theOfficial-IrvinGiL/Thesis-1-and-2-Documentations-and-Papers/notes/Question and answer on Thesis By Groupmates.txt

1. In few sentences, can you tell us what your study is all about?
2. What is your motivation for this study?
3. What is the significance of the study?
4. Did you bridge any gap from your study?
5. What limitations did you encounter?
7. What Methods or Sampling Technique did you employ?
8. Why choose this method(#7)?
10.  What are your research questions?
11. What are your research variables?
12. What theories or theoretical framework is your study based on?
13. What is the scope of the study?

How did you come up with your proposal?

Ang mga materials ba na atu gamiton available?

Unsay possible nga downside sa study?
