theOfficial-IrvinGiL/Thesis-1-and-2-Documentations-and-Papers/TASK_members/April 25 task.docx

Task: Documenting code in flowchart format

Description: Read and understand the code on the repositories and create a flowchart showing the methods and conditional statements that are written on the code. Use flow2code online application for easy flowchart documentation: https://code2flow.com/

Read the code on the zip file attached on the email.

Example:

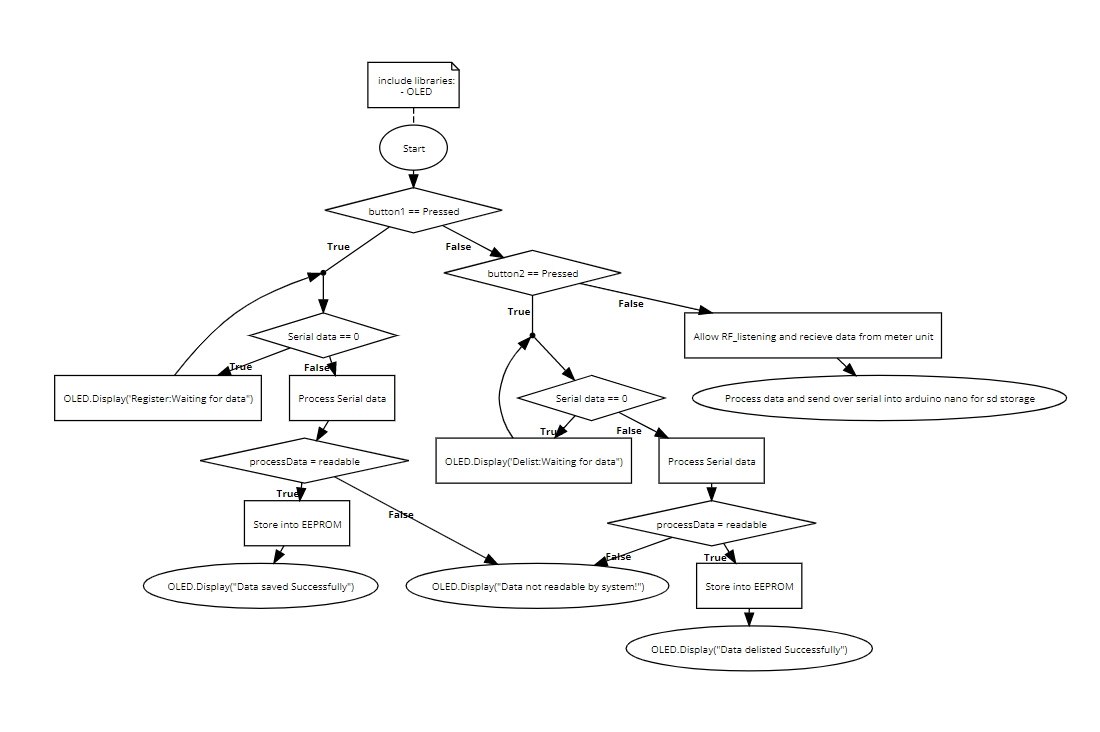
[picture p9: figure]

Assignees:

Main unit:

  - Mark Neil
  - Benjie
  - Michelle Ann

Meter Unit:

  - Lyndon
  - Renante
