theOfficial-IrvinGiL/Thesis-1-and-2-Documentations-and-Papers/TASK_members/Tasks compilation.docx

Task: March 28, 2022

Goal: Controlling Power on Arduino nano using MOSFET transistor

Direction:

1. Write code on the Arduino nano to write a few texts words on the sd card. (Just for sample). When turned on it continuously write words to the sd card with a 3 second delay. *mao ra na sija ang code nga anaa sa Arduino nano jud
2. Next, write a code on the Arduino nano to control the power on the Arduino nano by triggering a push button switch
  a. Push the switch and turn the Arduino nano on for it to write to the sd card
3. Inspect the sd card if It has written the correct data.

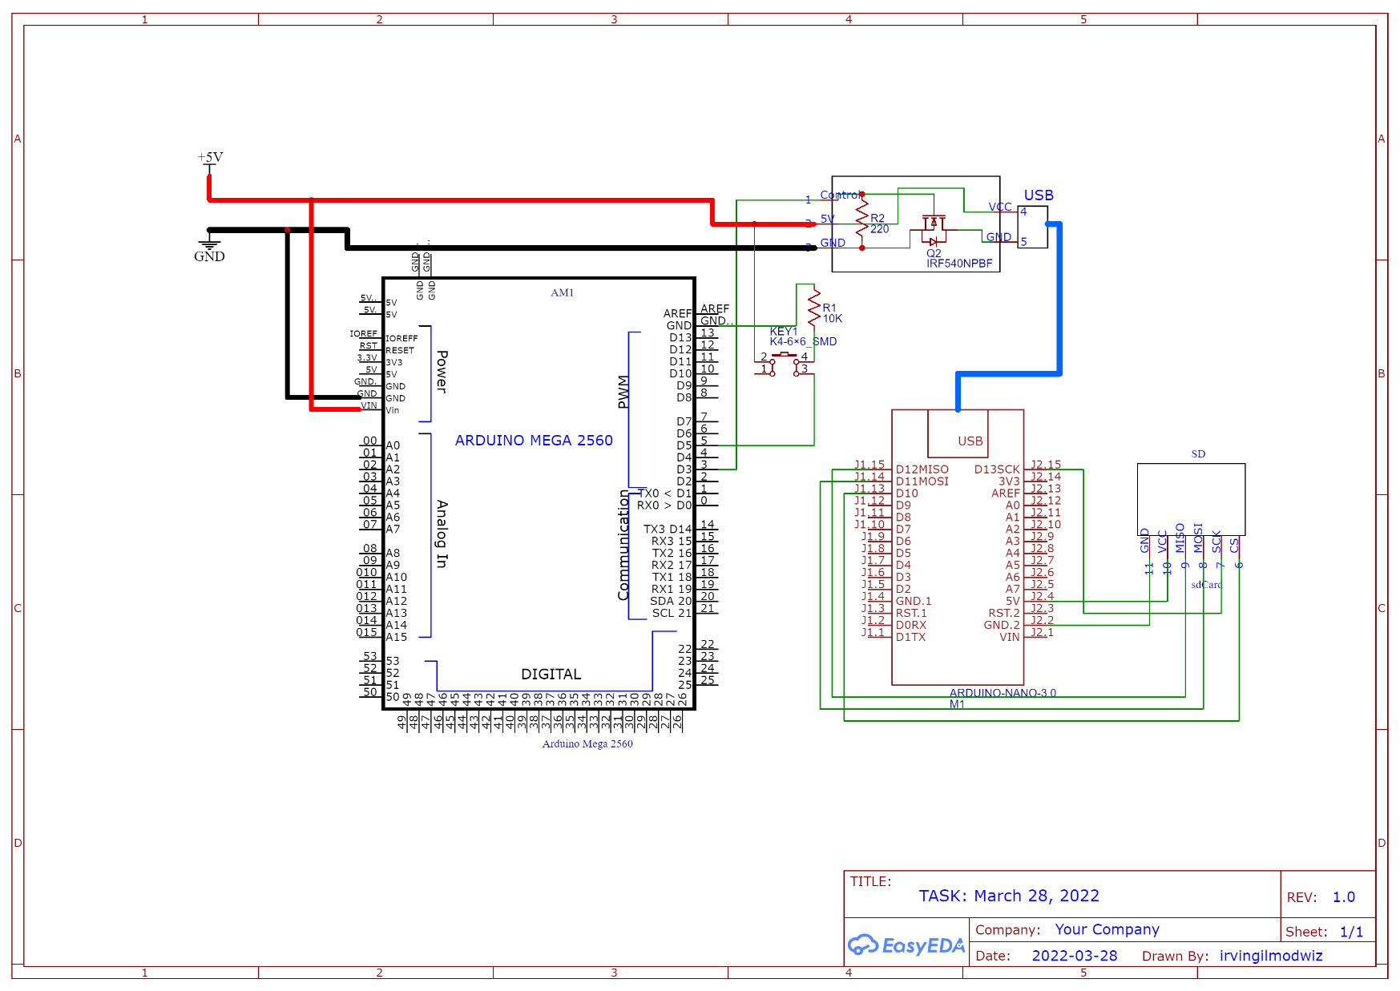
[picture p10: figure]
