theOfficial-IrvinGiL/Thesis-1-and-2-Documentations-and-Papers/notes/User interface and User Experience design for the software of the system..pdf

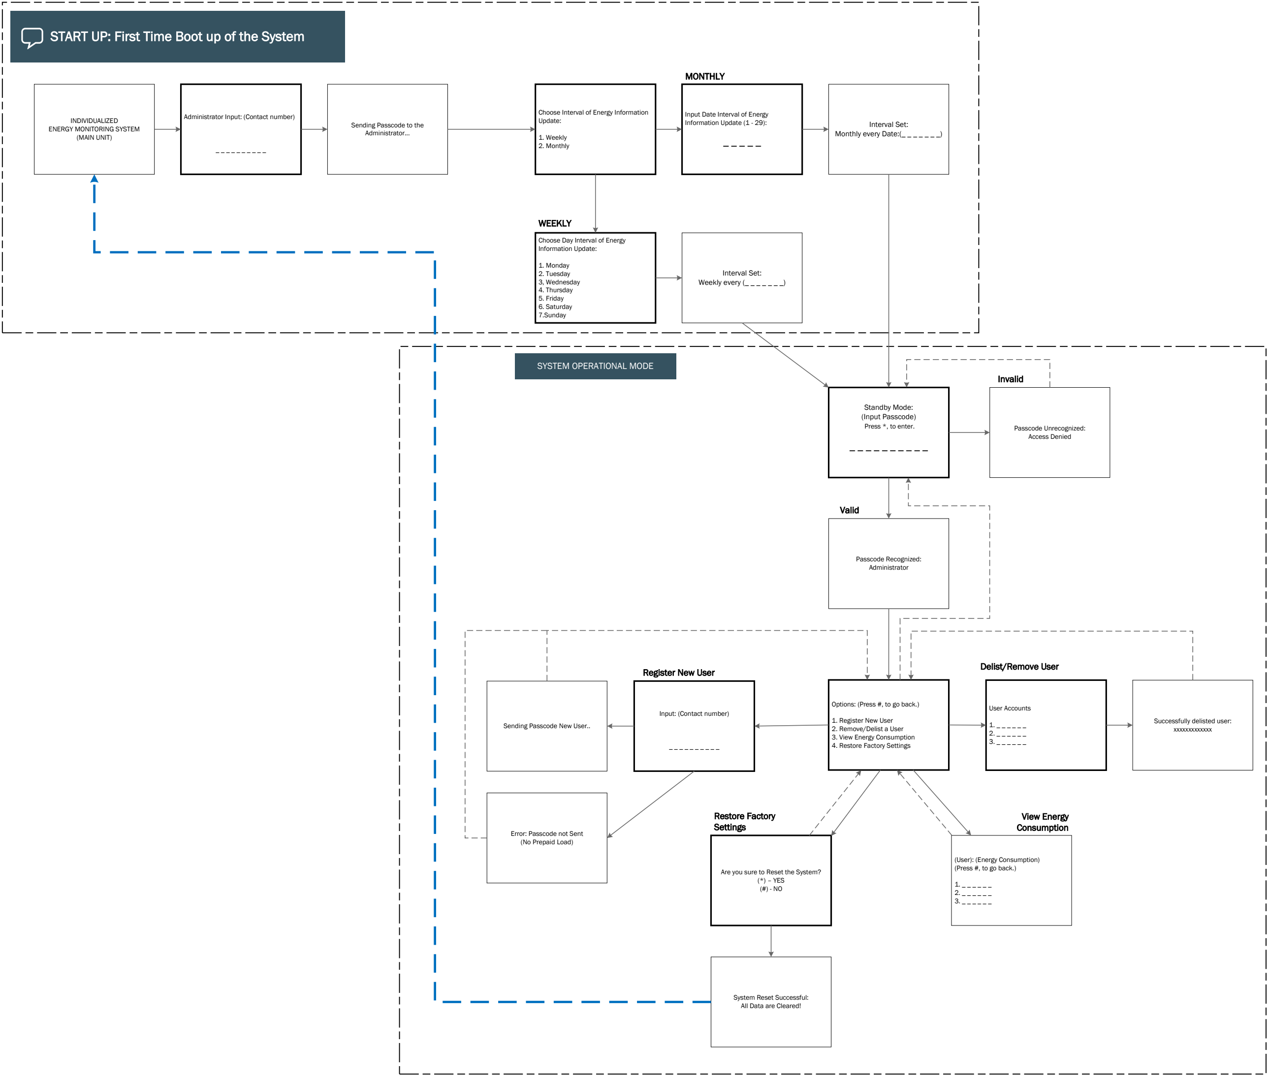
[picture p19: figure]
INDIVIDUALIZED ENERGY MONITORING SYSTEM (MAIN UNIT); Administrator Input: (Contact number); Sending Passcode to the Administrator...; Choose Interval of Energy Information Update:; 1. Weekly 2. Monthly; Choose Day Interval of Energy Information Update:; 1. Monday 2. Tuesday 3, Wednesday 4. Thursday 5. Friday 6. Saturday 7.Sunday; Input Date Interval of Energy Information Update (1 - 29):; MONTHLY; WEEKLY; Interval Set: Weekly every (_ _ _ _ _ _ _); Interval Set: Monthly every Date:(_ _ _ _ _ _ _); Standby Mode: (Input Passcode); Press *, to enter.; Options: (Press #, to go back.)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

# START UP: First Time Boot up of the System

# Main Unit_User Experience

## METER UNIT

# Main Unit_User Experience

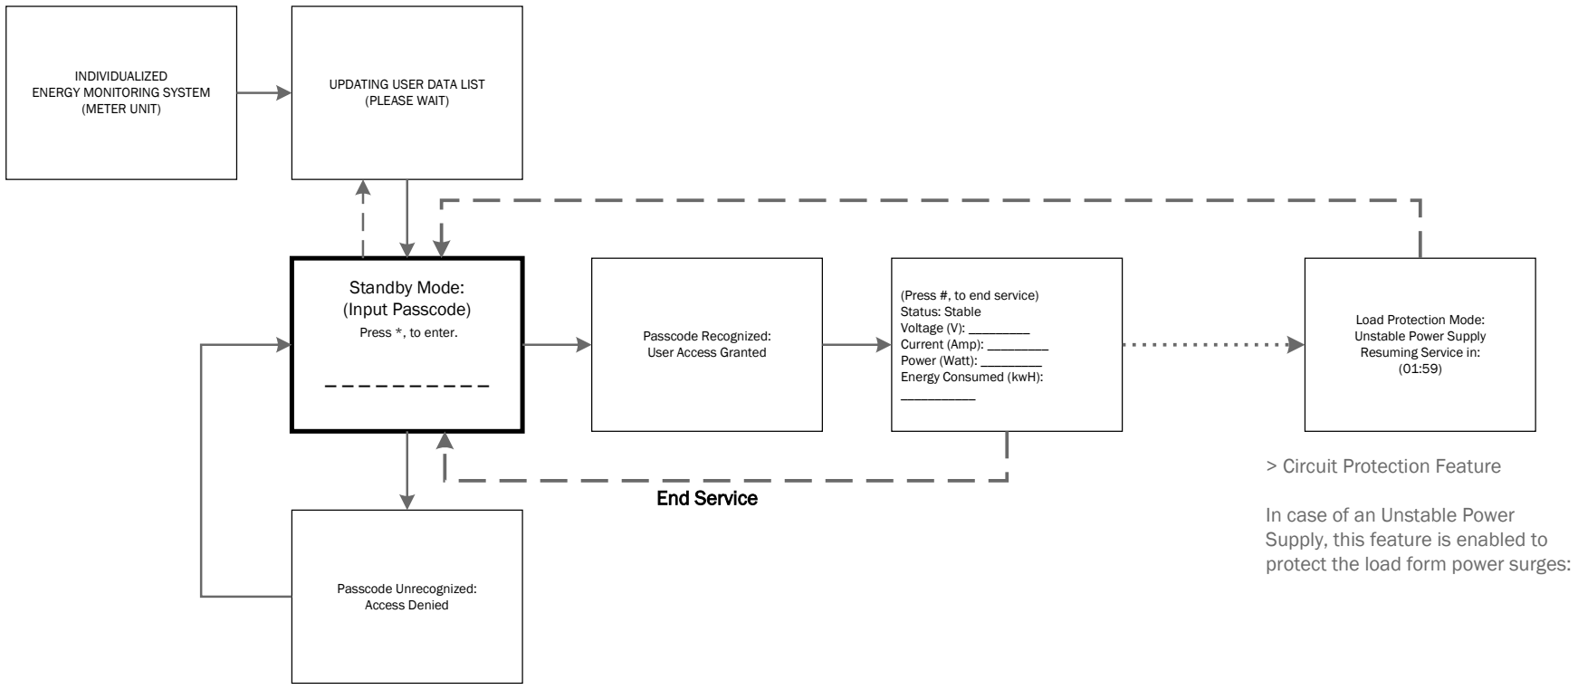
[picture p20: figure]
INDIVIDUALIZED ENERGY MONITORING SYSTEM (METER UNIT); Standby Mode: (Input Passcode); Press *, to enter.; UPDATING USER DATA LIST (PLEASE WAIT); Passcode Recognized: User Access Granted; Passcode Unrecognized: Access Denied; (Press #, to end service) Status: Stable Voltage (V): _________ Current (Amp): _________ Power (Watt): _________ Energy Consumed (kwH): ___________; End Service; Load Protection Mode: Unstable Power Supply Resuming Service in: (01:59); > Circuit Protection Feature; In case of an Unstable Power Supply, this feature is enabled to protect the load form power surges:
