theOfficial-IrvinGiL/Thesis-1-and-2-Documentations-and-Papers/CAD and System Schematics/Diagrams/for methods.pdf

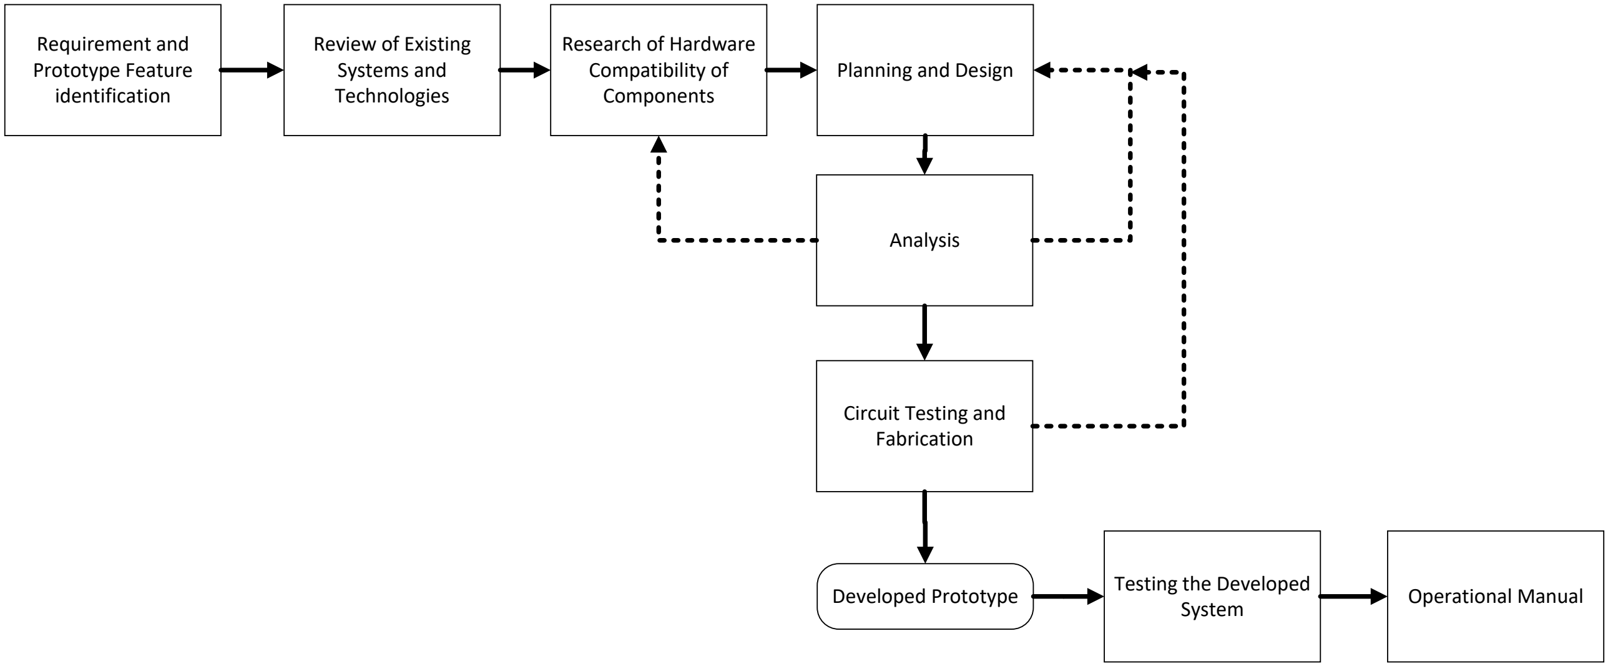
[picture p21: figure]
Requirement and Prototype Feature identification; Review of Existing Systems and Technologies; Research of Hardware Compatibility of Components; Analysis; Planning and Design; Circuit Testing and Fabrication; Developed Prototype; Testing the Developed System; Operational Manual

AC Power | Meter Unit
Smart Meter Main Unit | SMS Notification | Registered User

Electrical Load/
Gadgets and
Appliances

User Data Input
