theOfficial-IrvinGiL/Thesis-1-and-2-Documentations-and-Papers/CAD and System Schematics/new diagrams_REvised/Meter Unit.pdf

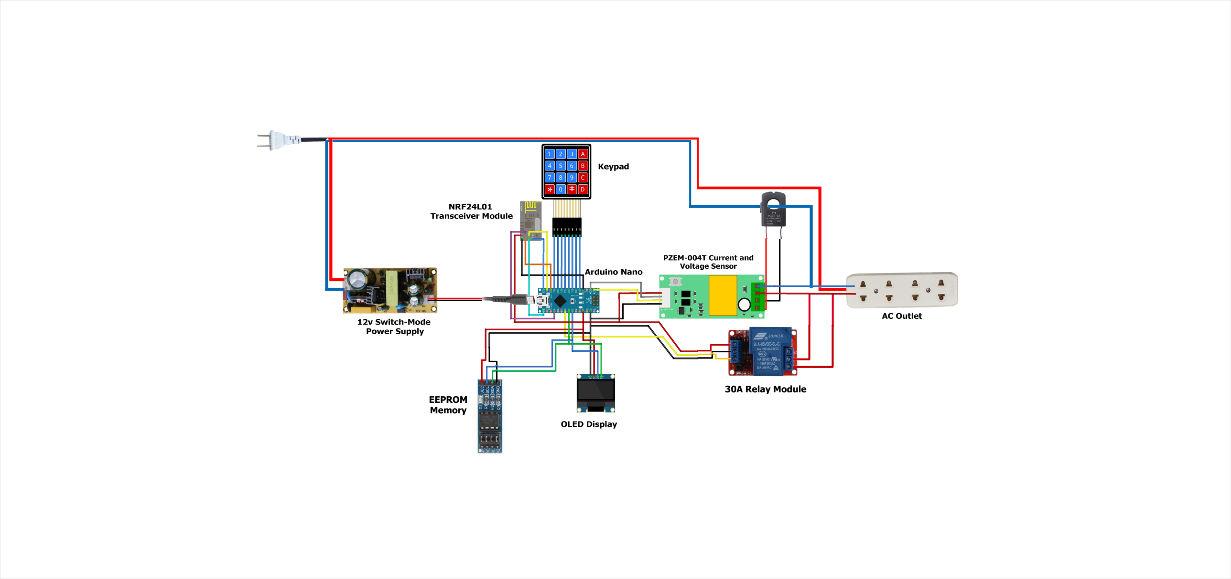
[picture p22: page 1]

EEPROM
Memory

30A Relay Module
