theOfficial-IrvinGiL/Thesis-1-and-2-Documentations-and-Papers/Main papers/concept diagrams for thesis methodology.pdf

Concept Design 1: Centralized Approach

Concept of Usage

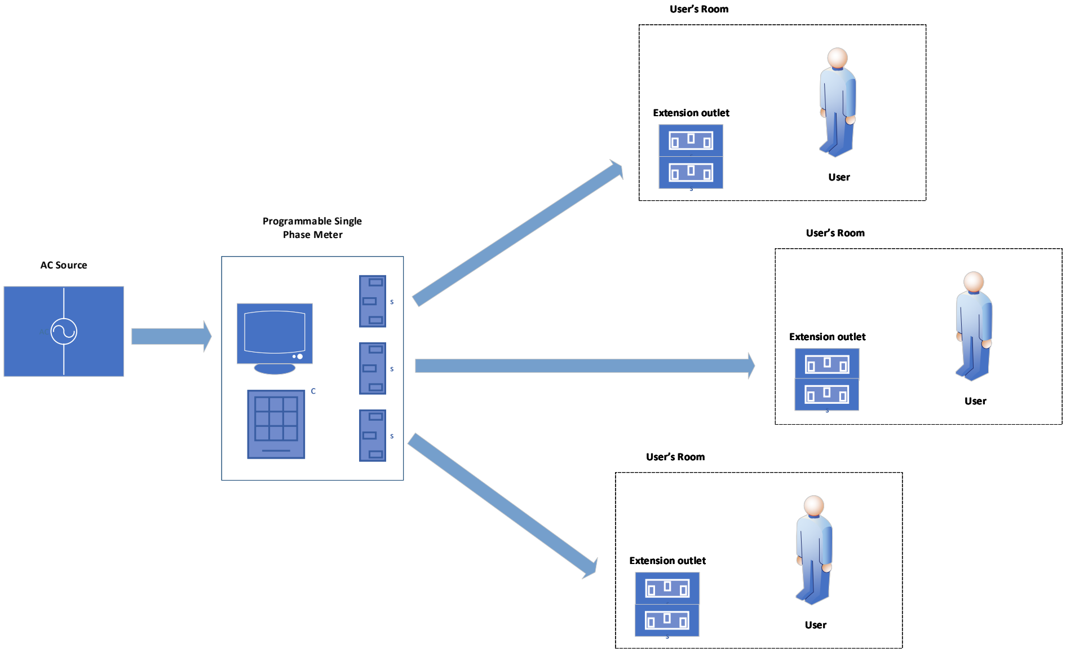
[picture p23: figure]
AC Source; Programmable Single Phase Meter; Extension outlet; User; User’s Room

Problems and Challenges

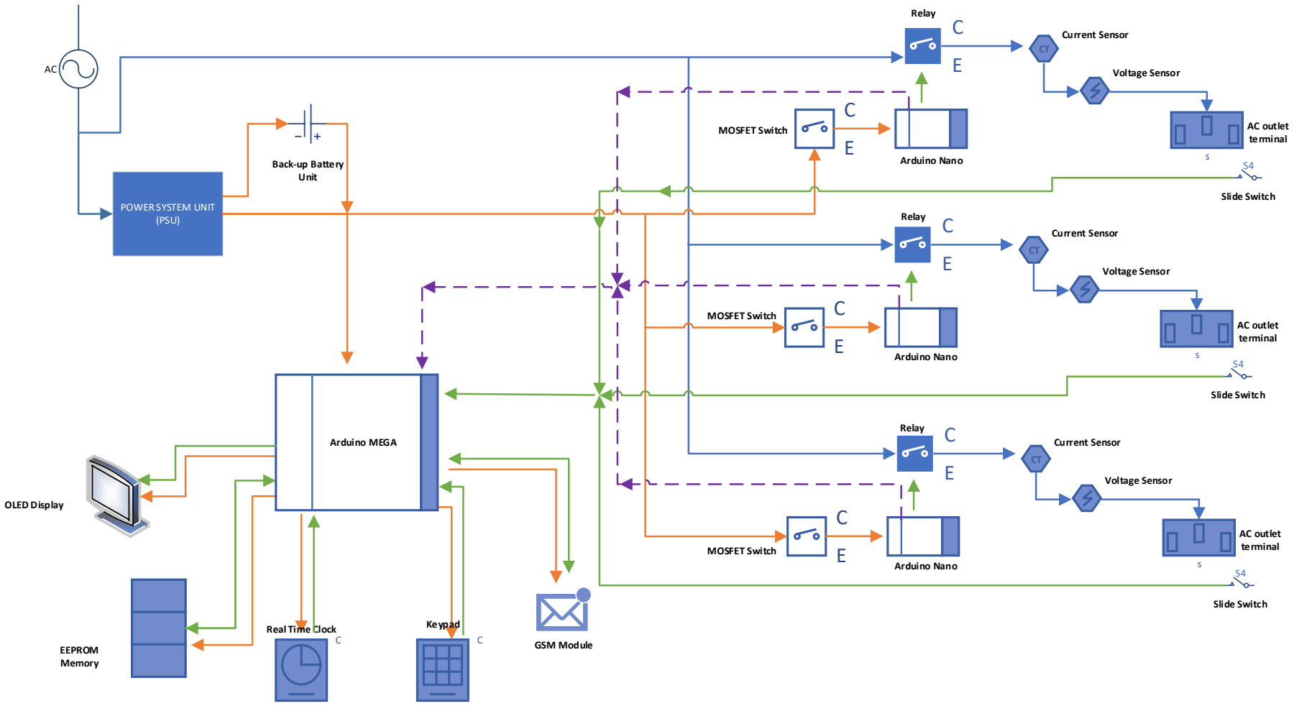
[picture p24: figure]
POWER SYSTEM UNIT (PSU); OLED Display; EEPROM Memory; Real Time Clock; Keypad; GSM Module; Back-up Battery Unit; Arduino MEGA; Current Sensor; Voltage Sensor; AC outlet terminal; Slide Switch; Arduino Nano; Relay; MOSFET Switch

Problems on the design and implementation of the prototype are:
1. How would the meter measure the simultaneous usage of different outlet by different users on the shared house?
2. It would be a hassle for the users of the system if they have to go to the location of the prototype to enter their code so they can access electricity.
3. The design’s scope of functionality could be limited and overwhelmed by the user expectation.
4. Take for am example scenario of:
Outlets (red circle) are in placement throughout the shared house and the smart meter (green circle) is placed on the middle side of the shared house. It is a hassle for the tenants to go to the meter evertime they would access electricity.

This Approach focuses all processes unto a single prototype, meaning all calculation and processes are integrated into one device. The systems allows only extension chords unto the room of different users. But this system shows the difficulty and lack of ease of use as the users have to go to the meter of request for validation and access to electricity.

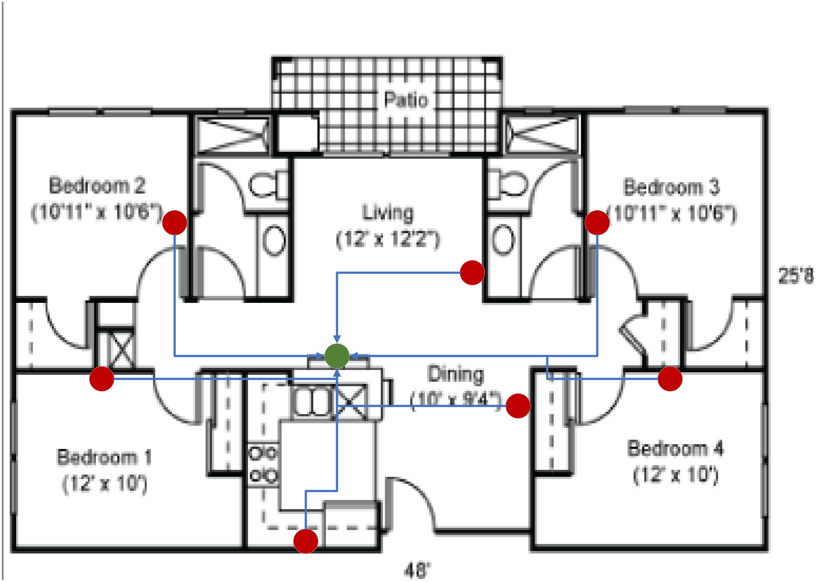
[picture p25: figure]

Concept Design 2: Wireless Client and Server Approach

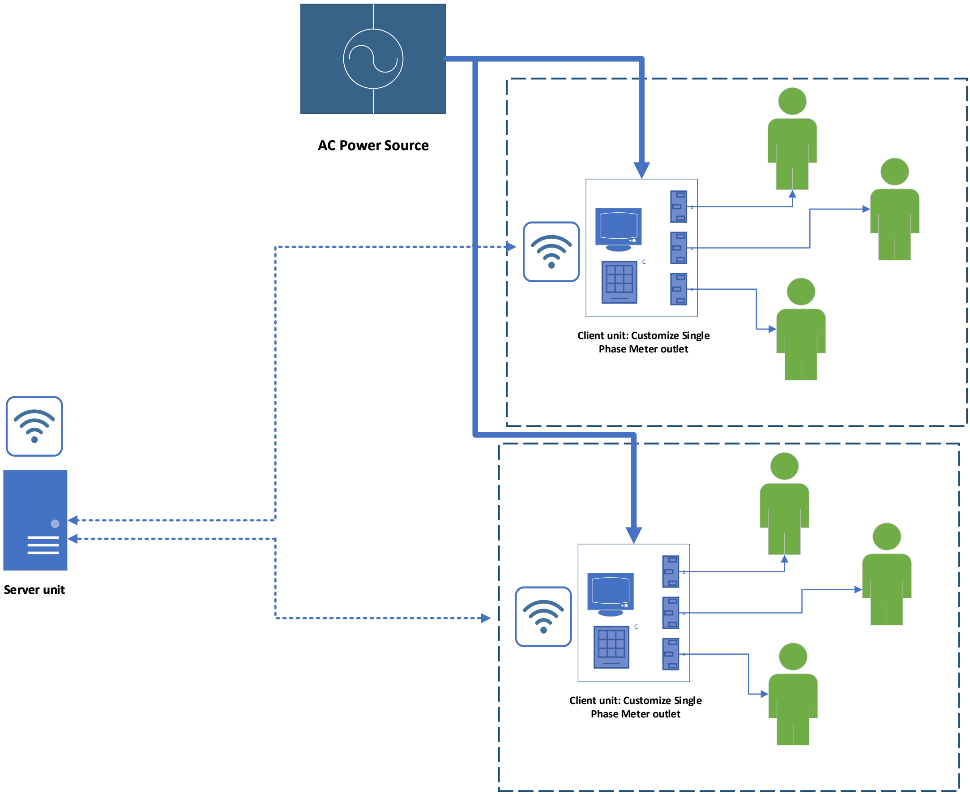
[picture p26: figure]
Server unit; AC Power Source; Client unit: Customize Single Phase Meter outlet

Concept of Usage

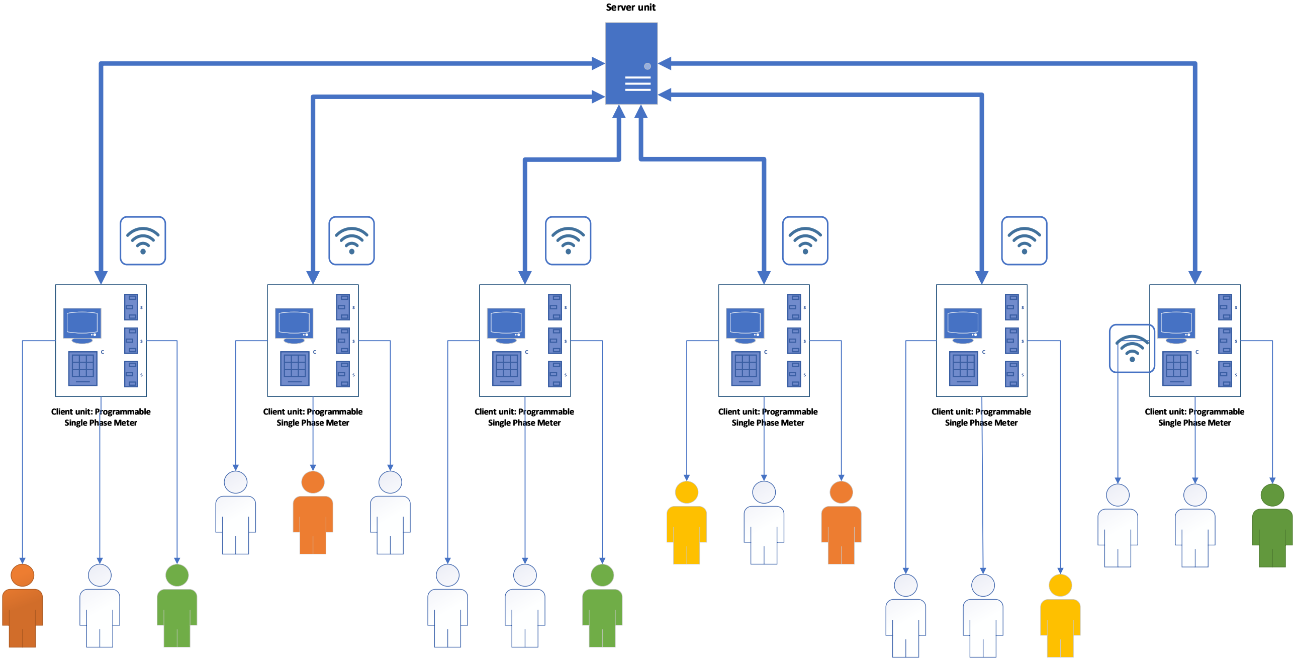
[picture p27: figure]
Server unit; Client unit: Programmable Single Phase Meter

Problems and Challenges

Advantages:
1. Wireless and Reduces risk of malfunction due to physical connectivity problems
2. If designed successfully: could eliminated the problem of simultaneous usage monitoring problem and efficiently measure power consumption of individuals

Disadvantages:
1. Increases the Systems complexity
2. Database management will be needed and Wifi or Bluetooth communications protocol will be implemented which would leave the environment full radio frequency signals.
3. Many errors are expected to arise due to data communication traffic between several devices.

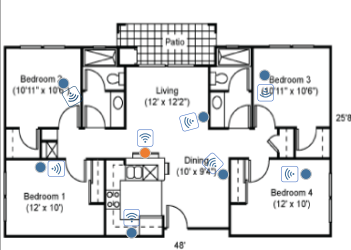
[picture p28: figure]

Concept Design 3: Extended Centralized Approach

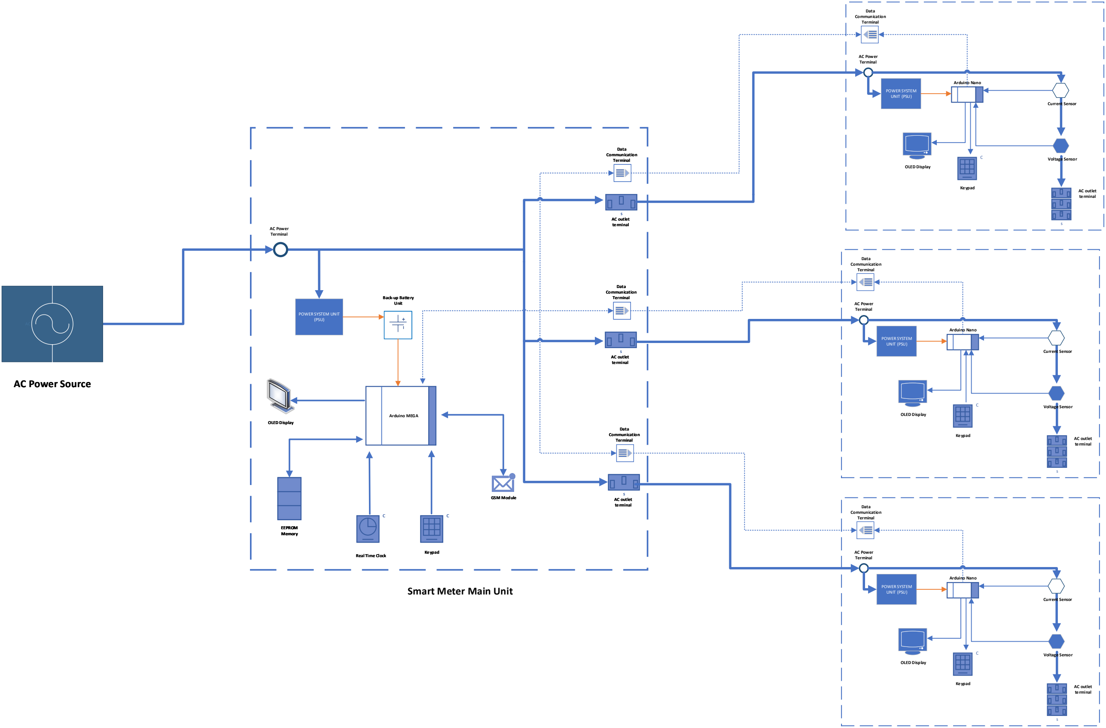
[picture p29: figure]
POWER SYSTEM UNIT (PSU); Arduino MEGA; Back-up Battery Unit; Real Time Clock; Keypad; OLED Display; GSM Module; EEPROM Memory; s AC outlet terminal; Data Communication Terminal; AC Power Terminal; Arduino Nano; Current Sensor; Voltage Sensor; AC outlet terminal; Smart Meter Main Unit; AC Power Source

Concept of Usage

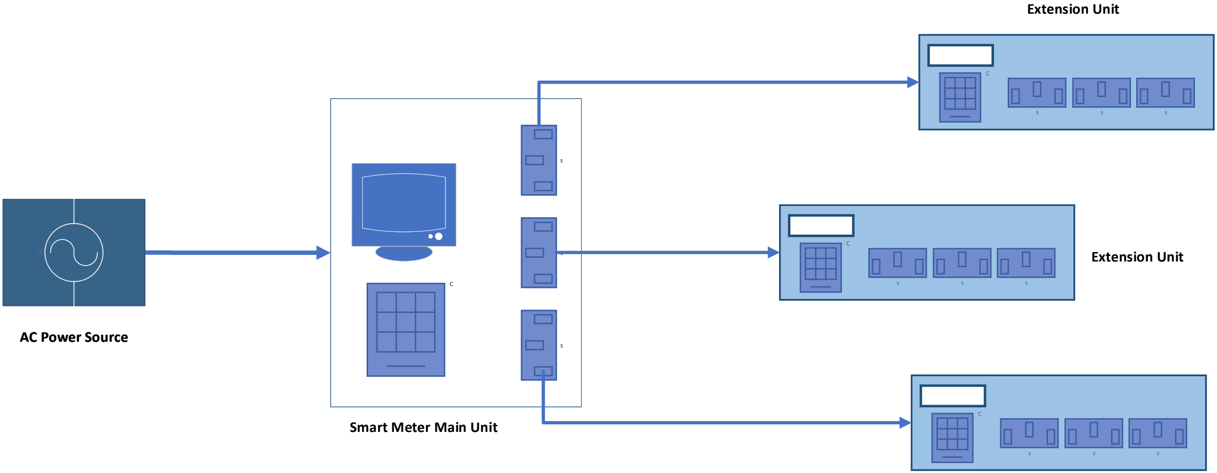
[picture p30: figure]
AC Power Source; Smart Meter Main Unit; Extension Unit

Problems and Challenges

Extension Unit

Extension Unit

Extension Unit

The advantages of this approach is that individual users can have or use the outlet exclusively therefore ensuring accurate measurement of their individual power consumption. Rules and Policy are need to be stablished when implementing the system so that no other user is going to connect to an outlet when its access is not validated under their name. Otherwise it could be considered breach in fairness and would to in accurate power monitoring. It much simple than the wireless method of putting up wireless devices throughout the whole building/house.

This Approach portrays a similar wired connection set up with electric measuring unit but in the case, specialized outlets are made that can be used by any user under the condition that only one user is allowed to solely use the extension outlet. There are 3 more terminals on the customized outlet for the user to use for another device and the energy consumption would still be recorded under his name.

Extension Unit

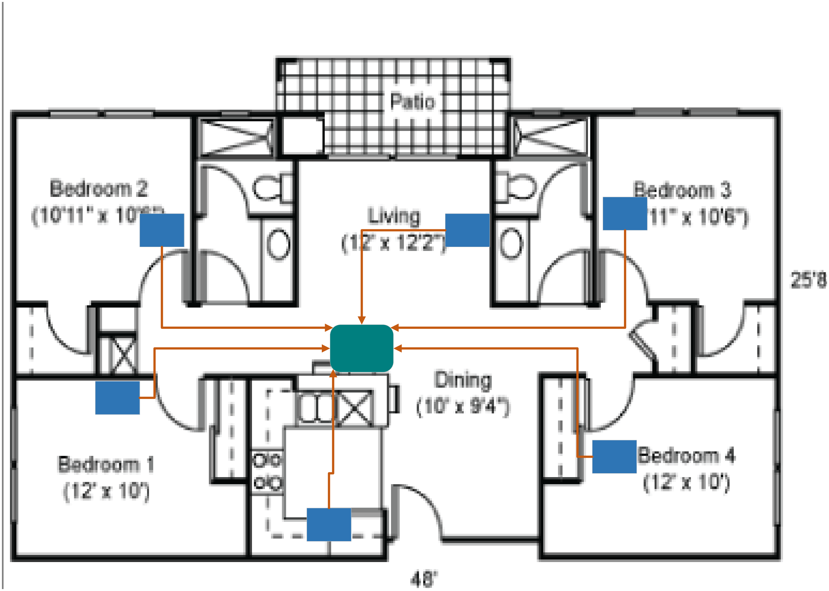
[picture p31: figure]
