theOfficial-IrvinGiL/Thesis-1-and-2-Documentations-and-Papers/Main papers/Proposal PPT/Main Presentation _ Individualized power monitoring.pdf

# INDIVIDUALIZED POWER

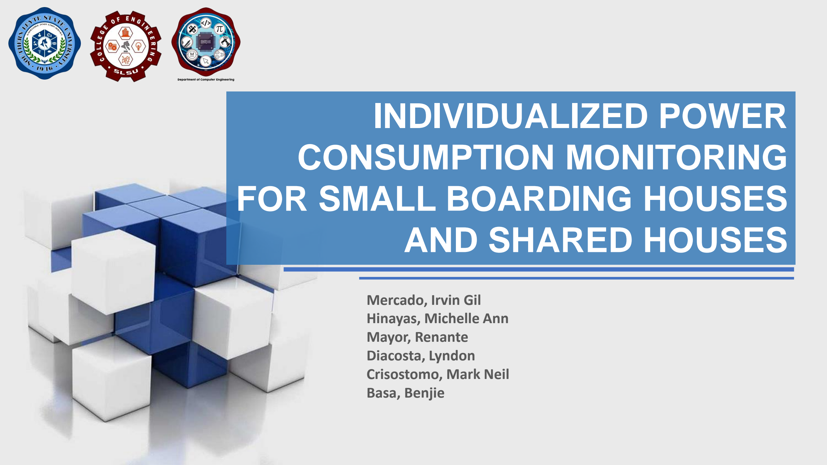
[picture p32: page 1]

# CONSUMPTION MONITORING FOR SMALL BOARDING HOUSES AND SHARED HOUSES

Mercado, Irvin Gil
Hinayas, Michelle Ann
Mayor, Renante
Diacosta, Lyndon
Crisostomo, Mark Neil
Basa, Benjie
