theOfficial-IrvinGiL/Thesis-1-and-2-Documentations-and-Papers/Main papers/Data_Log.xlsx

Sheet: Sorted data
Data Log |  |  |  | System Data
Date | User | Time |  | Passcode | Date | Time | Consumed | User |  | Sum of Consumed | Column Labels
2022-04-25 | Benjie L. Basa | 11:18:00 | 1 | 5373 | 2022-04-25 | 11:52:00 | 0.495 | Benjie Basa | 1 | Row Labels | Benjie Basa | Irvin Gil Mercado | John Melvin Caday | Lyndon Diacosta | Mark Neil Crisostomo | Raffy Aruta | Renante Mayor | Runnel Jay Barcelon | Solomon Lim | Grand Total
2022-04-25 | Irvin Gil Mercado | 11:53:00 | 0 | 2923 | 2022-04-26 | 6:15:00 | 0.497 | Irvin Gil Mercado | 1 | 2022-04-25 | 0.495 |  |  |  |  |  |  |  |  | 0.495
2022-04-25 | Lyndon Diacosta | 17:12:00 | 0 | 2267 | 2022-04-26 | 6:49:00 | 0.115 | Lyndon Diacosta | 1 | 11 AM
2022-04-25 | John Melvin Caday | 17:27:00 | 0 | 8866 | 2022-04-26 | 8:45:00 | 0.195 | Runnel Jay Barcelon | 1 | :52 | 0.495 |  |  |  |  |  |  |  |  | 0.495
2022-04-25 | Mark Neil Crisostomo | 18:39:00 | 0 | 5906 | 2022-04-26 | 9:15:00 | 0.192 | Solomon Lim | 1 | 2022-04-26 |  | 0.497 |  | 0.311 | 0.207 | 0.067 |  | 0.195 | 0.393 | 1.67
2022-04-26 | Irvin Gil Mercado | 5:35:00 | 1 | 2267 | 2022-04-26 | 12:03:00 | 0.196 | Lyndon Diacosta | 1 | 6 AM
2022-04-26 | Lyndon Diacosta | 6:48:00 | 1 | 5906 | 2022-04-26 | 16:14:00 | 0.201 | Solomon Lim | 1 | :15 |  | 0.497 |  |  |  |  |  |  |  | 0.497
2022-04-26 | Runel Jay Barcelon | 8:30:00 | 1 | 0553 | 2022-04-26 | 16:18:00 | 0.067 | Raffy Aruta | 1 | :49 |  |  |  | 0.115 |  |  |  |  |  | 0.115
2022-04-26 | Solomon Lim | 8:55:00 | 1 | 9644 | 2022-04-26 | 18:33:00 | 0.207 | Mark Neil Crisostomo | 1 | 8 AM
2022-04-26 | Lyndon Diacosta | 11:30:00 | 1 | 2923 | 2022-04-27 | 6:37:00 | 0.015 | Irvin Gil Mercado | 1 | :45 |  |  |  |  |  |  |  | 0.195 |  | 0.195
2022-04-26 | Solomon Lim | 15:51:00 | 1 | 2267 | 2022-04-27 | 6:44:00 | 0.07 | Lyndon Diacosta | 1 | 9 AM
2022-04-26 | Raffy Aruta | 16:16:00 | 1 | 9880 | 2022-04-27 | 9:45:00 | 0.199 | John Melvin Caday | 1 | :15 |  |  |  |  |  |  |  |  | 0.192 | 0.192
2022-04-27 | Lyndon Diacosta | 5:45:00 | 0 | 2923 | 2022-04-27 | 13:53:00 | 0.045 | Irvin Gil Mercado | 1 | 12 PM
2022-04-27 | Lyndon Diacosta | 6:41:00 | 1 | 5906 | 2022-04-27 | 17:03:00 | 0.039 | Solomon Lim | 1 | :03 |  |  |  | 0.196 |  |  |  |  |  | 0.196
2022-04-27 | Irvin Gil Mercado | 6:44:00 | 0 | 5373 | 2022-04-27 | 17:38:00 | 0.284 | Benjie Basa | 1 | 4 PM
2022-04-27 | John Melvin Caday | 9:45:00 | 1 | 5906 | 2022-04-27 | 18:09:00 | 0.193 | Solomon Lim | 1 | :14 |  |  |  |  |  |  |  |  | 0.201 | 0.201
2022-04-27 | Irvin Gil Mercado | 13:54:00 | 1 | 2267 | 2022-04-27 | 22:13:00 | 0.098 | Lyndon Diacosta | 1 | :18 |  |  |  |  |  | 0.067 |  |  |  | 0.067
2022-04-27 | Benjie L. Basa | 17:17:00 | 1 | 8866 | 2022-04-28 | 8:42:00 | 0.189 | Runnel Jay Barcelon | 1 | 6 PM
2022-04-27 | Solomon Lim | 17:50:00 | 1 | 2923 | 2022-04-28 | 12:13:00 | 0.203 | Irvin Gil Mercado | 1 | :33 |  |  |  |  | 0.207 |  |  |  |  | 0.207
2022-04-27 | Lyndon Diacosta | 22:00:00 | 1 | 0007 | 2022-04-28 | 16:38:00 | 0.05 | Renante Mayor | 1 | 2022-04-27 | 0.284 | 0.06 | 0.199 | 0.168 |  |  |  |  | 0.232 | 0.943
2022-04-28 | Irvin Gil Mercado | 5:10:00 | 0 |  |  |  |  |  |  | 6 AM
2022-04-28 | Lyndon Diacosta | 6:30:00 | 0 |  |  |  |  |  |  | :37 |  | 0.015 |  |  |  |  |  |  |  | 0.015
2022-04-28 | Lyndon Diacosta | 7:09:00 | 0 |  |  |  |  |  |  | :44 |  |  |  | 0.07 |  |  |  |  |  | 0.07
2022-04-28 | Lyndon Diacosta | 7:23:00 | 0 |  |  |  |  |  |  | 9 AM
2022-04-28 | Runel Jay Barcelon | 8:12:00 | 1 |  |  |  |  |  |  | :45 |  |  | 0.199 |  |  |  |  |  |  | 0.199
2022-04-28 | Irvin Gil Mercado | 11:44:00 | 1 |  |  |  |  |  |  | 1 PM
2022-04-28 | Renante Mayor | 16:37:00 | 1 |  |  |  |  |  |  | :53 |  | 0.045 |  |  |  |  |  |  |  | 0.045
 |  |  |  |  |  |  |  |  |  | 5 PM
 |  |  |  |  |  |  |  |  |  | :03 |  |  |  |  |  |  |  |  | 0.039 | 0.039
 |  |  |  |  |  |  |  |  |  | :38 | 0.284 |  |  |  |  |  |  |  |  | 0.284
 |  |  |  |  |  |  |  |  |  | 6 PM
 |  |  |  |  |  |  |  |  |  | :09 |  |  |  |  |  |  |  |  | 0.193 | 0.193
2923 | Irvin Gil Mercado |  |  |  |  |  |  |  |  | 10 PM
5373 | Benjie Basa |  |  |  |  |  |  |  |  | :13 |  |  |  | 0.098 |  |  |  |  |  | 0.098
0007 | Renante Mayor |  |  |  |  |  |  |  |  | 2022-04-28 |  | 0.203 |  |  |  |  | 0.05 | 0.189 |  | 0.442
9644 | Mark Neil Crisostomo |  |  |  |  |  |  |  |  | 8 AM
2267 | Lyndon Diacosta |  |  |  |  |  |  |  |  | :42 |  |  |  |  |  |  |  | 0.189 |  | 0.189
5906 | Solomon Lim |  |  |  |  |  |  |  |  | 12 PM
0553 | Raffy Aruta |  |  |  |  |  |  |  |  | :13 |  | 0.203 |  |  |  |  |  |  |  | 0.203
4900 | John Lerie Cadarve |  |  |  |  |  |  |  |  | 4 PM
9880 | John Melvin Caday |  |  |  |  |  |  |  |  | :38 |  |  |  |  |  |  | 0.05 |  |  | 0.05
8866 | Runnel Jay Barcelon |  |  |  |  |  |  |  |  | Grand Total | 0.779 | 0.76 | 0.199 | 0.479 | 0.207 | 0.067 | 0.05 | 0.384 | 0.625 | 3.55

Sheet: System performance assessment
Date | Use index | User data log | System data log
2022-04-25 | 1 | 11:18:00 | 11:52:00
2022-04-26 | 2 | 5:35:00 | 6:15:00
 | 3 | 6:48:00 | 6:49:00
 | 4 | 8:30:00 | 8:45:00
 | 5 | 8:55:00 | 9:15:00
 | 6 | 11:30:00 | 12:03:00
 | 7 | 15:51:00 | 16:14:00
 | 8 | 16:16:00 | 16:18:00
2022-04-27 | 9 | 5:45:00 | 6:37:00
 | 10 | 6:41:00 | 6:44:00
 | 11 | 6:44:00 | 9:45:00
 | 12 | 9:45:00 | 13:53:00
 | 13 | 13:54:00 | 17:03:00
 | 14 | 17:17:00 | 17:38:00
 | 15 | 17:50:00 | 18:09:00
 | 16 | 22:00:00 | 22:13:00
2022-04-28 | 17 | 5:10:00 | 8:42:00
 | 18 | 6:30:00 | 12:13:00
 | 19 | 7:09:00 | 16:38:00

Sheet: Schedule project
Activities | August |  |  |  | September |  |  |  | October |  |  |  | November |  |  |  | December |  |  |  | January |  |  |  | February |  |  |  | March |  |  |  | April
 | Week 1 | Week 2 | Week 3 | Week 4 | Week 1 | Week 2 | Week 3 | Week 4 | Week 1 | Week 2 | Week 3 | Week 4 | Week 1 | Week 2 | Week 3 | Week 4 | Week 1 | Week 2 | Week 3 | Week 4 | Week 1 | Week 2 | Week 3 | Week 4 | Week 1 | Week 2 | Week 3 | Week 4 | Week 1 | Week 2 | Week 3 | Week 4 | Week 1 | Week 2 | Week 3 | Week 4
Planning and Research
Purchasing of Materials
Testing of Components
Coding
Coordinating the Code and System
Fabrication
System Testing and Troubleshooting
System Implementation and Operation
Data Gathering, Conclusion and Completion

Sheet: Statistical result
Range
4.0-3.01 | Strongly Agree
3.0-2.01 | Agree
2.0-1.01 | Disagree
1.0-0 | Strongly disagree
 |  |  |  |  |  |  |  |  |  | SA | A | D | SD
Respondent | Question 1 | Question 2 | Question 3 | Question 4 | Question 5 | Question 6 | Question 7 |  | 1. The system’s authentication and security features work without any problems. | 5 | 4 | 1
1 | 3 | 4 | 4 | 3 | 3 | 4 | 4 |  | 2. The operational manual of the system is easy to comprehend and understand. | 10
2 | 3 | 4 | 4 | 4 | 4 | 4 | 4 |  | 3. Users were informed and notified about their personal electricity energy consumption. | 10
3 | 3 | 4 | 4 | 3 | 3 | 4 | 4 |  | 4. The date and time of use of each user of the system were successfully monitored. | 4 | 5 | 1
4 | 4 | 4 | 4 | 3 | 3 | 4 | 4 |  | 5. The developed electric energy monitoring system is safe and risk-free. | 6 | 4
5 | 4 | 4 | 4 | 4 | 3 | 4 | 4 |  | 6. The application of the developed system is truly suited and highly feasible for shared residential establishments and boarding houses. | 10
6 | 4 | 4 | 4 | 4 | 4 | 4 | 4 |  | 7. The overall design and functionality of the system is easy to use and user-friendly. | 10
7 | 4 | 4 | 4 | 2 | 4 | 4 | 4
8 | 3 | 4 | 4 | 3 | 4 | 4 | 4
9 | 2 | 4 | 4 | 4 | 4 | 4 | 4
10 | 4 | 4 | 4 | 3 | 4 | 4 | 4
Average | 3.4 | 4 | 4 | 3.3 | 3.6 | 4 | 4 | 3.757142857
Interpretation | SA | SA | SA | SA | SA | SA | SA
SA | 5 | 10 | 10 | 4 | 6 | 10 | 10
A | 4 |  |  | 5 | 4
D | 1 |  |  | 1
SD

Sheet: Meter unit accuracy test
No load
 | Trial 1 |  |  | Average total percentage error
 | Voltage | Current (Amp) |  | Voltage | Current (Amp)
System meter unit | 235.2 | 0 |  | 0.1078819429 | 6.501531148
Multimeter | 235 | 0
Percentage error (%): | 0.08510638298
 |  |  |  |  |  |  |  |  | Appliance/Load | Average voltage percentage error | Average current percentage error
Rice cooker |  |  |  |  |  |  |  |  | Rice cooker | 0.085 | 0.449
 | Trial 1 |  | Trial 2 |  | Trial 3 |  | Average percentage error |  | Heater | 0.143 | 2.273
 | Voltage | Current (Amp) | Voltage | Current (Amp) | Voltage | Current (Amp) | Voltage | Current (Amp) | Standard fan | 0.099 | 3.139
System meter unit | 235.7 | 2.15 | 235 | 2.17 | 236.7 | 2.17 |  |  | Soldering iron | 0.114 | 3.313
Multimeter | 235.4 | 2.14 | 235.2 | 2.163 | 236.8 | 2.158 |  |  | LED lamp | 0.099 | 23.333
Percentage error (%): | 0.1274426508 | 0.4672897196 | 0.08503401361 | 0.3236245955 | 0.04222972973 | 0.5560704356 | 0.08490213138 | 0.4489949169 | Average | 0.108 | 6.502
Heater
 | Trial 1 |  | Trial 2 |  | Trial 3 |  | Average percentage error
 | Voltage | Current (Amp) | Voltage | Current (Amp) | Voltage | Current (Amp) | Voltage | Current (Amp)
System meter unit | 237.39 | 6.18 | 236.8 | 6.29 | 236.89 | 6.315
Multimeter | 237.6 | 6.07 | 237.4 | 6.196 | 237.1 | 6.102
Percentage error (%): | 0.08838383838 | 1.812191104 | 0.2527379949 | 1.517107811 | 0.08857022353 | 3.4906588 | 0.1432306856 | 2.273319239
Standard fan
 | Trial 1 |  | Trial 2 |  | Trial 3 |  | Average percentage error
 | Voltage | Current (Amp) | Voltage | Current (Amp) | Voltage | Current (Amp) | Voltage | Current (Amp)
System meter unit | 236.7 | 0.212 | 235.5 | 0.226 | 235.6 | 0.229
Multimeter | 236.9 | 0.213 | 235.7 | 0.21 | 235.9 | 0.226
Percentage error (%): | 0.08442380751 | 0.4694835681 | 0.08485362749 | 7.619047619 | 0.1271725307 | 1.327433628 | 0.09881665525 | 3.138654938
Soldering iron
 | Trial 1 |  | Trial 2 |  | Trial 3 |  | Average percentage error
 | Voltage | Current (Amp) | Voltage | Current (Amp) | Voltage | Current (Amp) | Voltage | Current (Amp)
System meter unit | 236.8 | 0.147 | 236.89 | 0.145 | 236.6 | 0.145
Multimeter | 237.2 | 0.143 | 237 | 0.14 | 236.9 | 0.14
Percentage error (%): | 0.1686340641 | 2.797202797 | 0.04641350211 | 3.571428571 | 0.1266357113 | 3.571428571 | 0.1138944258 | 3.313353313
LED Lamp
 | Trial 1 |  | Trial 2 |  | Trial 3 |  | Average percentage error
 | Voltage | Current (Amp) | Voltage | Current (Amp) | Voltage | Current (Amp) | Voltage | Current (Amp)
System meter unit | 236.6 | 0.037 | 236.5 | 0.037 | 236.3 | 0.037
Multimeter | 236.9 | 0.03 | 236.7 | 0.03 | 236.5 | 0.03
Percentage error (%): | 0.1266357113 | 23.33333333 | 0.08449514153 | 23.33333333 | 0.08456659619 | 23.33333333 | 0.09856581633 | 23.33333333

Sheet: sample
5373_4/24/2022_22:0_0.000 |  | Passcode | Date | Time | Consumption | User | Sum of Consumption | Column Labels
2923_4/25/2022_5:39_0.000 |  | 5373 | 4/24/2022 | 22:00:00 | 0 | Benjie Basa | Row Labels | Benjie Basa | Irvin Gil Mercado | John Lerie Cadarve | John Melvin Caday | Lyndon Diacosta | Mark Neil Crisostomo | Renante Mayor | Runnel Jay Barcelon | Solomon Lim | Grand Total
2923_4/25/2022_5:39_0.000 |  | 2923 | 4/25/2022 | 5:39:00 | 0 | Irvin Gil Mercado | 4/24/2022 | 0 |  |  |  |  |  |  |  |  | 0
2923_4/25/2022_6:4_0.056 |  | 2923 | 4/25/2022 | 5:39:00 | 0 | Irvin Gil Mercado | 10 pm | 0 |  |  |  |  |  |  |  |  | 0
2267_4/25/2022_7:59_0.338 |  | 2923 | 4/25/2022 | 6:04:00 | 0.056 | Irvin Gil Mercado | 4/25/2022 | 0.495 | 0.056 | 0 |  | 0.338 |  | 0 | 0 |  | 0.889
5373_4/25/2022_11:52_0.495 |  | 2267 | 4/25/2022 | 7:59:00 | 0.338 | Lyndon Diacosta | 5 am |  | 0 |  |  |  |  |  |  |  | 0
0007_4/25/2022_19:40_0.000 |  | 5373 | 4/25/2022 | 11:52:00 | 0.495 | Benjie Basa | 6 am |  | 0.056 |  |  |  |  |  |  |  | 0.056
2923_4/25/2022_19:44_0.000 |  | 7 | 4/25/2022 | 19:40:00 | 0 | Renante Mayor | 7 am |  |  |  |  | 0.338 |  |  |  |  | 0.338
8866_4/25/2022_20:5_0.000 |  | 2923 | 4/25/2022 | 19:44:00 | 0 | Irvin Gil Mercado | 11 am | 0.495 |  |  |  |  |  |  |  |  | 0.495
2267_4/25/2022_20:23_0.000 |  | 8866 | 4/25/2022 | 20:05:00 | 0 | Runnel Jay Barcelon | 7 pm |  | 0 |  |  |  |  | 0 |  |  | 0
4900_4/25/2022_22:39_0.000 |  | 2267 | 4/25/2022 | 20:23:00 | 0 | Lyndon Diacosta | 8 pm |  |  |  |  | 0 |  |  | 0 |  | 0
5906_4/26/2022_5:25_0.000 |  | 4900 | 4/25/2022 | 22:39:00 | 0 | John Lerie Cadarve | 10 pm |  |  | 0 |  |  |  |  |  |  | 0
2923_4/26/2022_6:15_0.497 |  | 5906 | 4/26/2022 | 5:25:00 | 0 | Solomon Lim | 4/26/2022 | 0 | 0.497 |  |  | 0.115 | 0.209 | 0 |  | 0 | 0.821
2267_4/26/2022_6:49_0.115 |  | 2923 | 4/26/2022 | 6:15:00 | 0.497 | Irvin Gil Mercado | 5 am |  |  |  |  |  |  |  |  | 0 | 0
2923_4/26/2022_11:10_0.000 |  | 2267 | 4/26/2022 | 6:49:00 | 0.115 | Lyndon Diacosta | 6 am |  | 0.497 |  |  | 0.115 |  |  |  |  | 0.612
9644_4/26/2022_17:3_0.001 |  | 2923 | 4/26/2022 | 11:10:00 | 0 | Irvin Gil Mercado | 11 am |  | 0 |  |  |  |  |  |  |  | 0
9644_4/26/2022_17:14_0.001 |  | 9644 | 4/26/2022 | 17:03:00 | 0.001 | Mark Neil Crisostomo | 5 pm | 0 |  |  |  |  | 0.002 | 0 |  |  | 0.002
0007_4/26/2022_17:54_0.000 |  | 9644 | 4/26/2022 | 17:14:00 | 0.001 | Mark Neil Crisostomo | 6 pm |  |  |  |  |  | 0.207 | 0 |  |  | 0.207
0007_4/26/2022_17:56_0.000 |  | 7 | 4/26/2022 | 17:54:00 | 0 | Renante Mayor | 4/27/2022 | 0.284 | 0.06 |  | 0.199 | 0.168 |  |  |  | 0.232 | 0.943
9644_4/26/2022_17:57_0.000 |  | 7 | 4/26/2022 | 17:56:00 | 0 | Renante Mayor | 6 am |  | 0.015 |  |  | 0.07 |  |  |  |  | 0.085
5373_4/26/2022_17:59_0.000 |  | 9644 | 4/26/2022 | 17:57:00 | 0 | Mark Neil Crisostomo | 9 am |  |  |  | 0.199 |  |  |  |  |  | 0.199
0007_4/26/2022_18:0_0.000 |  | 5373 | 4/26/2022 | 17:59:00 | 0 | Benjie Basa | 1 pm |  | 0.045 |  |  |  |  |  |  |  | 0.045
9644_4/26/2022_18:33_0.207 |  | 7 | 4/26/2022 | 18:00:00 | 0 | Renante Mayor | 5 pm | 0.284 |  |  |  | 0 |  |  |  | 0.039 | 0.323
2923_4/27/2022_6:37_0.015 |  | 9644 | 4/26/2022 | 18:33:00 | 0.207 | Mark Neil Crisostomo | 6 pm |  |  |  |  |  |  |  |  | 0.193 | 0.193
2267_4/27/2022_6:44_0.070 |  | 2923 | 4/27/2022 | 6:37:00 | 0.015 | Irvin Gil Mercado | 10 pm |  |  |  |  | 0.098 |  |  |  |  | 0.098
9880_4/27/2022_9:45_0.199 |  | 2267 | 4/27/2022 | 6:44:00 | 0.07 | Lyndon Diacosta | 4/28/2022 |  |  |  |  |  |  | 0 |  |  | 0
2923_4/27/2022_13:53_0.045 |  | 9880 | 4/27/2022 | 9:45:00 | 0.199 | John Melvin Caday | 9 am |  |  |  |  |  |  | 0 |  |  | 0
5906_4/27/2022_17:3_0.039 |  | 2923 | 4/27/2022 | 13:53:00 | 0.045 | Irvin Gil Mercado | Grand Total | 0.779 | 0.613 | 0 | 0.199 | 0.621 | 0.209 | 0 | 0 | 0.232 | 2.653
5373_4/27/2022_17:38_0.284 |  | 5906 | 4/27/2022 | 17:03:00 | 0.039 | Solomon Lim
2267_4/27/2022_17:41_0.000 |  | 5373 | 4/27/2022 | 17:38:00 | 0.284 | Benjie Basa
5906_4/27/2022_18:9_0.193 |  | 2267 | 4/27/2022 | 17:41:00 | 0 | Lyndon Diacosta
2267_4/27/2022_22:13_0.098 |  | 5906 | 4/27/2022 | 18:09:00 | 0.193 | Solomon Lim
0007_4/28/2022_9:8_0.000 |  | 2267 | 4/27/2022 | 22:13:00 | 0.098 | Lyndon Diacosta
 |  | 7 | 4/28/2022 | 9:08:00 | 0 | Renante Mayor
2923 | Irvin Gil Mercado
5373 | Benjie Basa
7 | Renante Mayor
9644 | Mark Neil Crisostomo
2267 | Lyndon Diacosta
5906 | Solomon Lim
553 | Raffy Aruta
4900 | John Lerie Cadarve
9880 | John Melvin Caday
8866 | Runnel Jay Barcelon
