theOfficial-IrvinGiL/Thesis-1-and-2-Documentations-and-Papers/notes/reference papers/college-of-engineering-research-agenda.docx

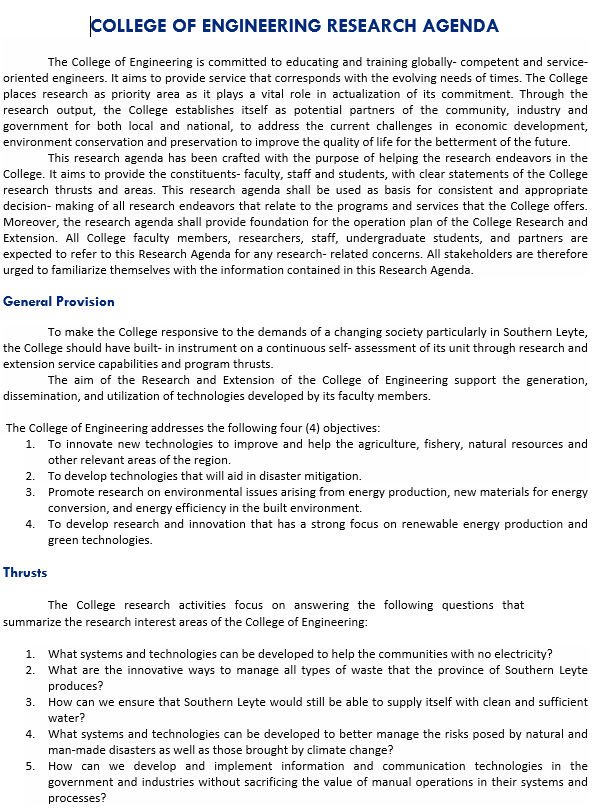
[picture p51: figure]
