theOfficial-IrvinGiL/Thesis-1-and-2-Documentations-and-Papers/Main papers/Developmental Progress tracking.xlsx

Sheet: Sheet1
Thesis Development and Progress Tracking
Development of Auxiliary Application for the System
Overall Percentage: | 15% |  |  |  |  |  |  |  |  |  |  |  | 7 |  | Enter alottted cost by percentage: |  | 315
Task and Developmental Activites | Icon Creation and UI/UX Design |  | "Update energy consumption" Feature |  | "Manage contacts" Feature |  | Database design |  | "View Data history" Feature |  | Creation and Designing of Instruction Manual |  | Patching and Improvement Development |  |  | Final percentage |  | To pay
PERCENTAGE |  | 0 |  | 0 |  | 0 |  | 0 |  | 0 |  | 0 |  | 0
Irvin Gil Mercado | 75 |  | 72 |  | 72 |  | 75 |  | 75 |  | 5 |  | 10 |  | 384 | 54.85714286 | 0.8229166667 | 4.480304206
Lyndon Diacosta | 5 |  | 5 |  | 5 |  | 5 |  | 5 |  | 5 |  | 20 |  | 50 | 7.142857143 | 13 | 70.77746391
Benjie Basa | 5 |  | 5 |  | 5 |  | 5 |  | 5 |  | 5 |  | 20 |  | 50 | 7.142857143 | 13 | 70.77746391
Mark Neil Crisostomo | 5 |  | 5 |  | 5 |  | 5 |  | 5 |  | 5 |  | 20 |  | 50 | 7.142857143 | 13 | 70.77746391
Michelle Ann Hinayas | 5 |  | 8 |  | 8 |  | 5 |  | 5 |  | 75 |  | 10 |  | 116 | 16.57142857 | 5.034482759 | 27.40984014
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
