theOfficial-IrvinGiL/Thesis-1-and-2-Documentations-and-Papers/Android Development for System Auxiliary Application/0b0b29e2e2cf6c3b0e2b9fd55980cb1c.png

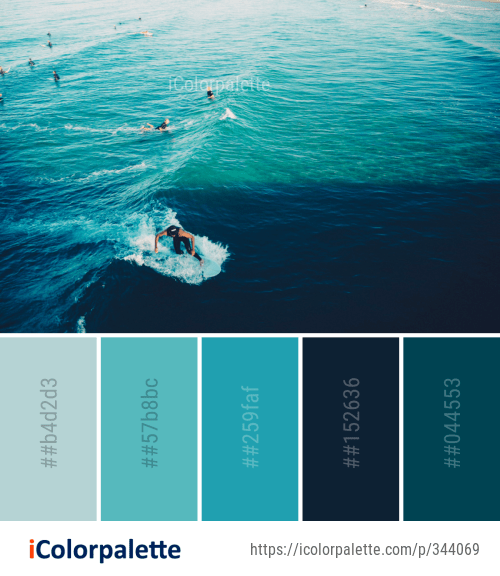
Android Development for System Auxiliary Application/0b0b29e2e2cf6c3b0e2b9fd55980cb1c.png
