theOfficial-IrvinGiL/Thesis-1-and-2-Documentations-and-Papers/Android Development for System Auxiliary Application/design files for Ui/for_custom_layout 2.png

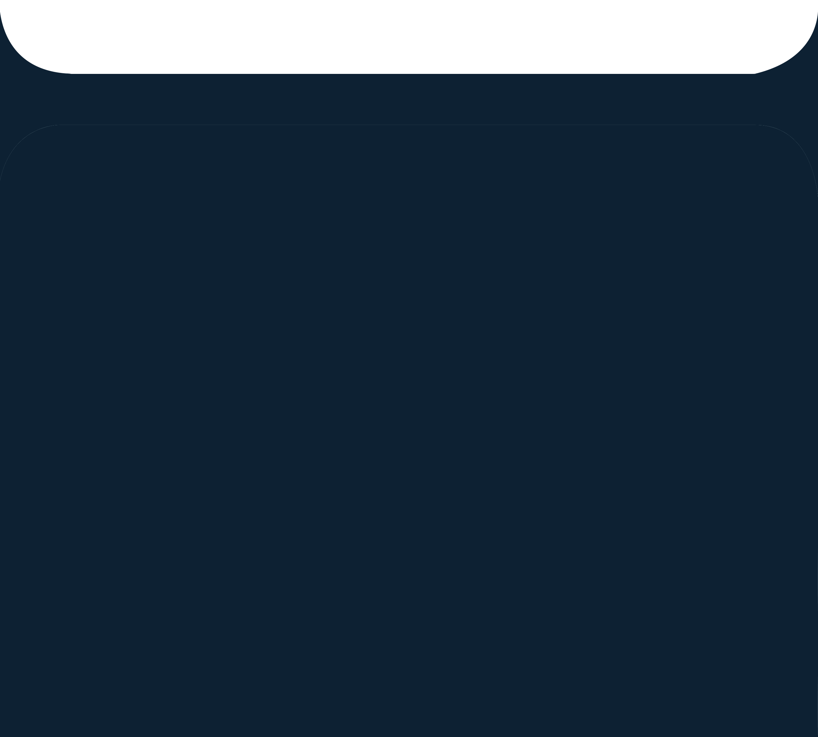
Android Development for System Auxiliary Application/design files for Ui/for_custom_layout 2.png
