theOfficial-IrvinGiL/Thesis-1-and-2-Documentations-and-Papers/Autocad Projects/Thesis CAD/0b8266ccdf5ba20c6ba02485ec2b4e11.jpg

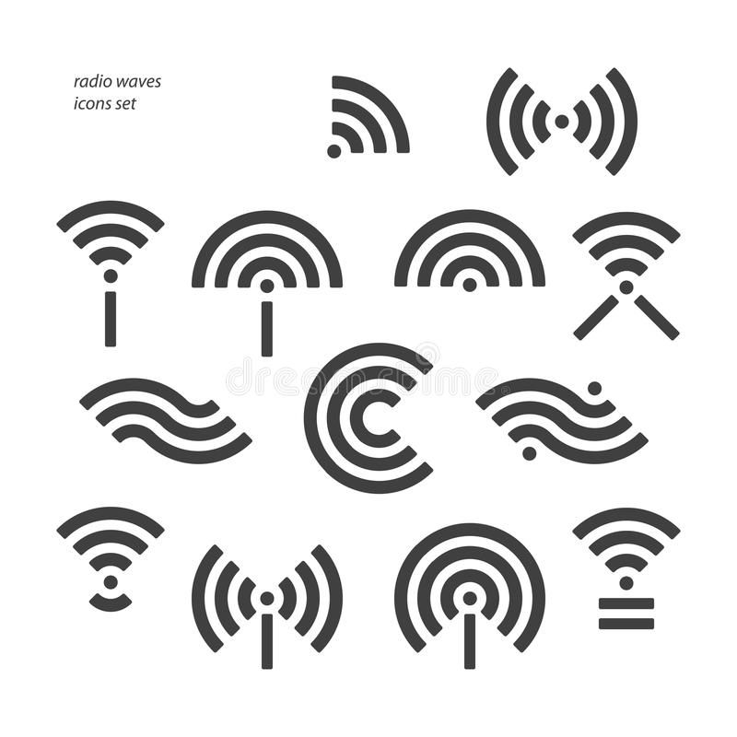
Autocad Projects/Thesis CAD/0b8266ccdf5ba20c6ba02485ec2b4e11.jpg
