theOfficial-IrvinGiL/Thesis-1-and-2-Documentations-and-Papers/Autocad Projects/Thesis CAD/boarding house plan 0001a.jpg

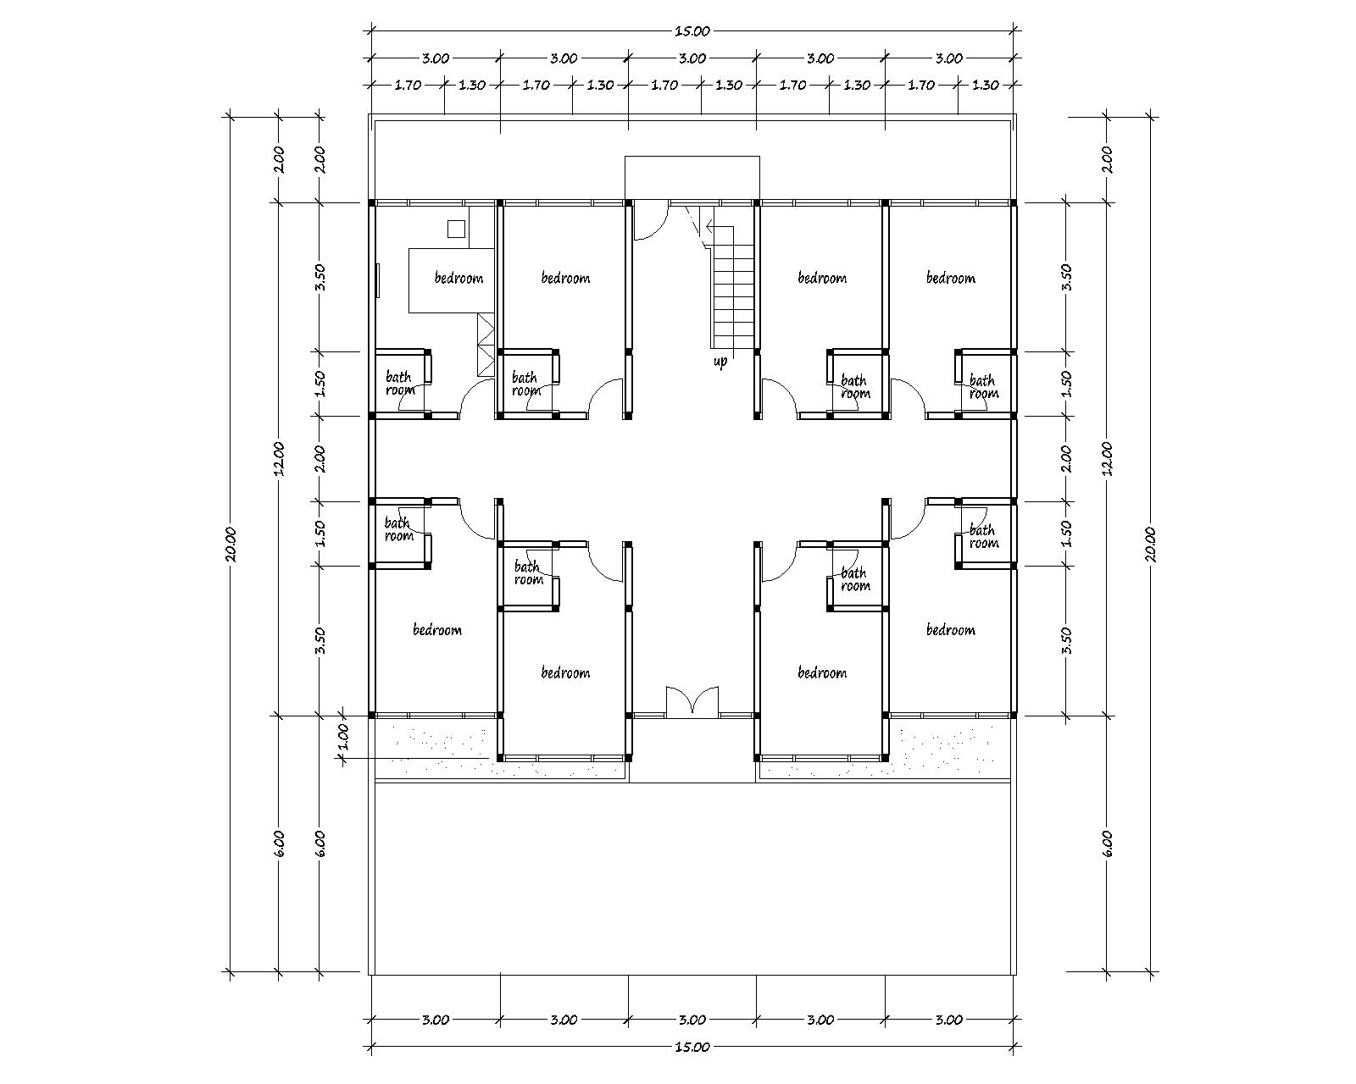
Autocad Projects/Thesis CAD/boarding house plan 0001a.jpg
