theOfficial-IrvinGiL/Thesis-1-and-2-Documentations-and-Papers/Autocad Projects/Thesis CAD/main - bottom.png

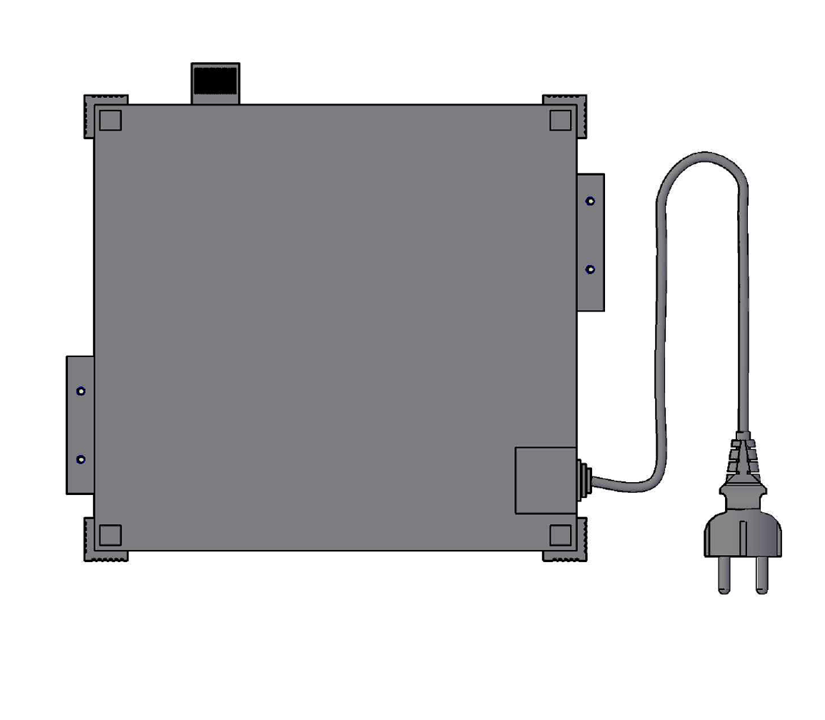
Autocad Projects/Thesis CAD/main - bottom.png
