theOfficial-IrvinGiL/Thesis-1-and-2-Documentations-and-Papers/Autocad Projects/Thesis CAD/main - right.png

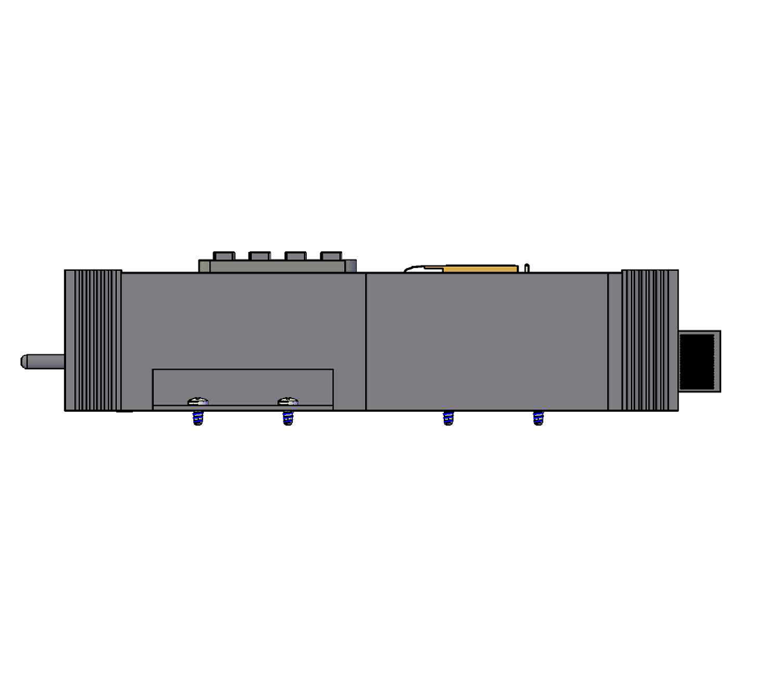
Autocad Projects/Thesis CAD/main - right.png
