theOfficial-IrvinGiL/Thesis-1-and-2-Documentations-and-Papers/Autocad Projects/Thesis CAD/Main Unit (Internal Layout).png

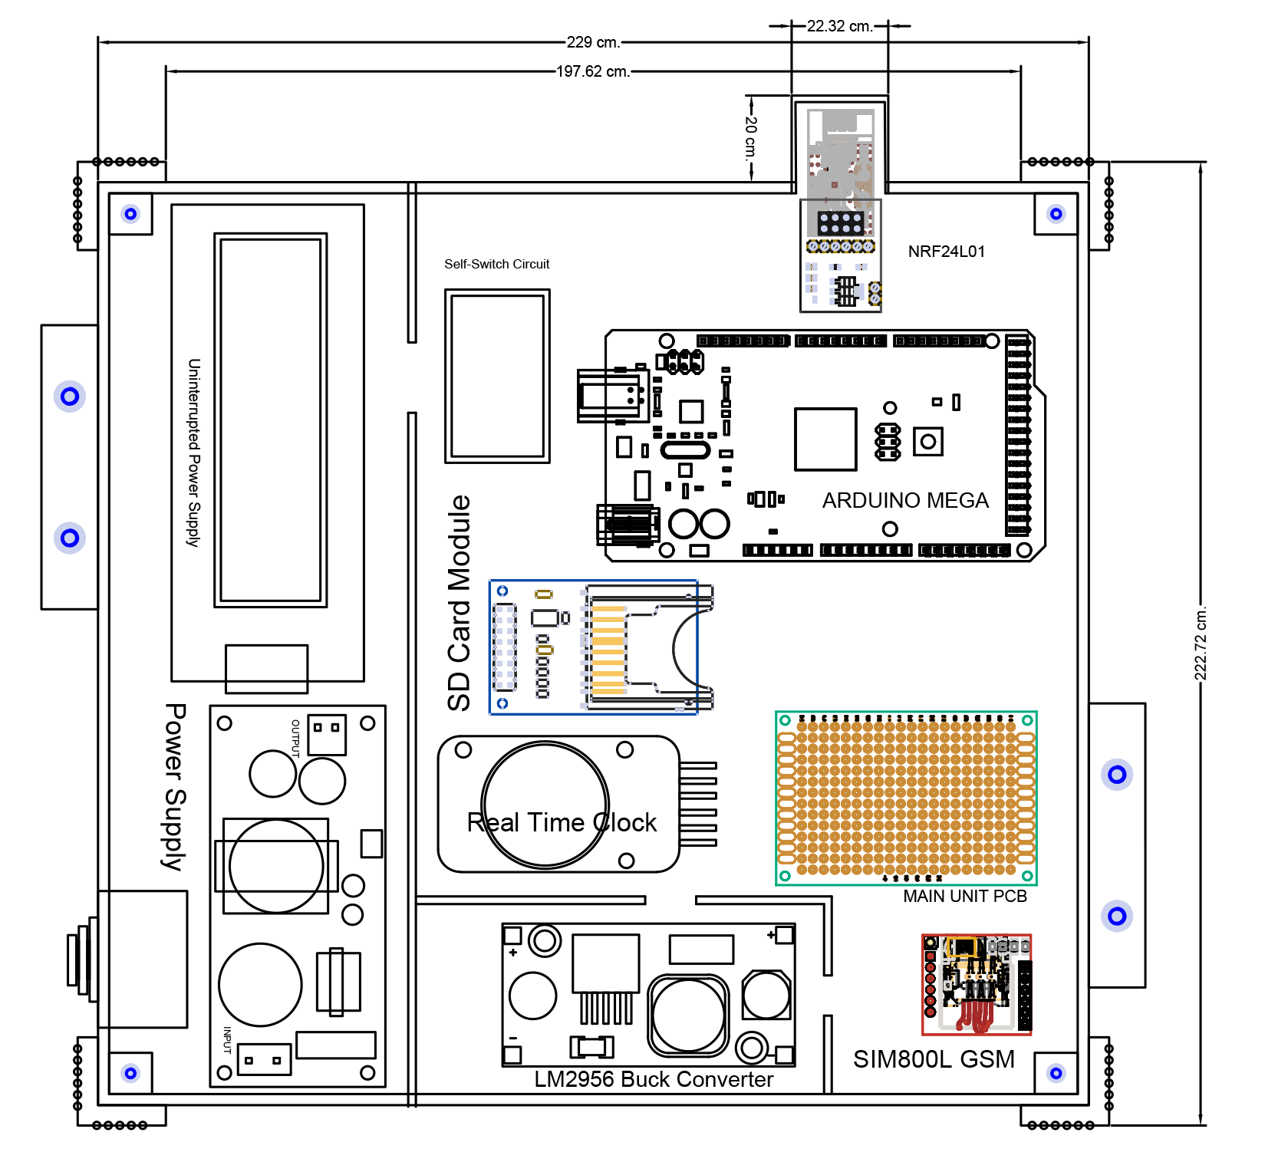
Autocad Projects/Thesis CAD/Main Unit (Internal Layout).png
