theOfficial-IrvinGiL/Thesis-1-and-2-Documentations-and-Papers/Autocad Projects/Thesis CAD/Main Unit Labels.png

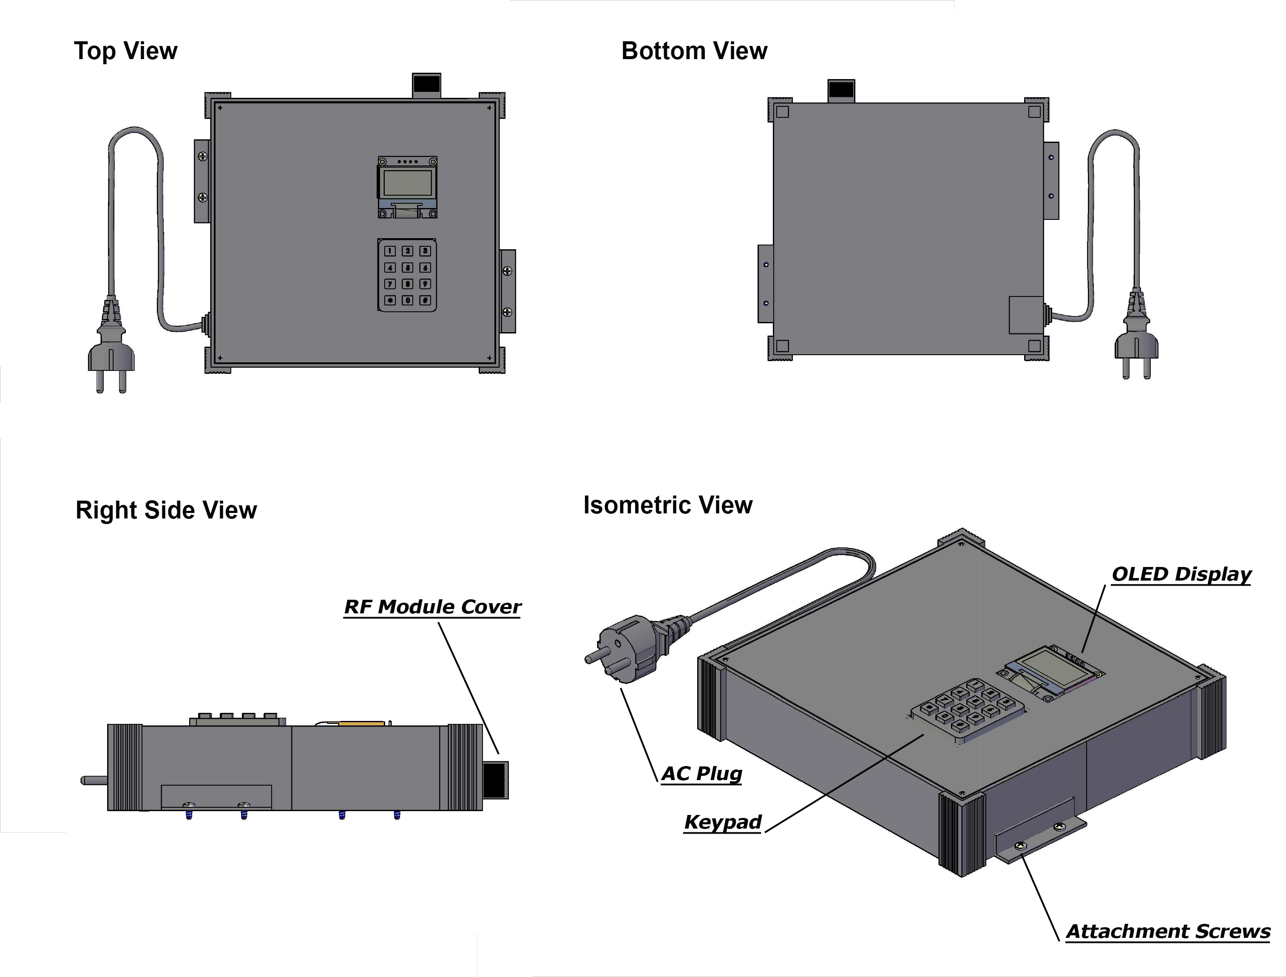
Autocad Projects/Thesis CAD/Main Unit Labels.png
