theOfficial-IrvinGiL/Thesis-1-and-2-Documentations-and-Papers/Autocad Projects/Thesis CAD/Perspective View of the System.png

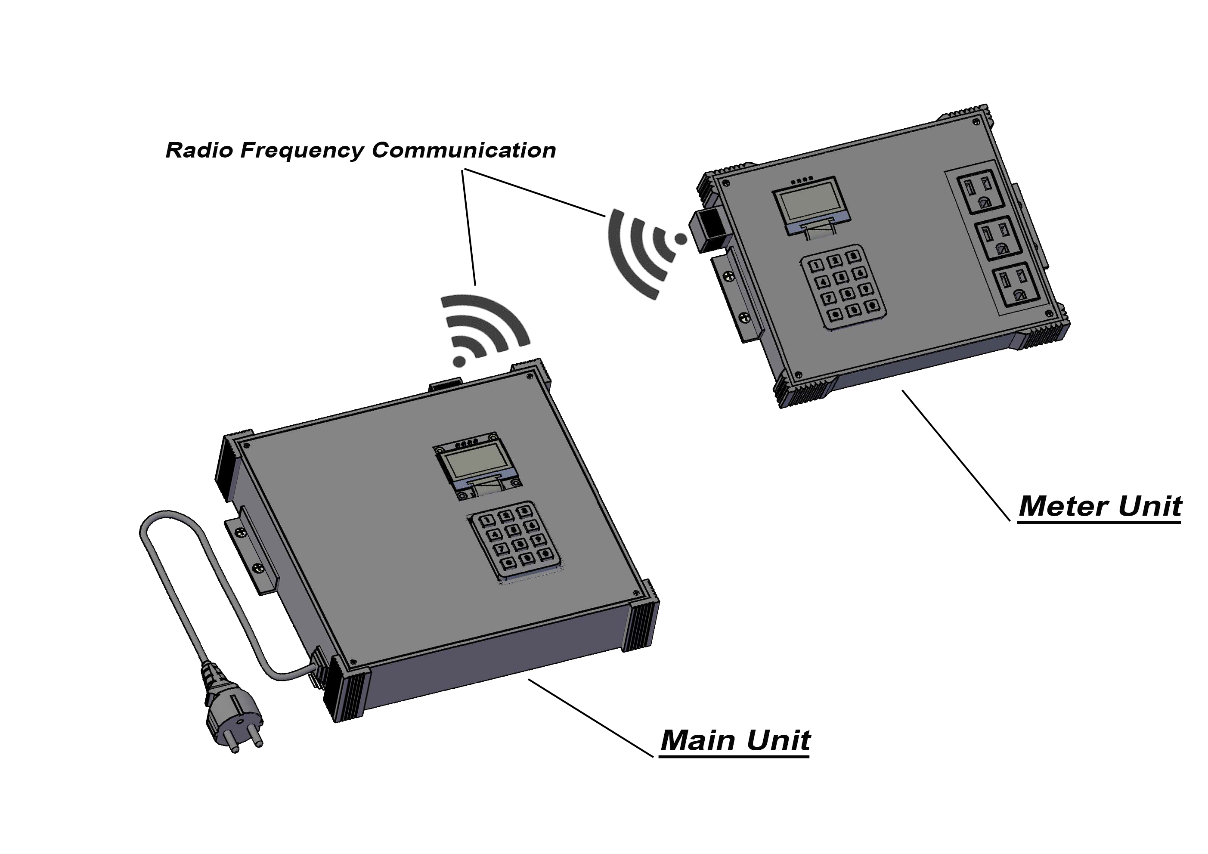
Autocad Projects/Thesis CAD/Perspective View of the System.png
