theOfficial-IrvinGiL/Thesis-1-and-2-Documentations-and-Papers/CAD and System Schematics/Circuit Schematic_Technical.png

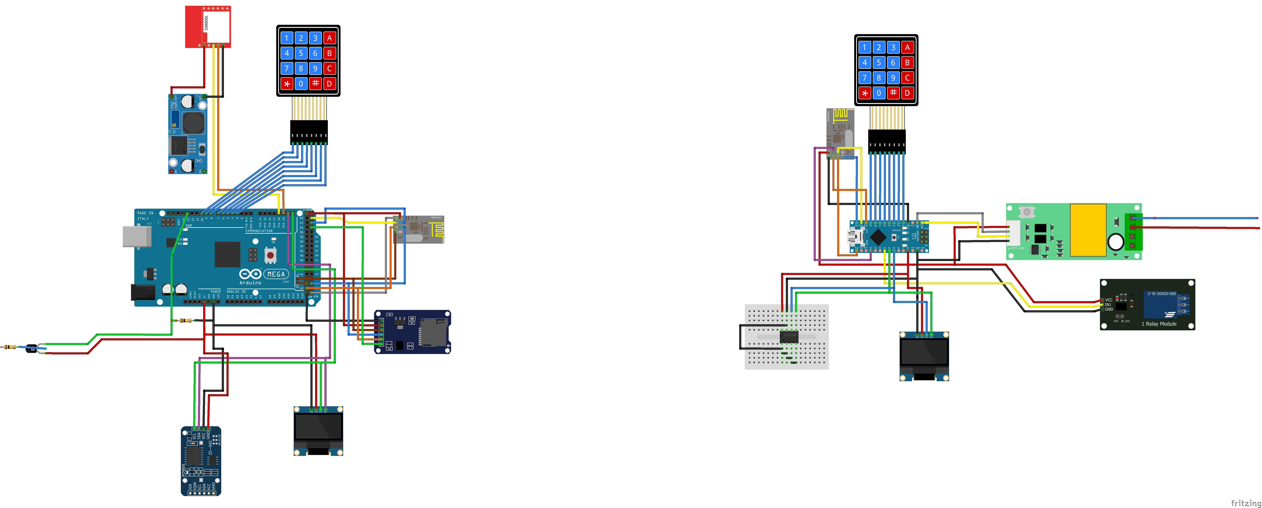
CAD and System Schematics/Circuit Schematic_Technical.png
