theOfficial-IrvinGiL/Thesis-1-and-2-Documentations-and-Papers/CAD and System Schematics/Diagrams/Block Diagram of Methods.png

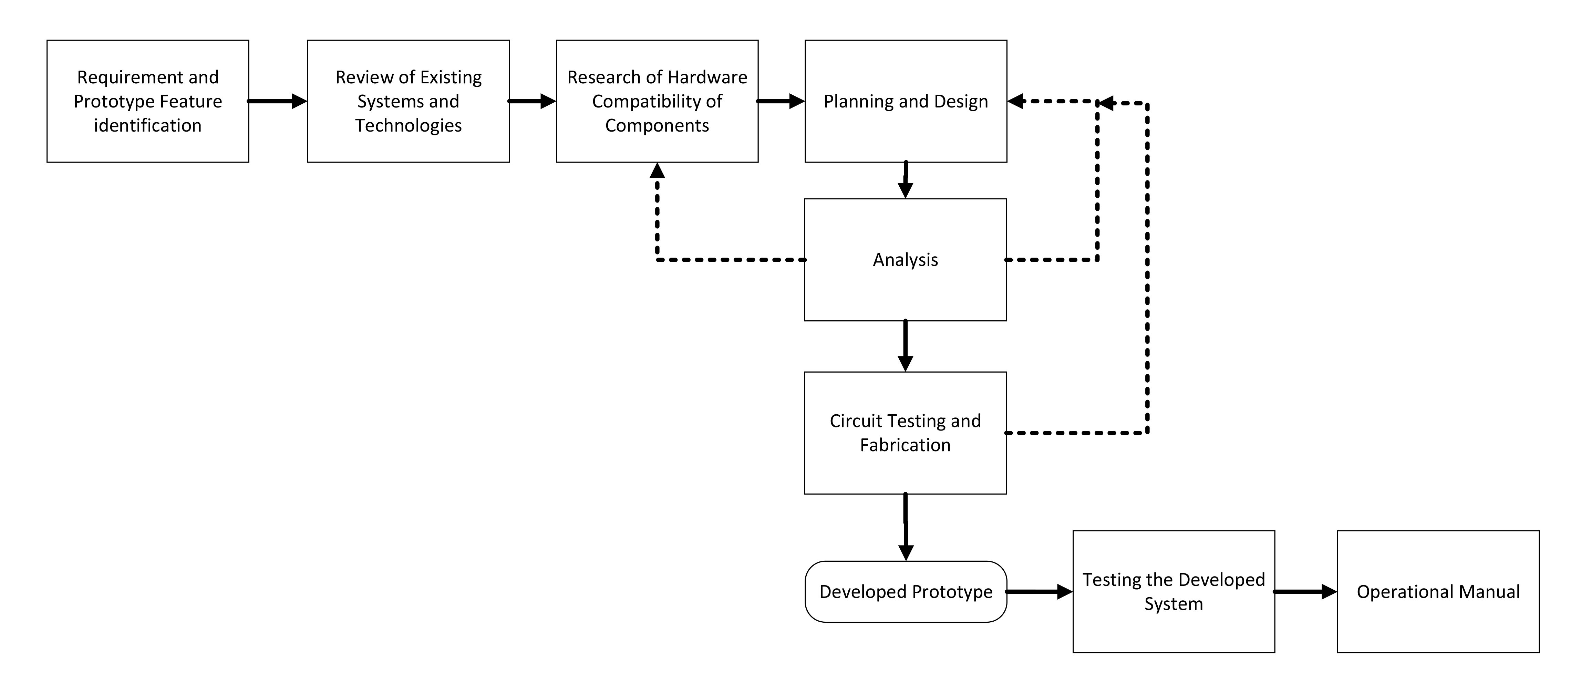
CAD and System Schematics/Diagrams/Block Diagram of Methods.png
