theOfficial-IrvinGiL/Thesis-1-and-2-Documentations-and-Papers/CAD and System Schematics/Diagrams/block diagram.png

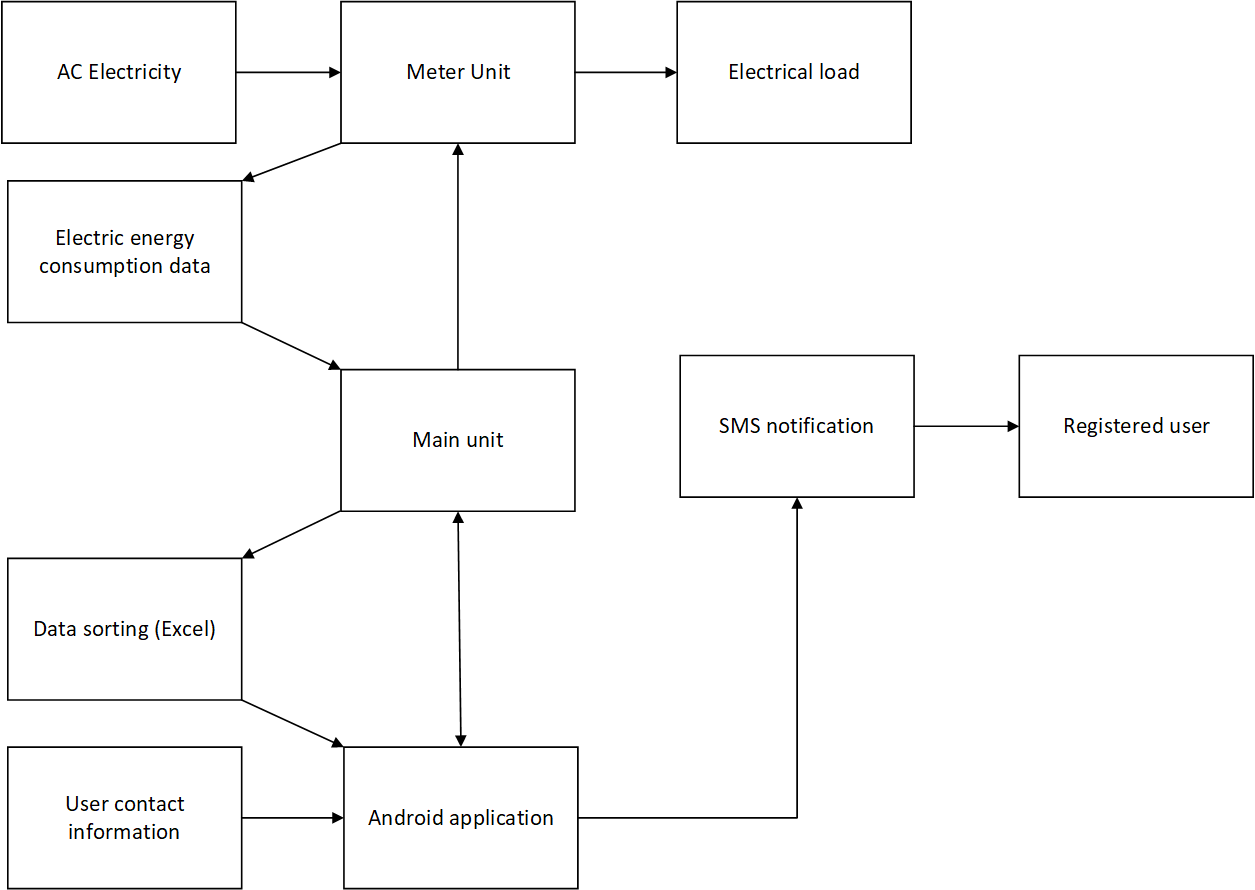
CAD and System Schematics/Diagrams/block diagram.png
