theOfficial-IrvinGiL/Thesis-1-and-2-Documentations-and-Papers/CAD and System Schematics/Diagrams/Components Pictures/Single-Channel-Relay-Module-Pinout.jpg

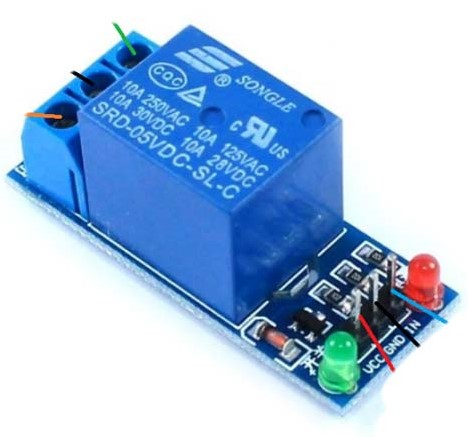
CAD and System Schematics/Diagrams/Components Pictures/Single-Channel-Relay-Module-Pinout.jpg
