theOfficial-IrvinGiL/Thesis-1-and-2-Documentations-and-Papers/CAD and System Schematics/Diagrams/concept diagrams1.png

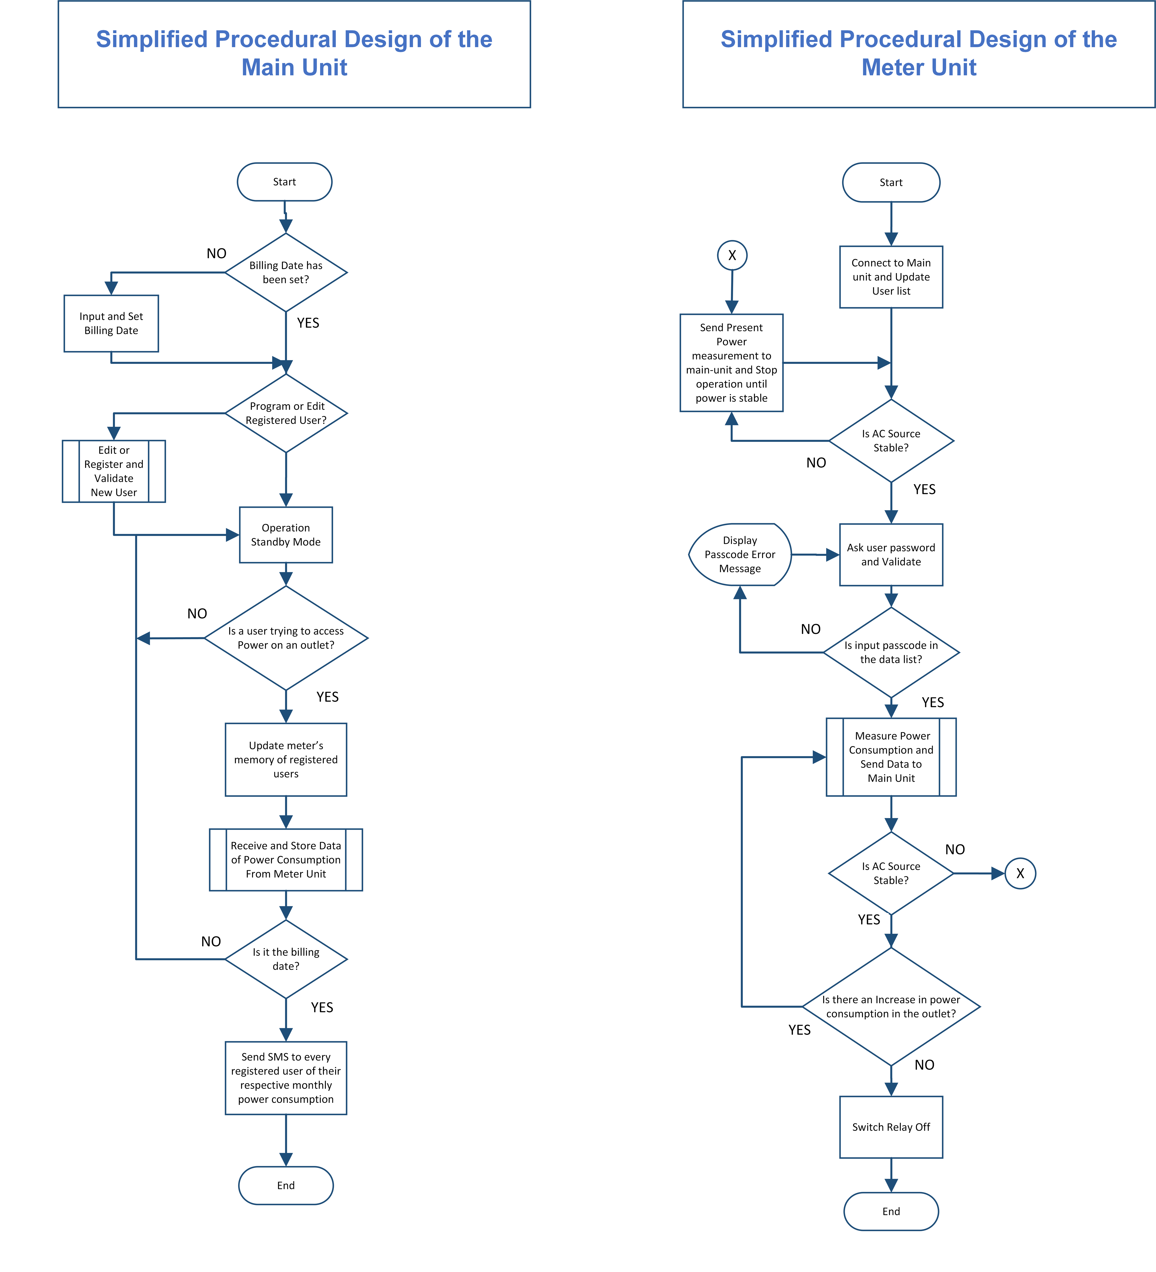
CAD and System Schematics/Diagrams/concept diagrams1.png
