theOfficial-IrvinGiL/Thesis-1-and-2-Documentations-and-Papers/CAD and System Schematics/Diagrams/flow of the study.png

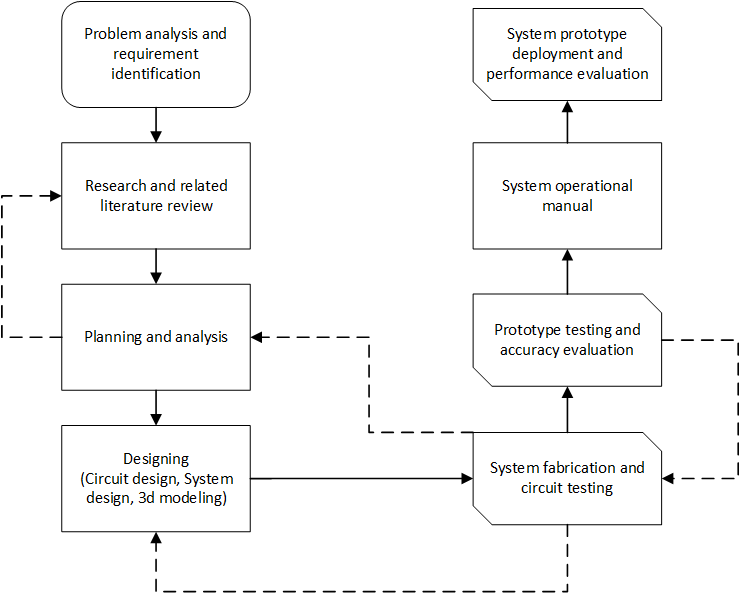
CAD and System Schematics/Diagrams/flow of the study.png
