theOfficial-IrvinGiL/Thesis-1-and-2-Documentations-and-Papers/CAD and System Schematics/Diagrams/InkedMeter unit Schematic_LI.jpg

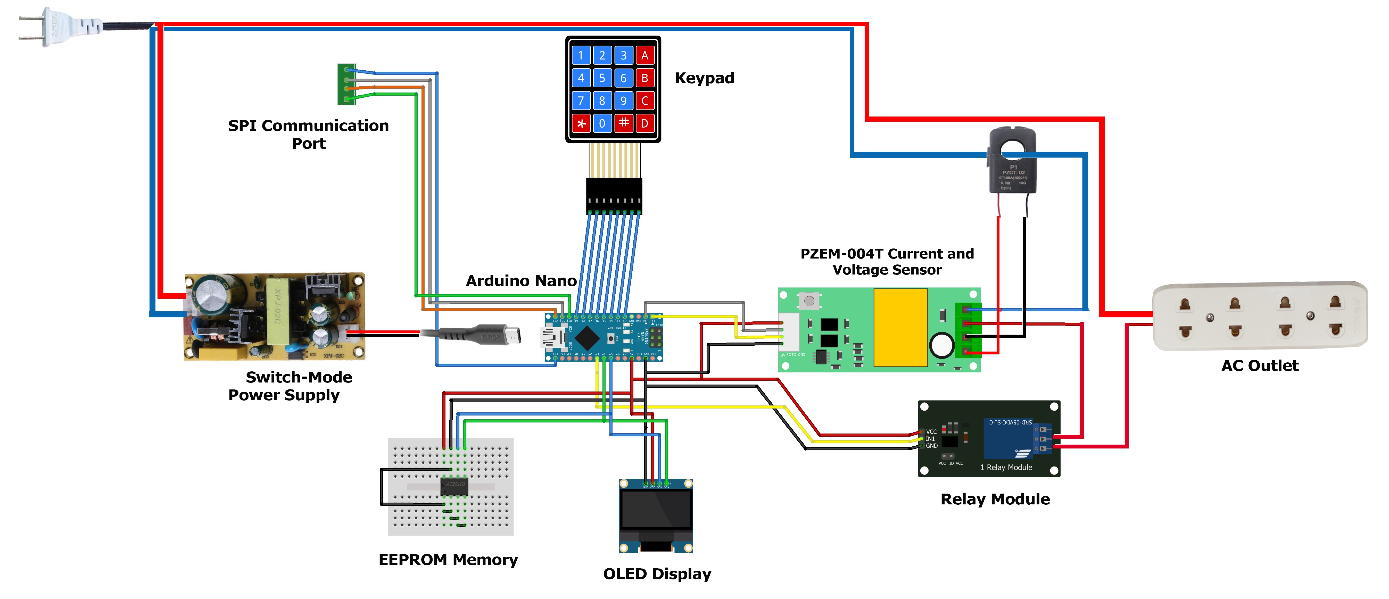
CAD and System Schematics/Diagrams/InkedMeter unit Schematic_LI.jpg
