theOfficial-IrvinGiL/Thesis-1-and-2-Documentations-and-Papers/CAD and System Schematics/Meter unit Schematic.png

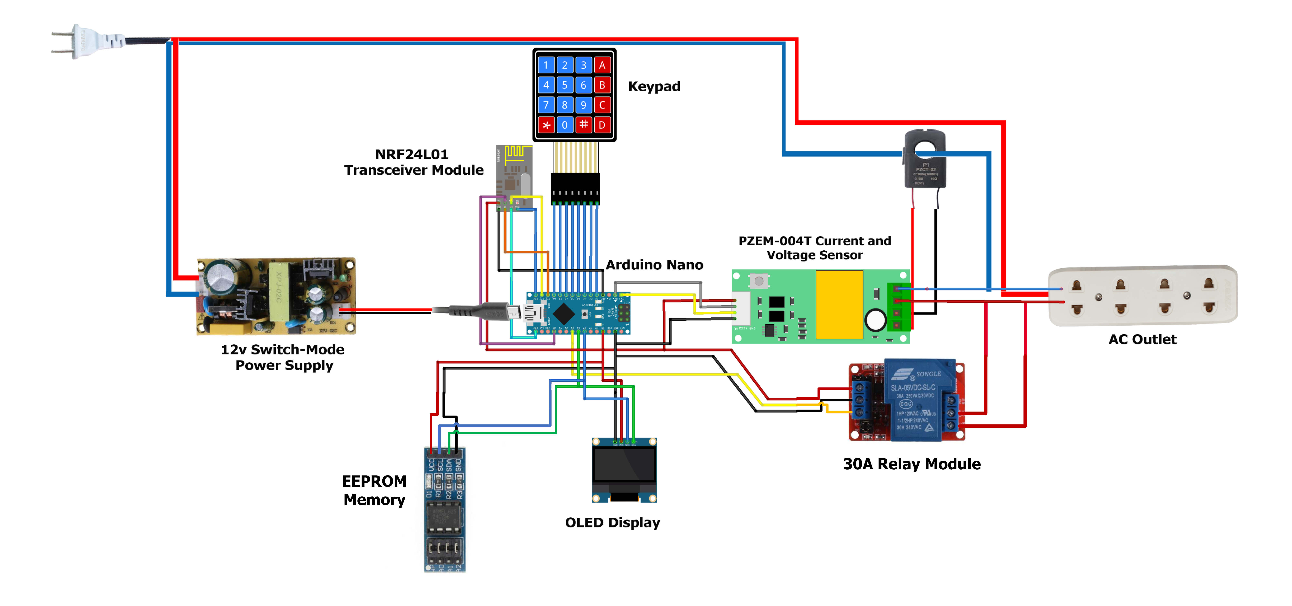
CAD and System Schematics/Meter unit Schematic.png
