theOfficial-IrvinGiL/Thesis-1-and-2-Documentations-and-Papers/CAD and System Schematics/new 3d models/edited for papers/internal_meter.png

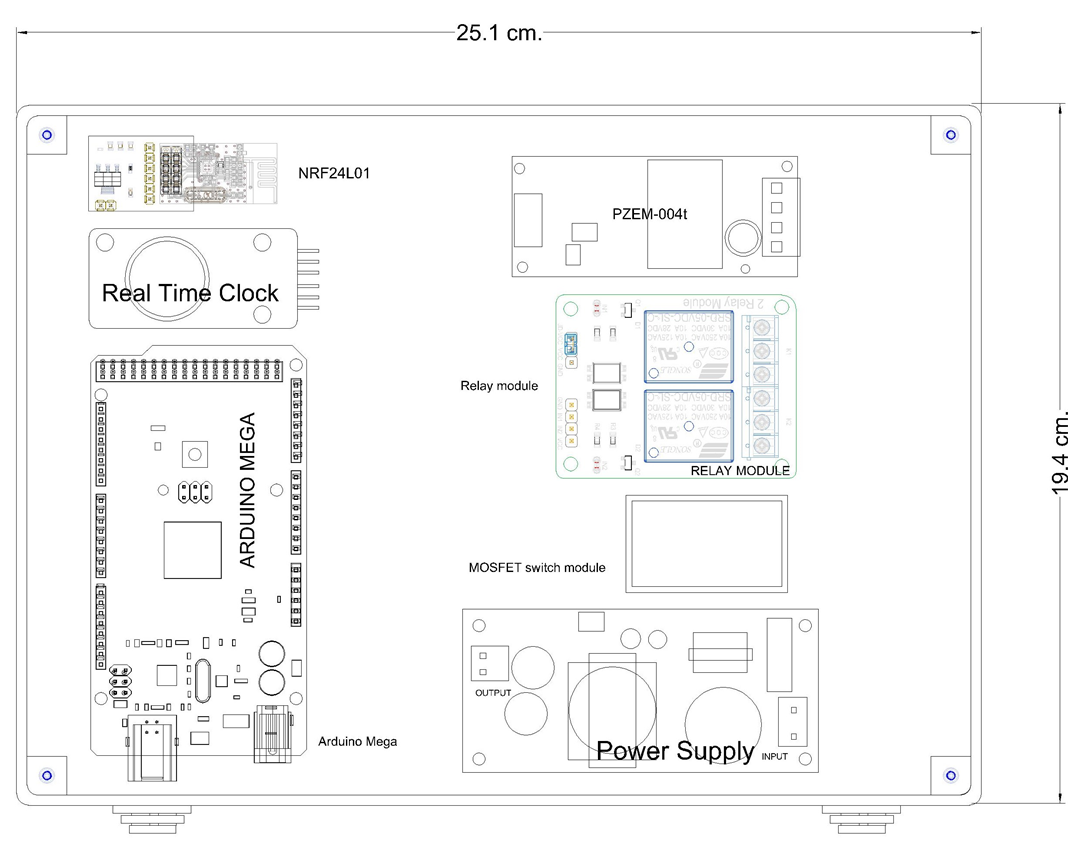
CAD and System Schematics/new 3d models/edited for papers/internal_meter.png
