theOfficial-IrvinGiL/Thesis-1-and-2-Documentations-and-Papers/CAD and System Schematics/new 3d models/main unit.jpg

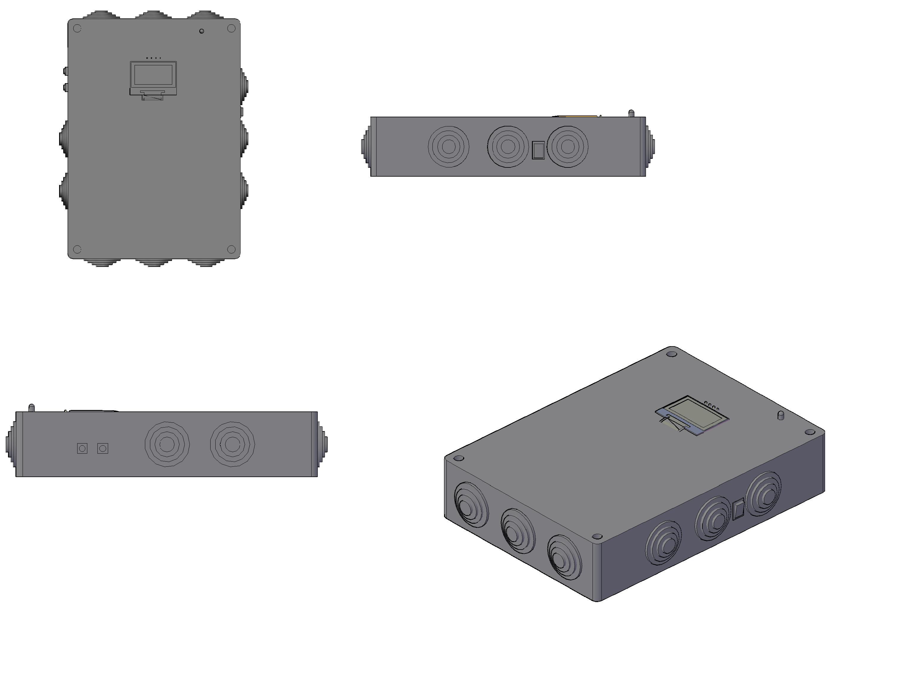
CAD and System Schematics/new 3d models/main unit.jpg
