theOfficial-IrvinGiL/Thesis-1-and-2-Documentations-and-Papers/CAD and System Schematics/new 3d models/Thesis 3d model-Perspective view of the System.png

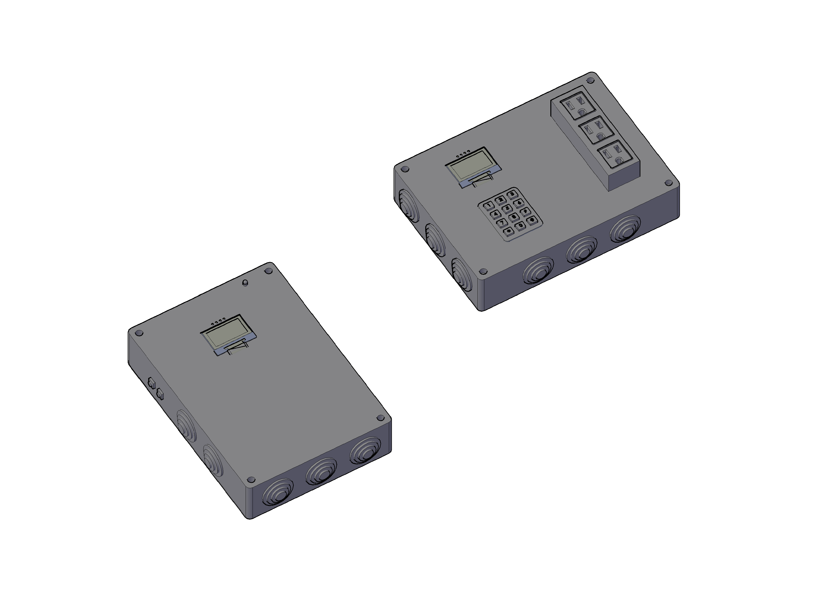
CAD and System Schematics/new 3d models/Thesis 3d model-Perspective view of the System.png
