theOfficial-IrvinGiL/Thesis-1-and-2-Documentations-and-Papers/CAD and System Schematics/new diagrams_REvised/Database design of the meter unit.png

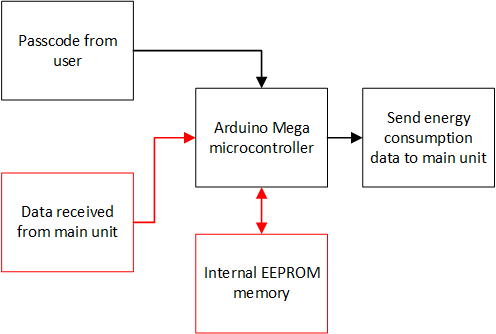
CAD and System Schematics/new diagrams_REvised/Database design of the meter unit.png
