theOfficial-IrvinGiL/Thesis-1-and-2-Documentations-and-Papers/CAD and System Schematics/new diagrams_REvised/EEPROM Data storage method representation.png

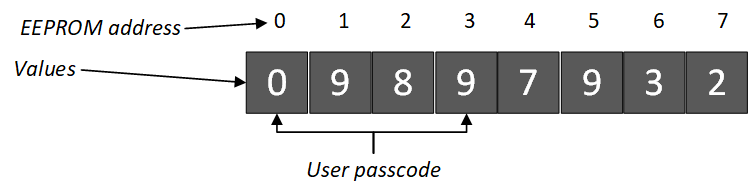
CAD and System Schematics/new diagrams_REvised/EEPROM Data storage method representation.png
