theOfficial-IrvinGiL/Thesis-1-and-2-Documentations-and-Papers/CAD and System Schematics/new diagrams_REvised/Meter procedural design.png

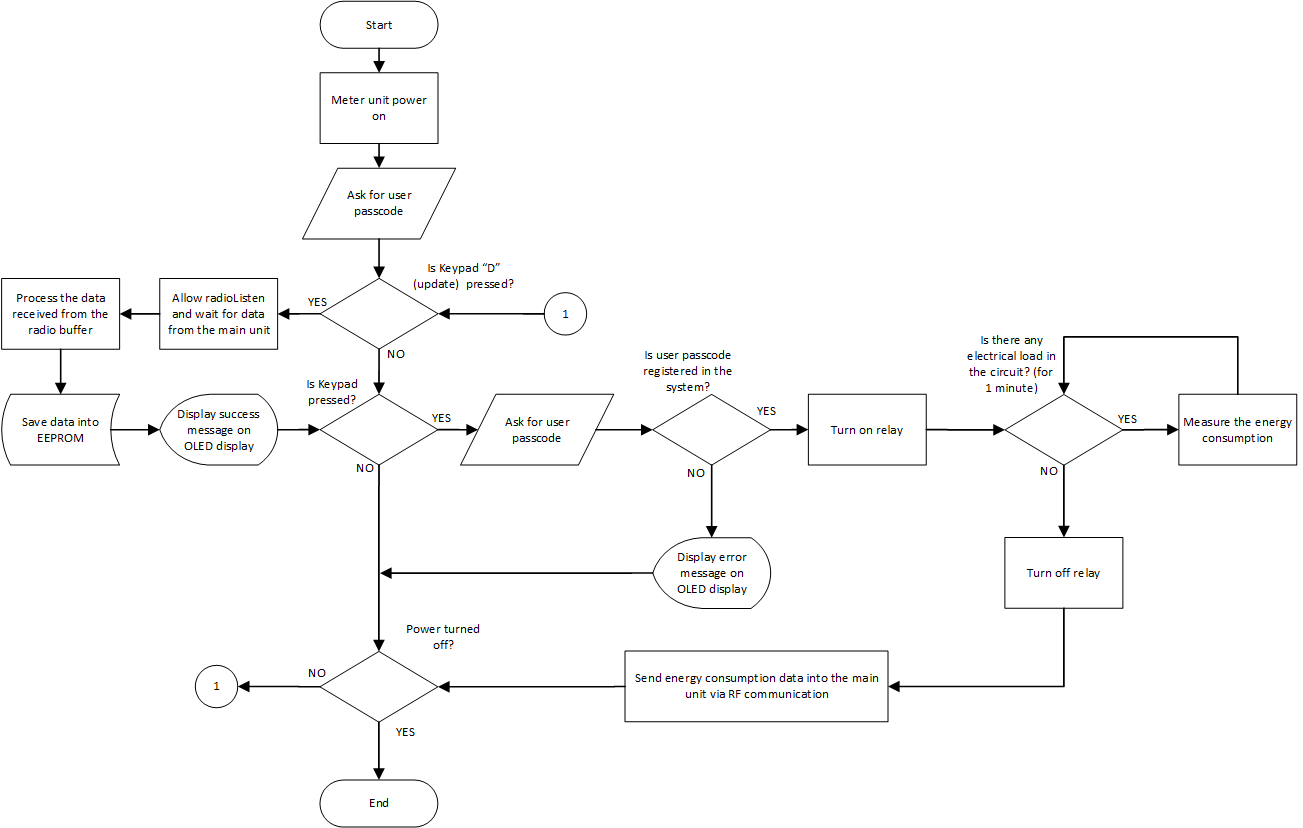
CAD and System Schematics/new diagrams_REvised/Meter procedural design.png
