theOfficial-IrvinGiL/Thesis-1-and-2-Documentations-and-Papers/CAD and System Schematics/self switching circuit.PNG

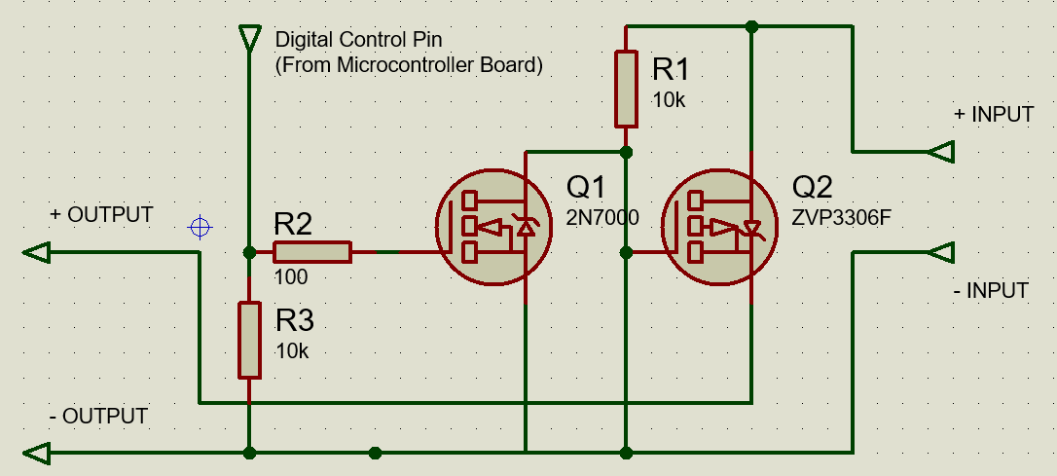
CAD and System Schematics/self switching circuit.PNG
