theOfficial-IrvinGiL/Thesis-1-and-2-Documentations-and-Papers/CAD and System Schematics/Updated main unit schematic.png

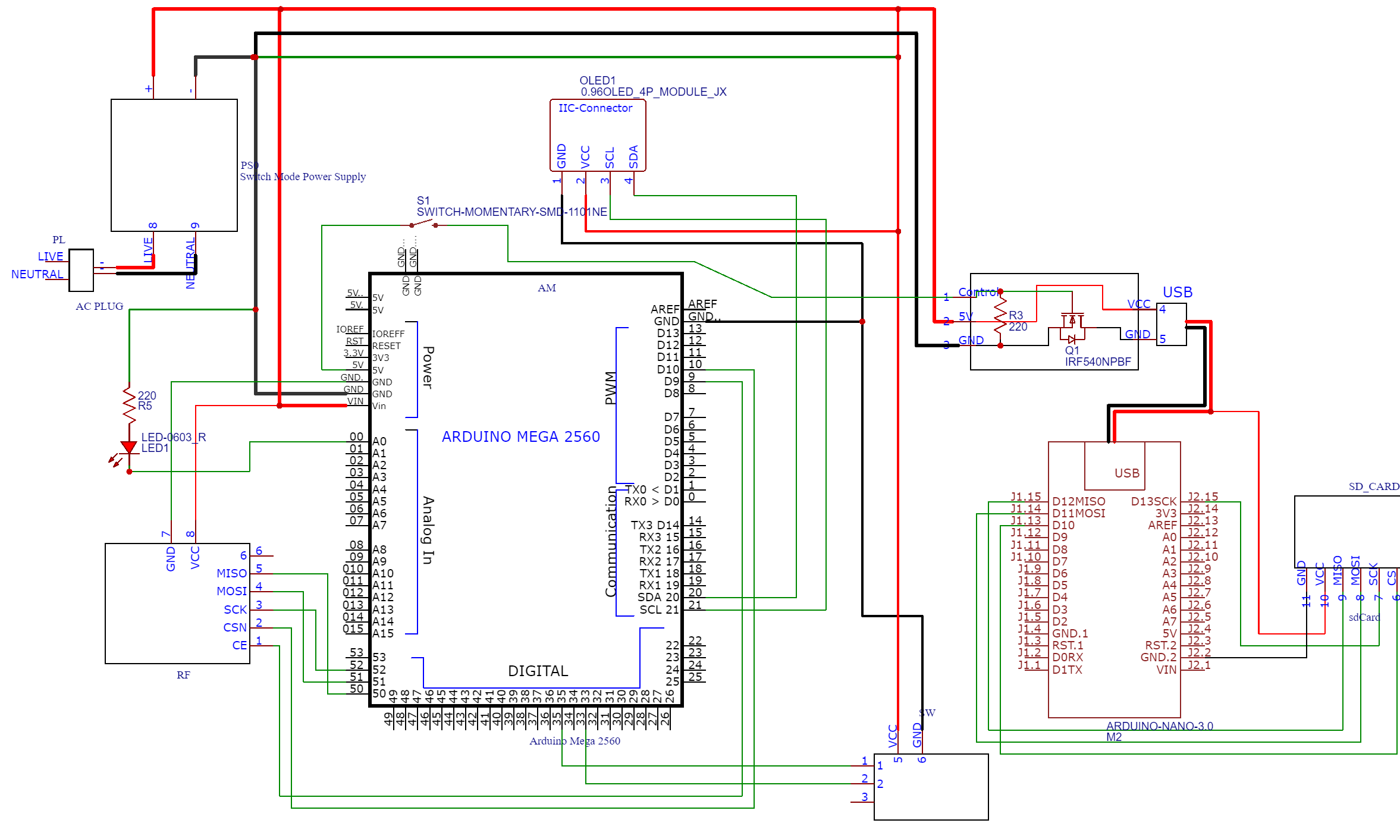
CAD and System Schematics/Updated main unit schematic.png
