theOfficial-IrvinGiL/Thesis-1-and-2-Documentations-and-Papers/CAD and System Schematics/updated_Main schematic.png

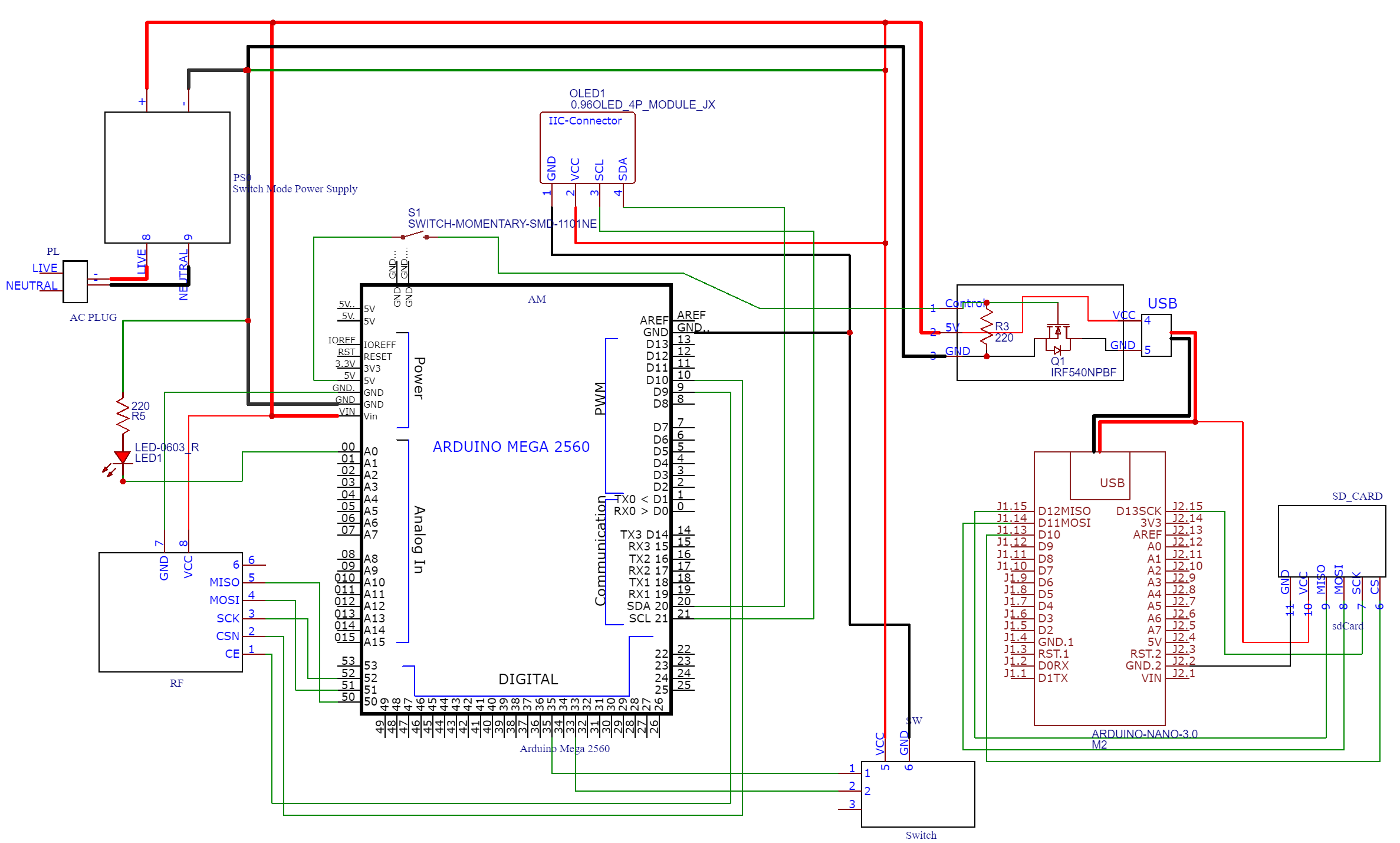
CAD and System Schematics/updated_Main schematic.png
