theOfficial-IrvinGiL/Thesis-1-and-2-Documentations-and-Papers/Documentations/Developed system/IMG_20220429_191519.jpg

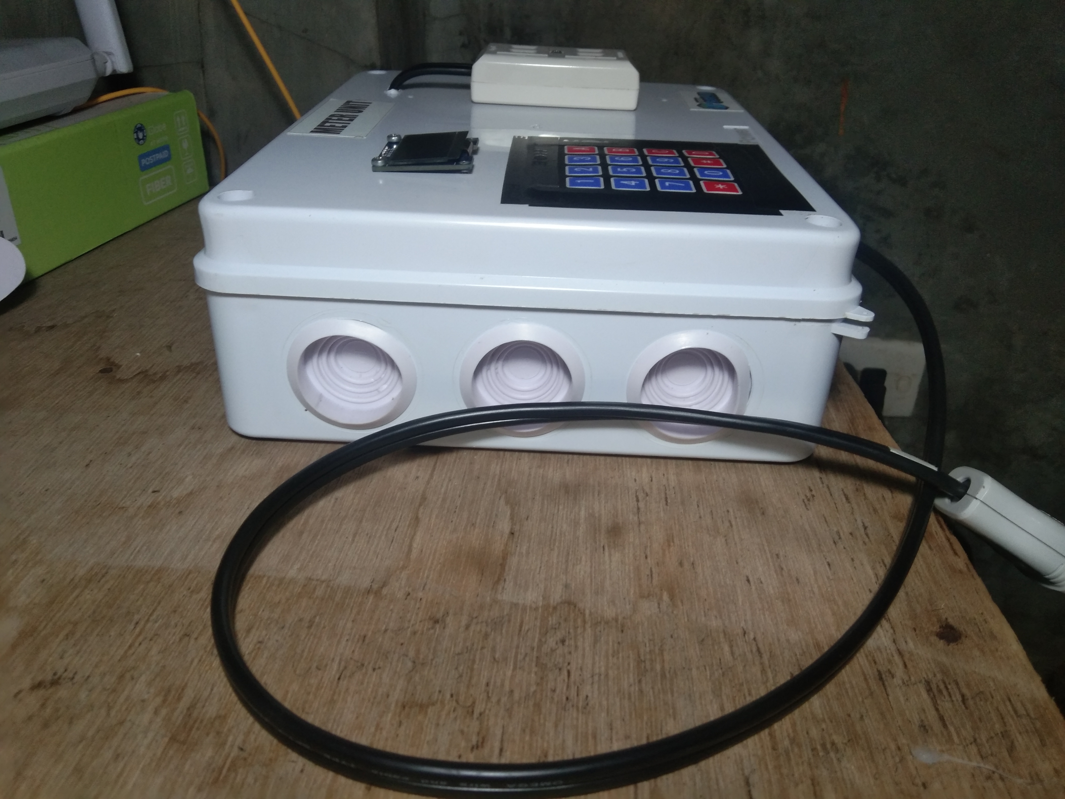
Documentations/Developed system/IMG_20220429_191519.jpg
