theOfficial-IrvinGiL/Thesis-1-and-2-Documentations-and-Papers/Documentations/Developed system/received_3161737440775980.jpeg

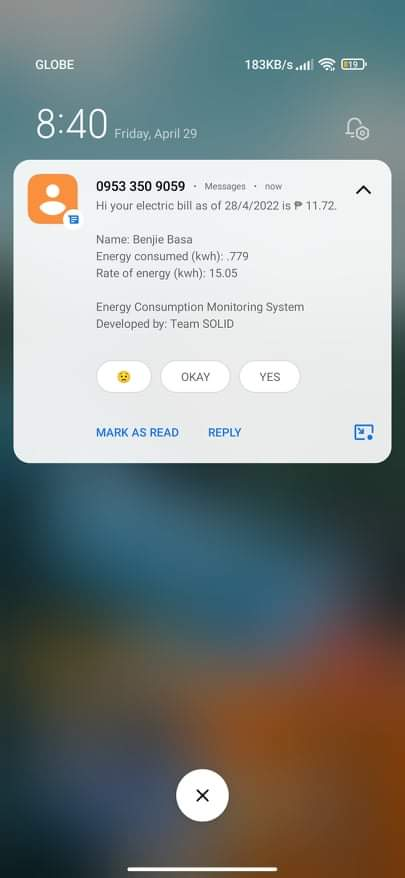
Documentations/Developed system/received_3161737440775980.jpeg
