theOfficial-IrvinGiL/Thesis-1-and-2-Documentations-and-Papers/Documentations/Developed system/Screenshot_20220429_201441.jpg

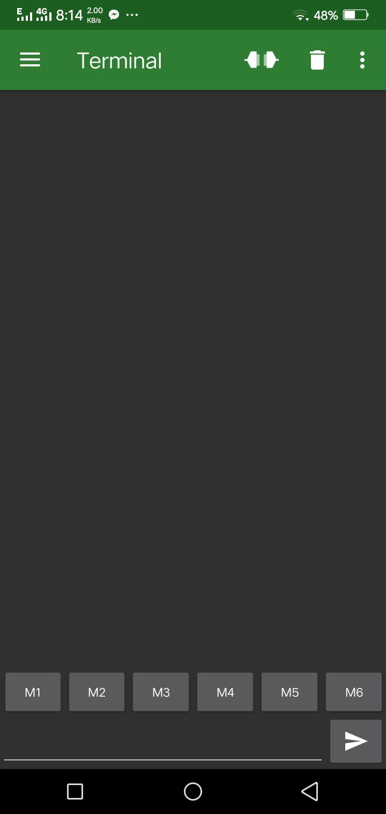
Documentations/Developed system/Screenshot_20220429_201441.jpg
