theOfficial-IrvinGiL/Thesis-1-and-2-Documentations-and-Papers/drafts/Arduino draft files/reference notes and codes/getting input from serial monitor/site image.png

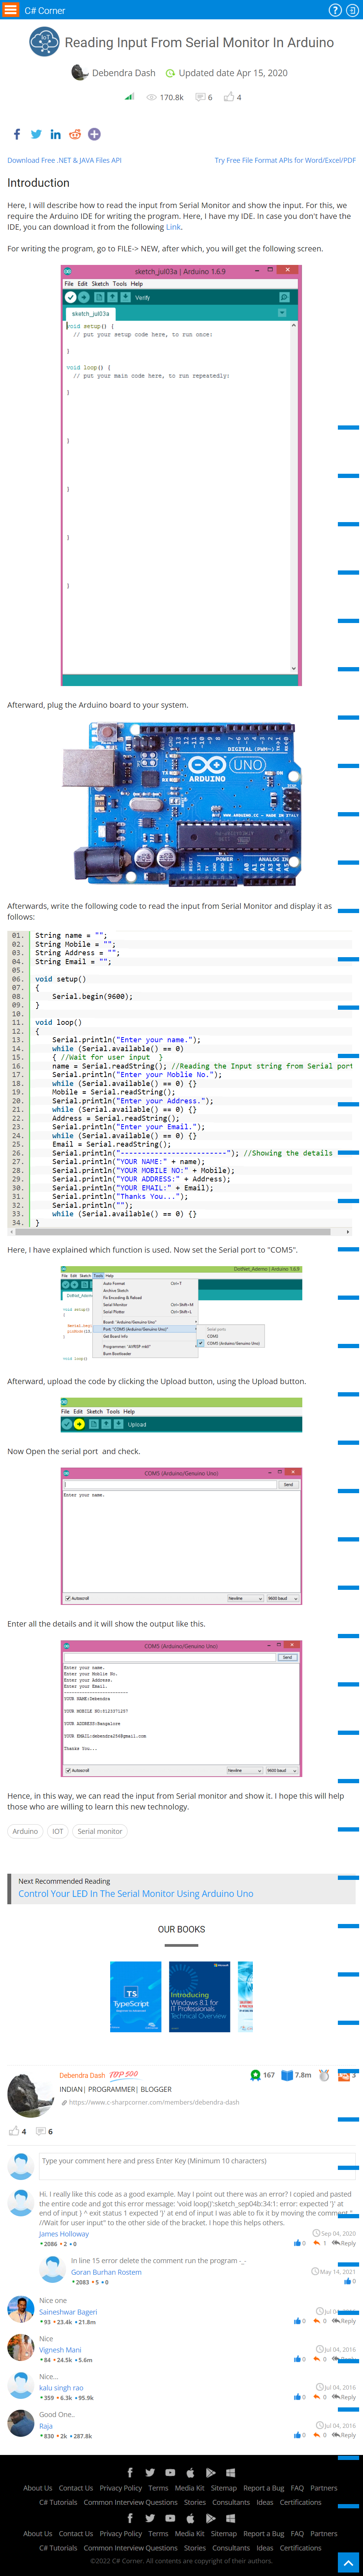
drafts/Arduino draft files/reference notes and codes/getting input from serial monitor/site image.png
