theOfficial-IrvinGiL/Thesis-1-and-2-Documentations-and-Papers/Main papers/Matrix of Compliance format/221885533_859840551329394_4095811943039012479_n.jpg

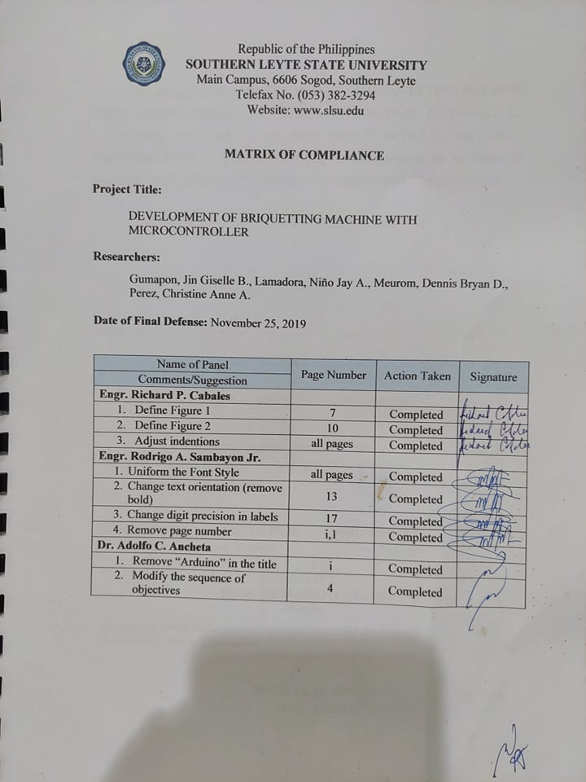
Main papers/Matrix of Compliance format/221885533_859840551329394_4095811943039012479_n.jpg
