theOfficial-IrvinGiL/Thesis-1-and-2-Documentations-and-Papers/Main papers/Matrix of Compliance format/226355937_3022842784708619_8603172800783702289_n.jpg

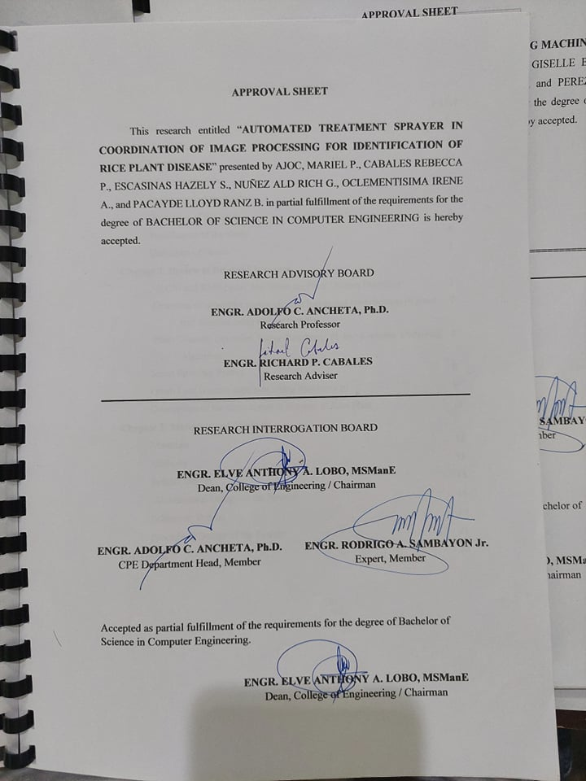
Main papers/Matrix of Compliance format/226355937_3022842784708619_8603172800783702289_n.jpg
