theOfficial-IrvinGiL/Thesis-1-and-2-Documentations-and-Papers/Main papers/Proposal PPT/color pallete.png

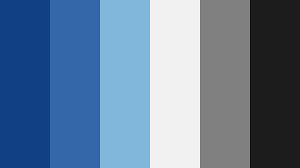
Main papers/Proposal PPT/color pallete.png
