theOfficial-IrvinGiL/Thesis-1-and-2-Documentations-and-Papers/notes/circuit layout notes/Good - circuit for relay switch.png

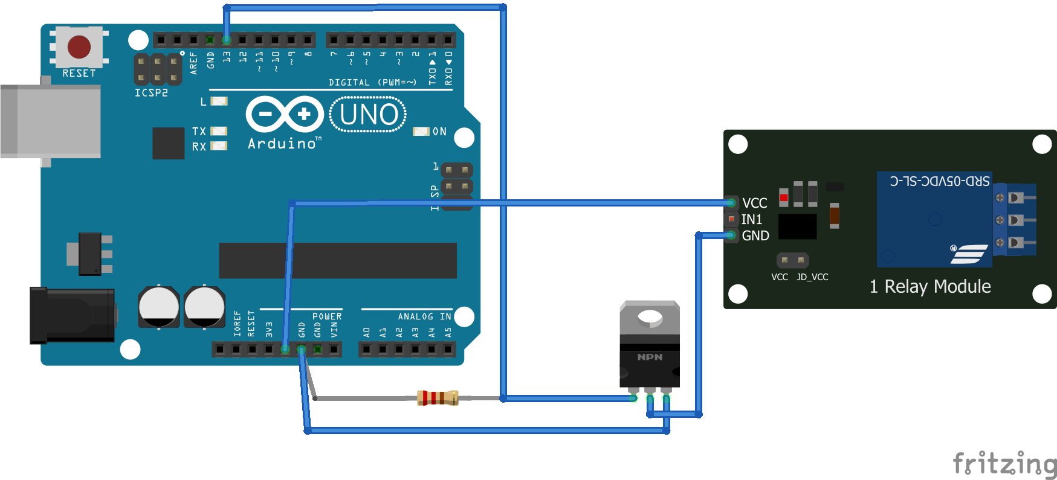
notes/circuit layout notes/Good - circuit for relay switch.png
