theOfficial-IrvinGiL/Thesis-1-and-2-Documentations-and-Papers/notes/circuit layout notes/oled display.png

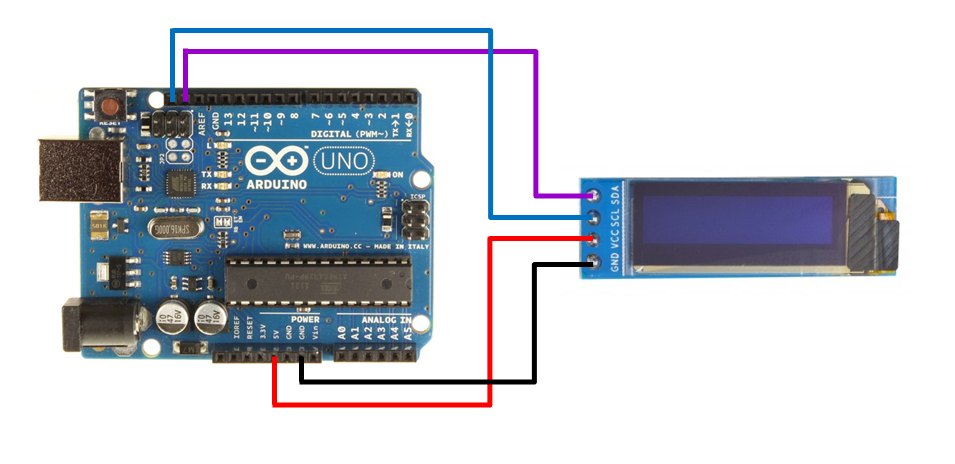
notes/circuit layout notes/oled display.png
