theOfficial-IrvinGiL/Thesis-1-and-2-Documentations-and-Papers/notes/Time Bounded plan for THESIS.png

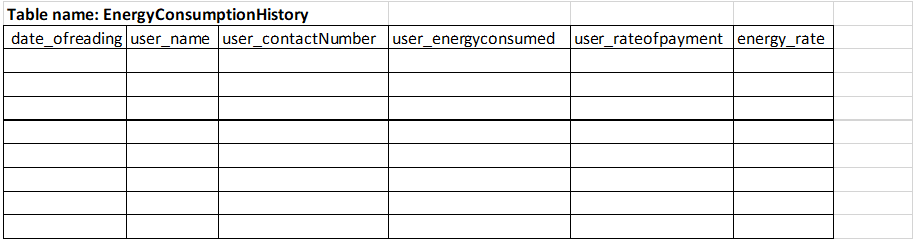
notes/Time Bounded plan for THESIS.png
