theOfficial-IrvinGiL/Thesis-1-and-2-Documentations-and-Papers/Project Documentation/Proposal defense documentation/218922999_889760908299462_5696606785186949773_n.png

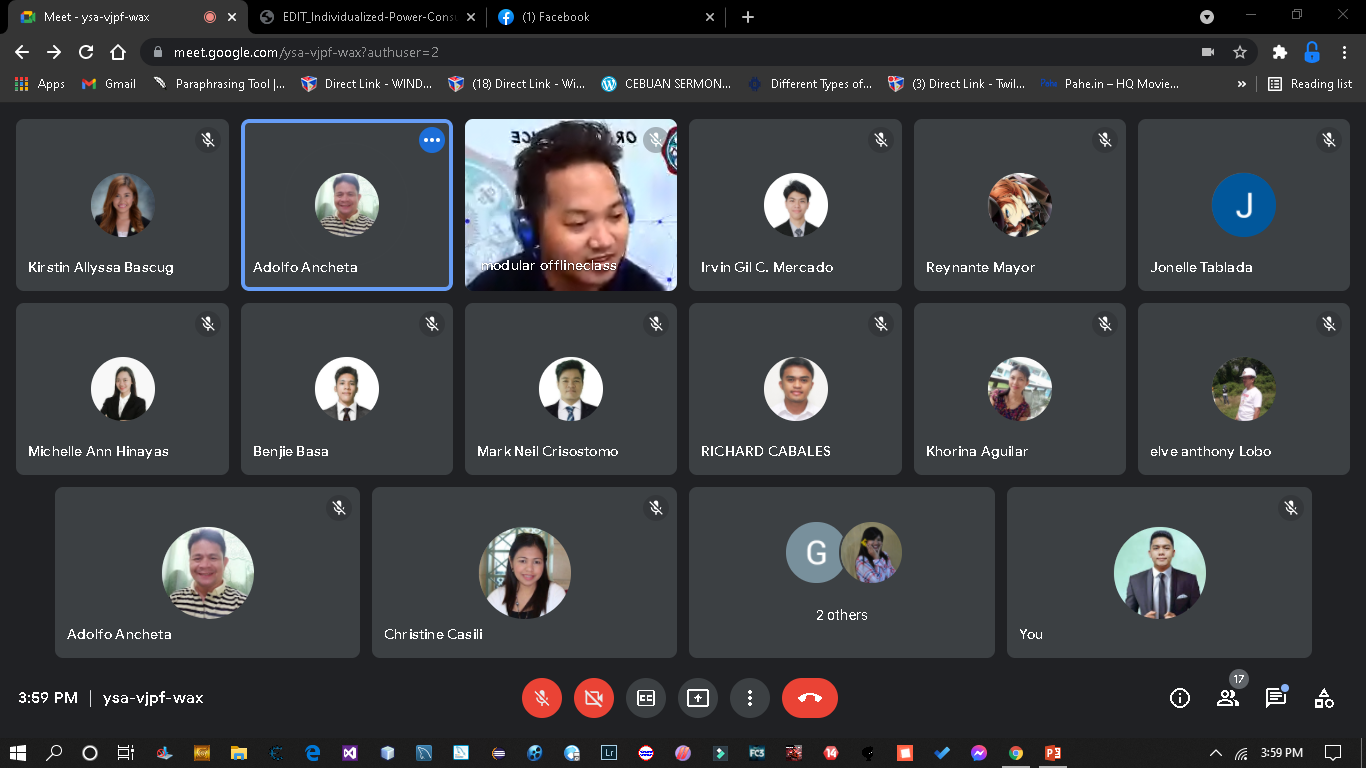
Project Documentation/Proposal defense documentation/218922999_889760908299462_5696606785186949773_n.png
