theOfficial-IrvinGiL/Thesis-1-and-2-Documentations-and-Papers/received_914548059330697.webp

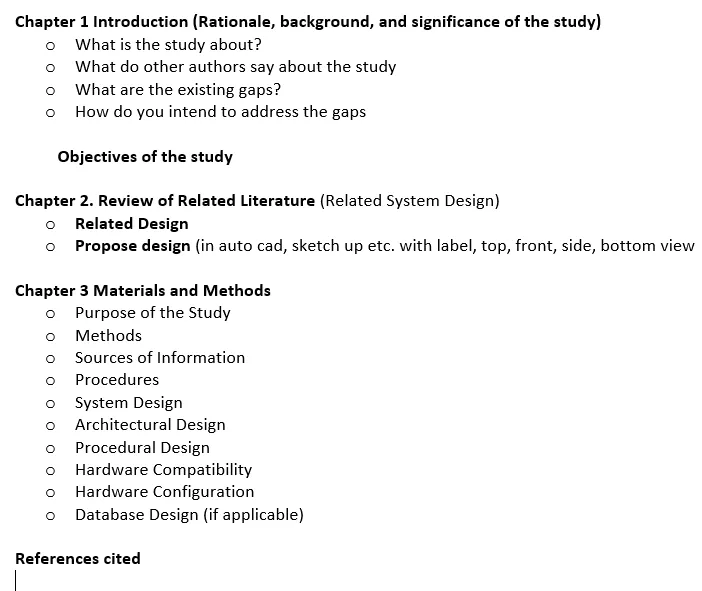
received_914548059330697.webp
