theOfficial-IrvinGiL/Thesis-1-and-2-Documentations-and-Papers/notes/Budget Plan for Purchasing of Components 1.1.docx

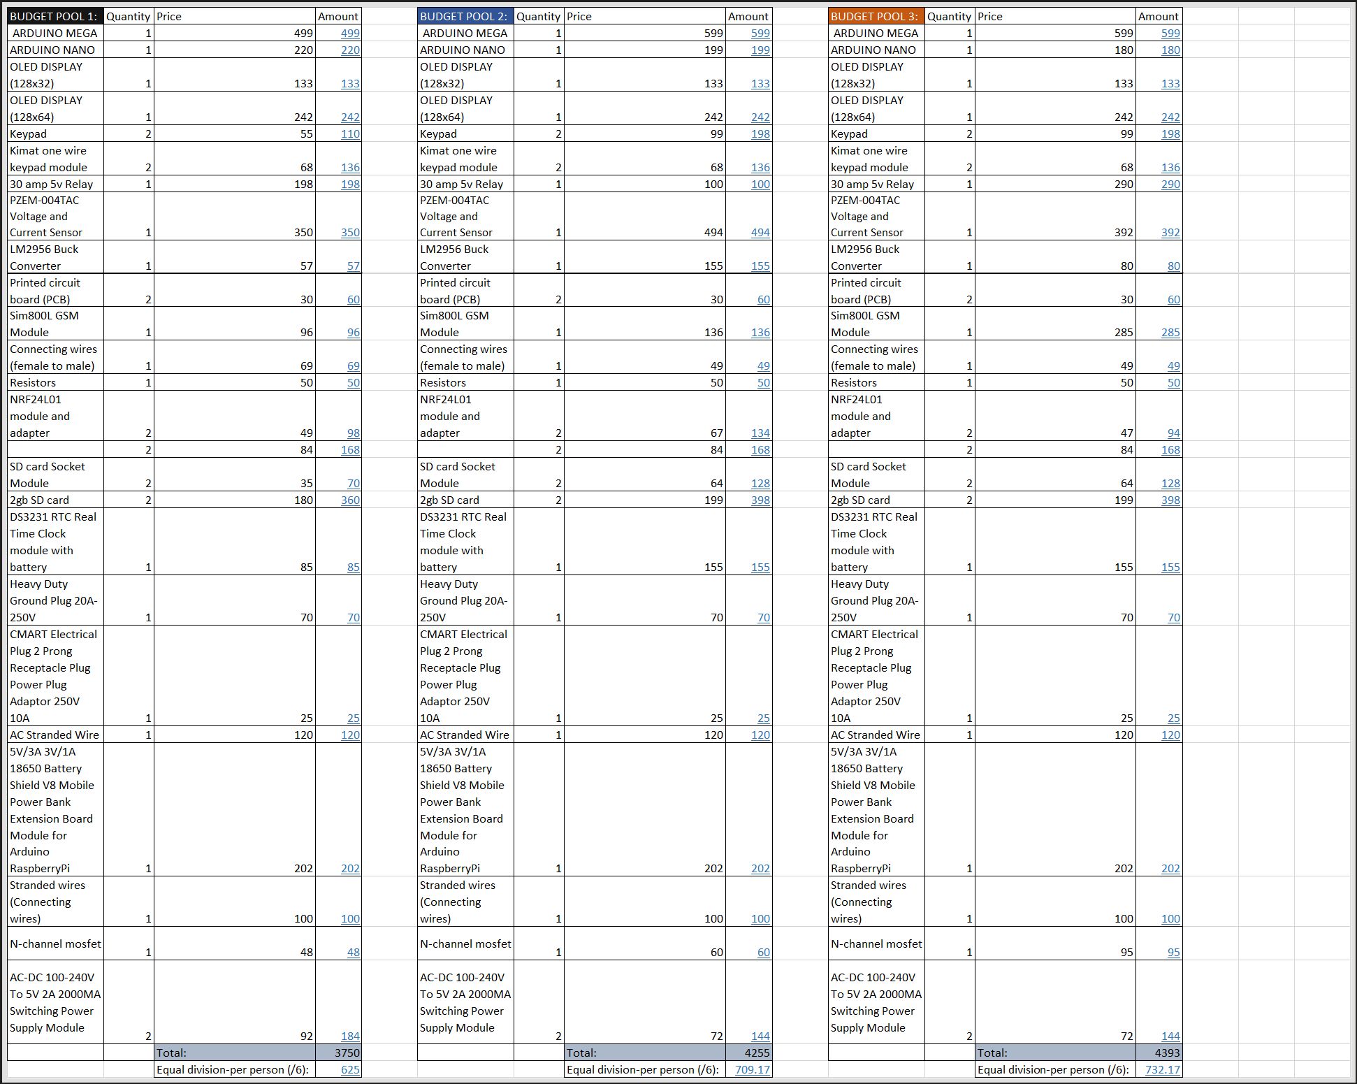
[picture p113: figure]

Budget Plan for Purchasing of Components 1.1

Saturday, 7 August 2021

8:10 pm

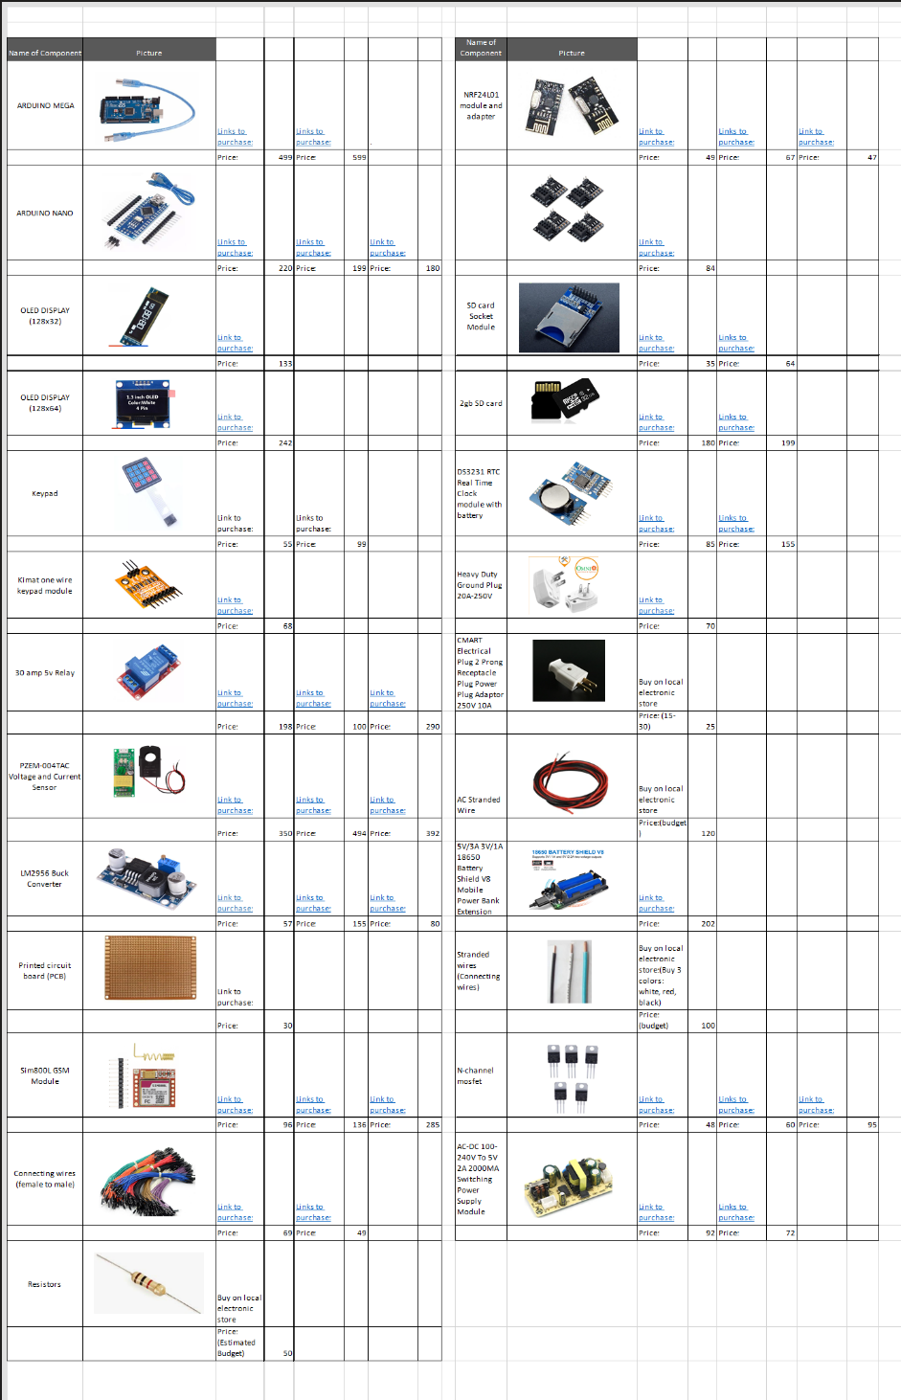
[picture p114: figure]
