theOfficial-IrvinGiL/Thesis-1-and-2-Documentations-and-Papers/CAD and System Schematics/Diagrams/Components Pictures/1-channel-5v-relay-module-30amp.jpg

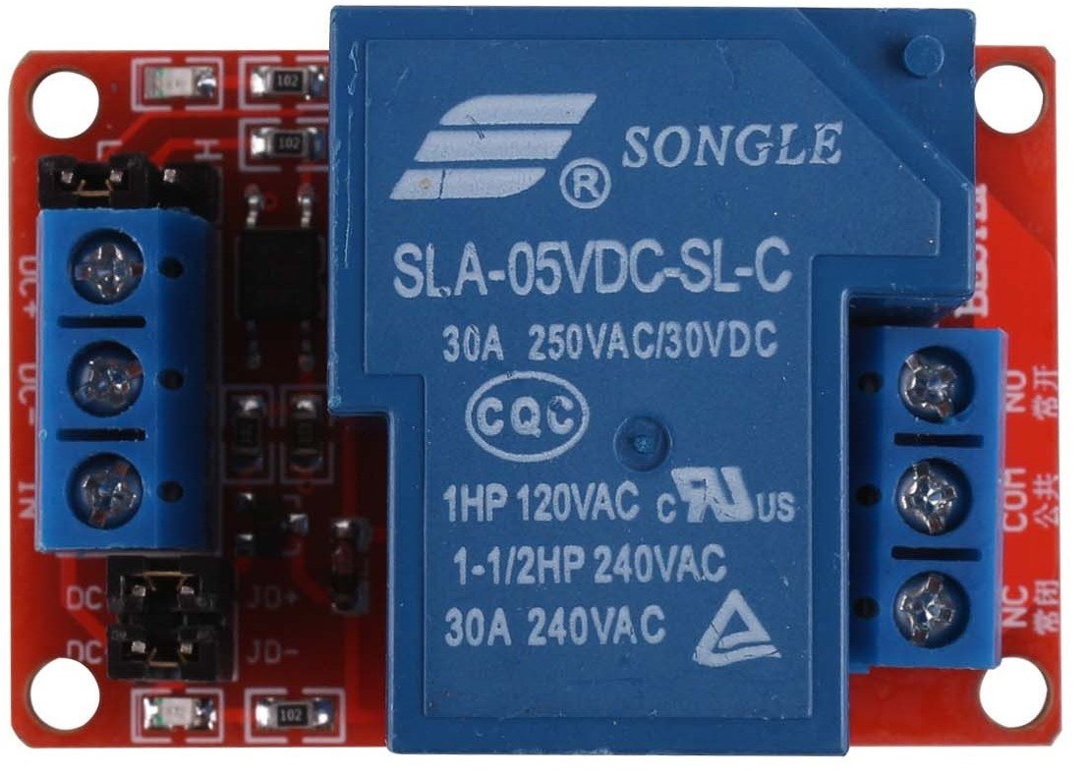
CAD and System Schematics/Diagrams/Components Pictures/1-channel-5v-relay-module-30amp.jpg
