theOfficial-IrvinGiL/Thesis-1-and-2-Documentations-and-Papers/CAD and System Schematics/Diagrams/Components Pictures/AC-DC 12V Switching Power Supply Module.png

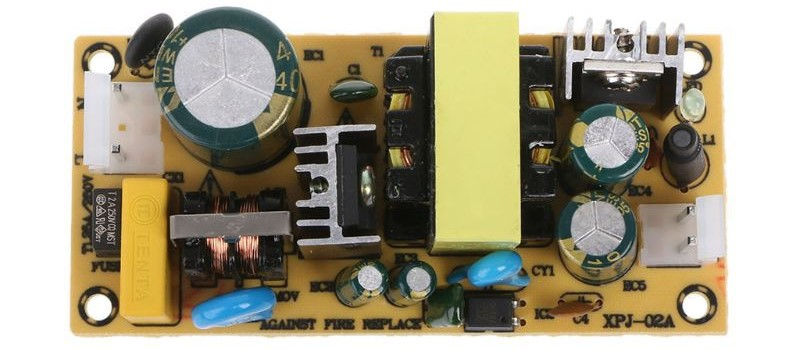
CAD and System Schematics/Diagrams/Components Pictures/AC-DC 12V Switching Power Supply Module.png
