theOfficial-IrvinGiL/Thesis-1-and-2-Documentations-and-Papers/CAD and System Schematics/Diagrams/Components Pictures/ESP32S ESP32 0.5A Micro USB Charger Board 18650 Battery Charging Shield with battery.jpeg

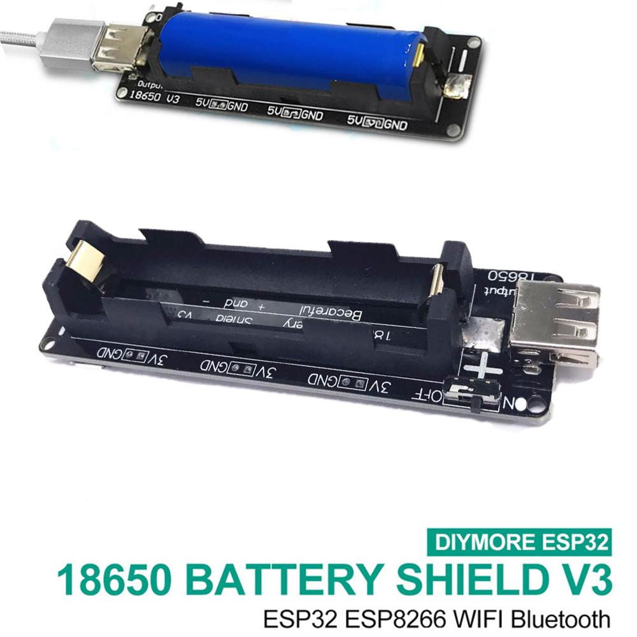
CAD and System Schematics/Diagrams/Components Pictures/ESP32S ESP32 0.5A Micro USB Charger Board 18650 Battery Charging Shield with battery.jpeg
