theOfficial-IrvinGiL/Thesis-1-and-2-Documentations-and-Papers/CAD and System Schematics/Diagrams/Components Pictures/LM2956 Buck Converter.png

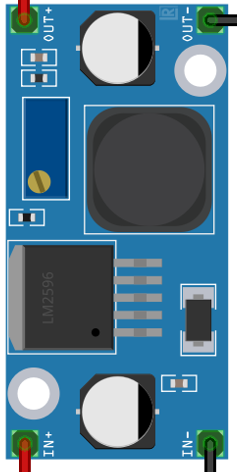
CAD and System Schematics/Diagrams/Components Pictures/LM2956 Buck Converter.png
