theOfficial-IrvinGiL/Thesis-1-and-2-Documentations-and-Papers/CAD and System Schematics/Diagrams/Components Pictures/Monochrome-OLED-display.png

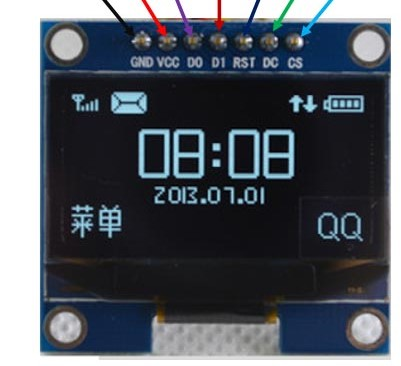
CAD and System Schematics/Diagrams/Components Pictures/Monochrome-OLED-display.png
