theOfficial-IrvinGiL/Thesis-1-and-2-Documentations-and-Papers/CAD and System Schematics/Diagrams/Components Pictures/nrf24l01 and adapter.png

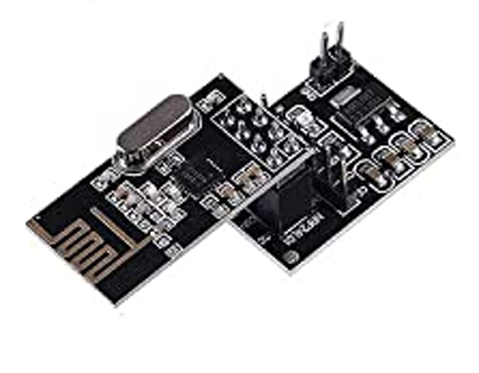
CAD and System Schematics/Diagrams/Components Pictures/nrf24l01 and adapter.png
