theOfficial-IrvinGiL/Thesis-1-and-2-Documentations-and-Papers/CAD and System Schematics/Diagrams/Components Pictures/ports and plugs/AG7og48Y1566806878.jpg

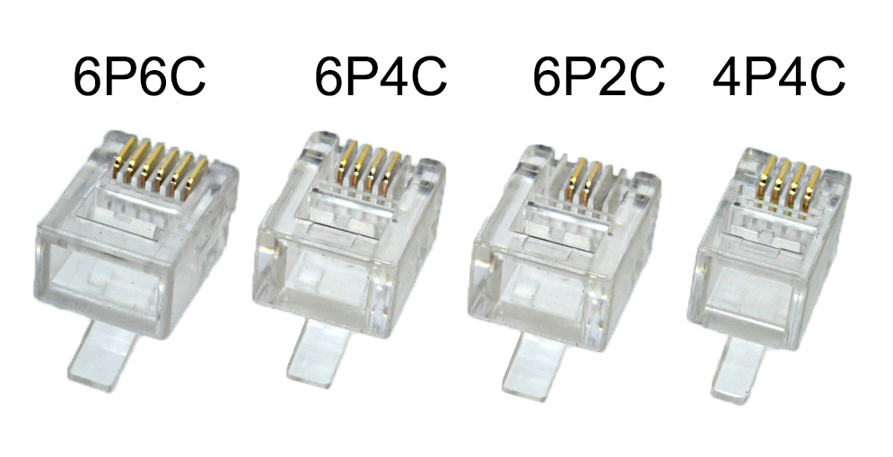
CAD and System Schematics/Diagrams/Components Pictures/ports and plugs/AG7og48Y1566806878.jpg
