theOfficial-IrvinGiL/Thesis-1-and-2-Documentations-and-Papers/CAD and System Schematics/Diagrams/Components Pictures/PZCT 02 _Current Sensor.png

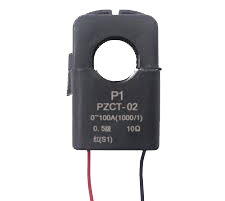
CAD and System Schematics/Diagrams/Components Pictures/PZCT 02 _Current Sensor.png
