theOfficial-IrvinGiL/Thesis-1-and-2-Documentations-and-Papers/CAD and System Schematics/Diagrams/Components Pictures/Real time clock.png

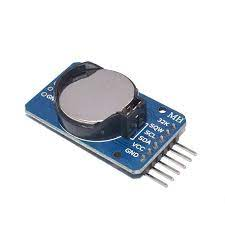
CAD and System Schematics/Diagrams/Components Pictures/Real time clock.png
