theOfficial-IrvinGiL/Thesis-1-and-2-Documentations-and-Papers/CAD and System Schematics/main unit parts1.png

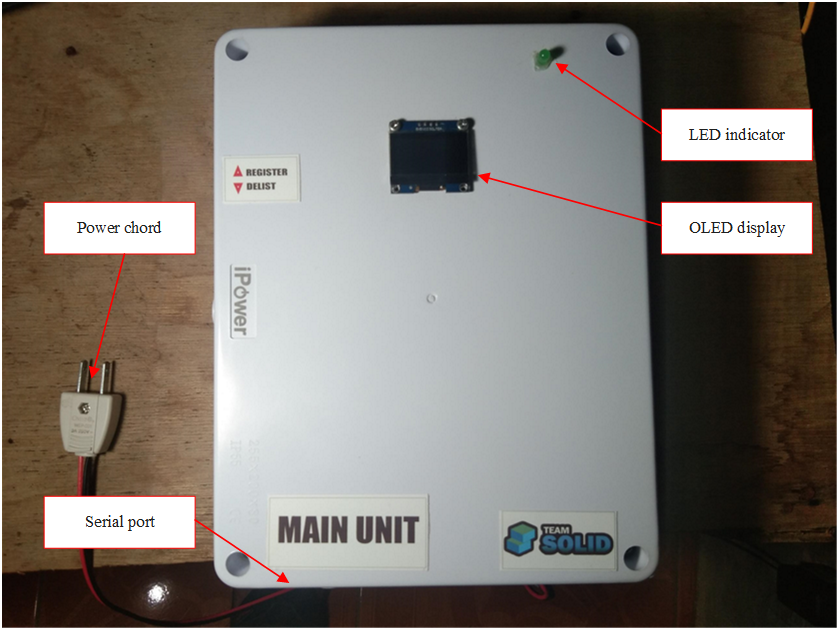
CAD and System Schematics/main unit parts1.png
