theOfficial-IrvinGiL/Thesis-1-and-2-Documentations-and-Papers/CAD and System Schematics/meter unit parts.png

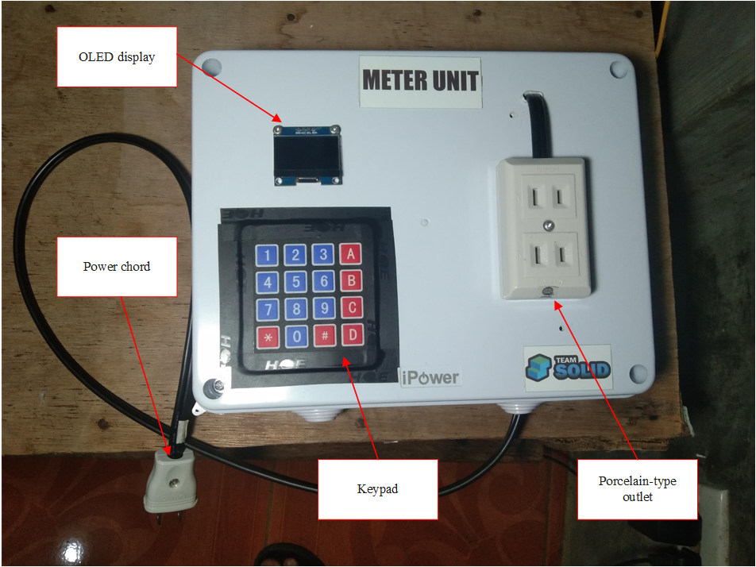
CAD and System Schematics/meter unit parts.png
