theOfficial-IrvinGiL/Thesis-1-and-2-Documentations-and-Papers/Project Documentation/components datasheet/reference multitester.png

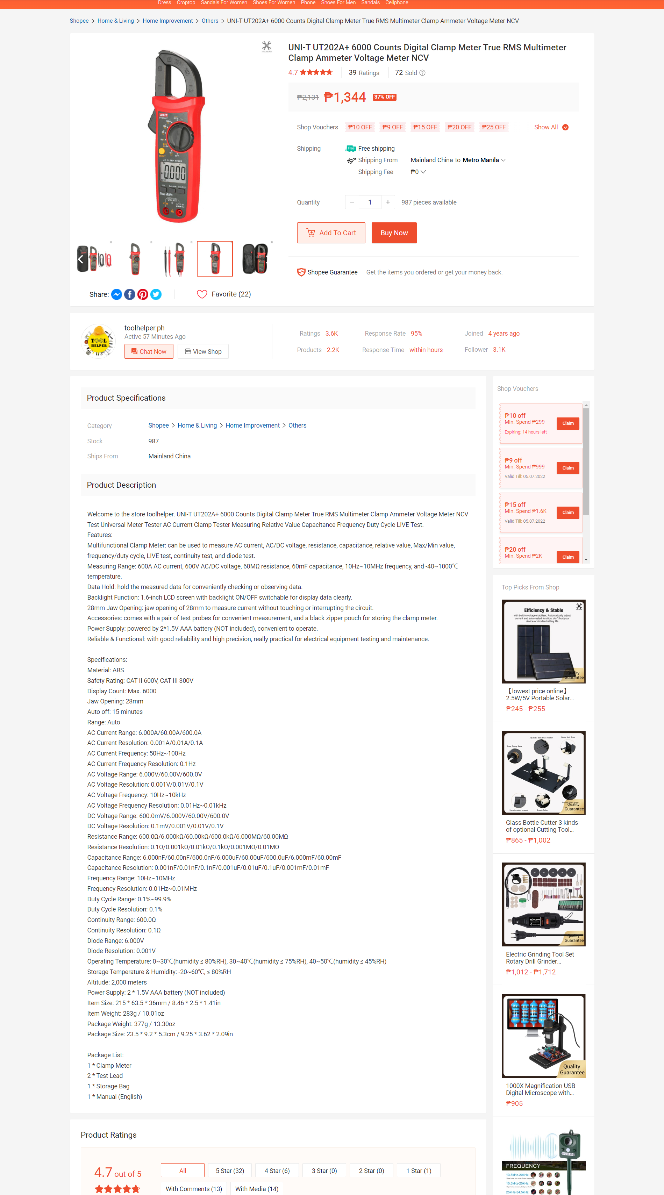
Project Documentation/components datasheet/reference multitester.png
