theOfficial-IrvinGiL/Thesis-1-and-2-Documentations-and-Papers/Project Documentation/components datasheet/switch mode power supply.png

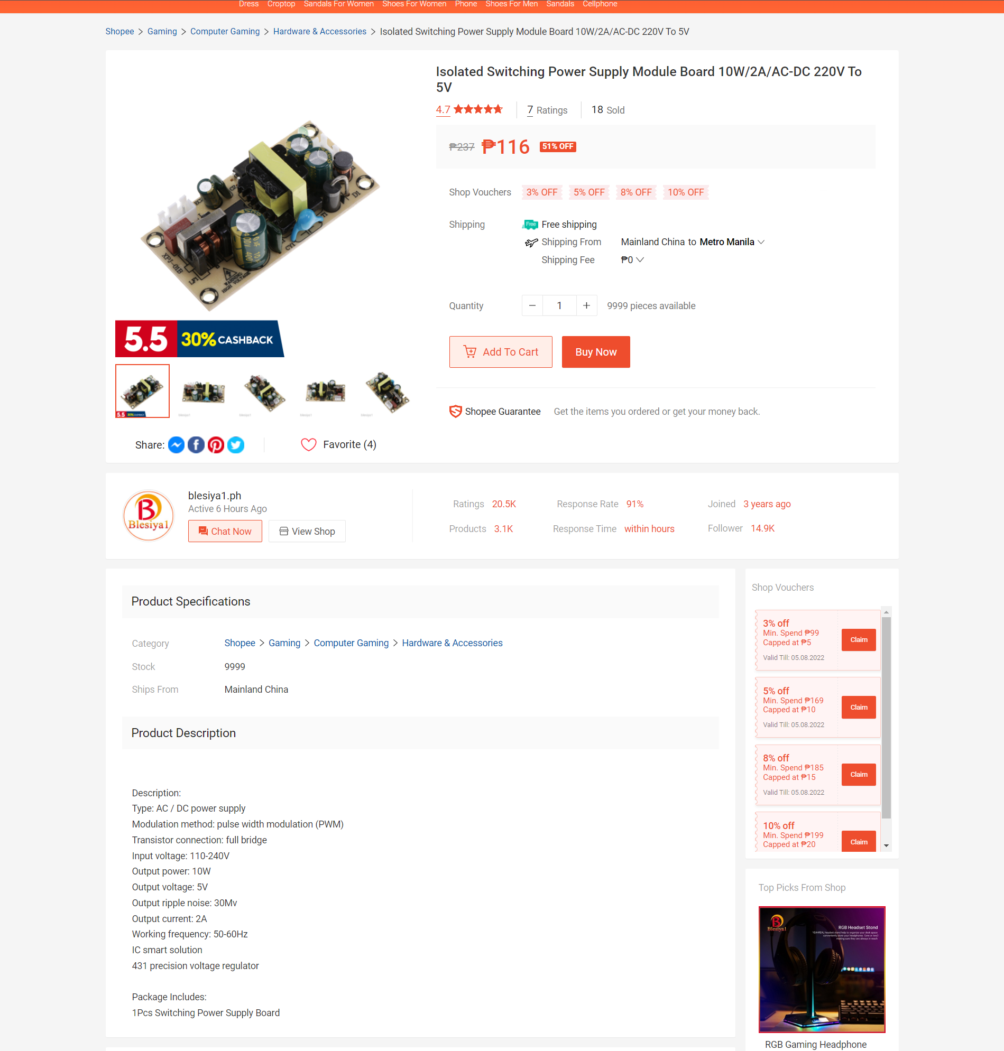
Project Documentation/components datasheet/switch mode power supply.png
