theOfficial-IrvinGiL/Thesis-1-and-2-Documentations-and-Papers/Autocad Projects/CAD Essential drawing files_ Electronic components/WALL OUTLET WITH PLUG.SLDASM

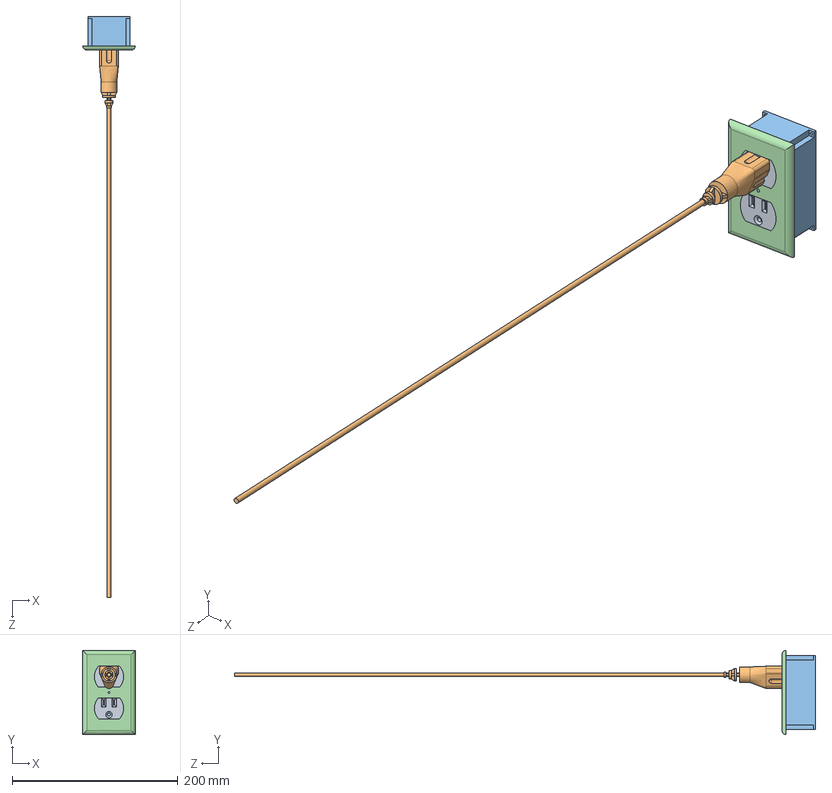
[picture p139: CAD file, 2022-03-27]
Autocad Projects/CAD Essential drawing files_ Electronic components/WALL OUTLET WITH PLUG.SLDASM
63.5 x 101.6 x 701.0 mm
OUTLET x 2
ELECTRICAL PLUG
OUTLET BASE
OUTLET COVER
