theOfficial-IrvinGiL/Thesis-1-and-2-Documentations-and-Papers/Autocad Projects/CAD Essential drawing files_ Electronic components/M8coarse.STEP

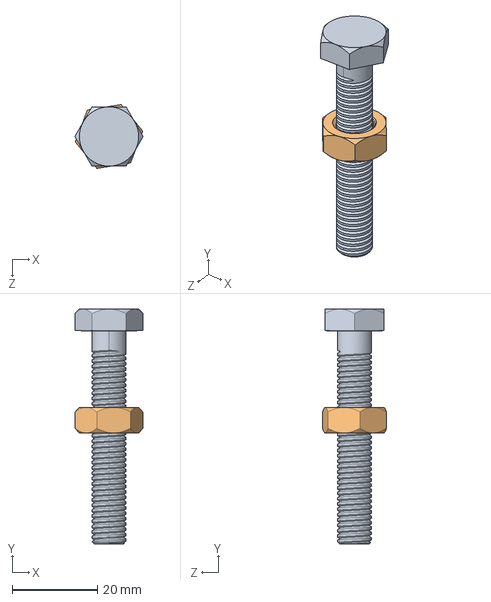
[picture p140: CAD file, 2022-03-27]
Autocad Projects/CAD Essential drawing files_ Electronic components/M8coarse.STEP
16.0 x 55.0 x 14.9 mm
