theOfficial-IrvinGiL/Thesis-1-and-2-Documentations-and-Papers/Autocad Projects/CAD Essential drawing files_ Electronic components/SIM800L v10.step

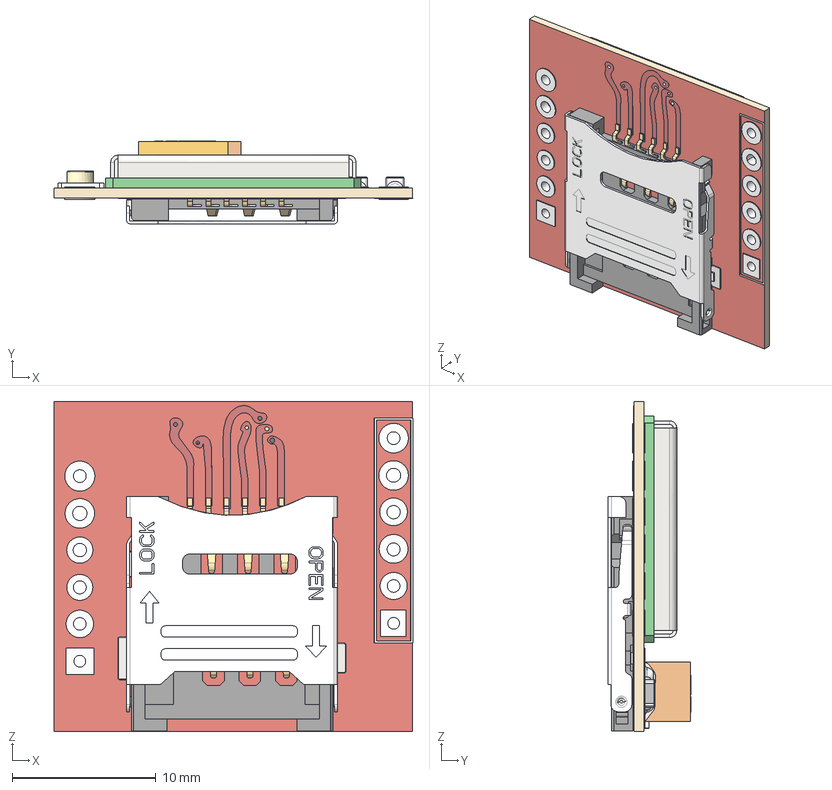
[picture p141: CAD file, 2022-03-27]
Autocad Projects/CAD Essential drawing files_ Electronic components/SIM800L v10.step
25.0 x 5.77 x 23.0 mm
PCB
Cage
CH03-HB
