theOfficial-IrvinGiL/Thesis-1-and-2-Documentations-and-Papers/Autocad Projects/CAD Essential drawing files_ Electronic components/RJ45.SLDPRT

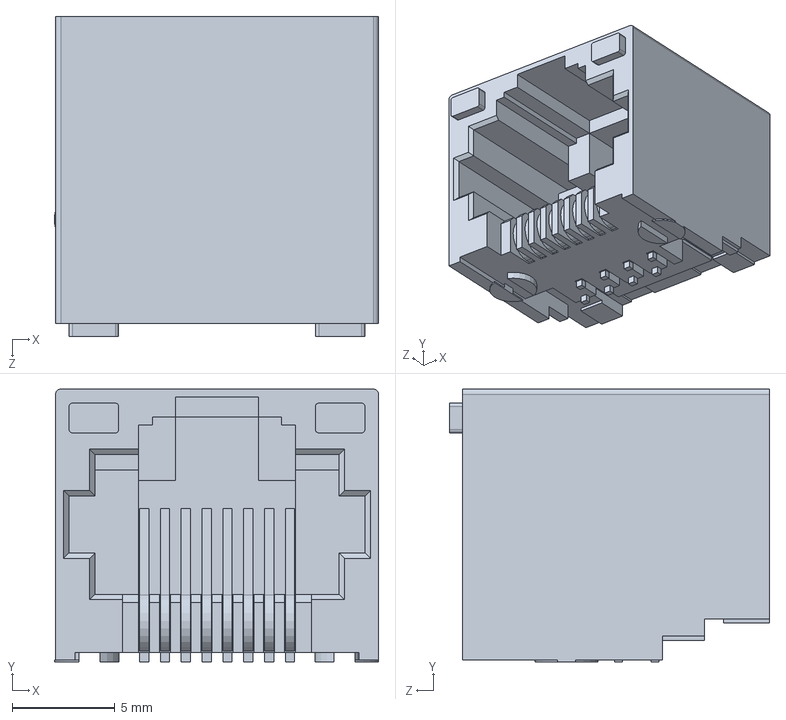
[picture p142: CAD file, 2022-03-27]
Autocad Projects/CAD Essential drawing files_ Electronic components/RJ45.SLDPRT
15.8 x 13.3 x 15.6 mm
