theOfficial-IrvinGiL/Thesis-1-and-2-Documentations-and-Papers/Autocad Projects/CAD Essential drawing files_ Electronic components/Keypad 3x4.STEP

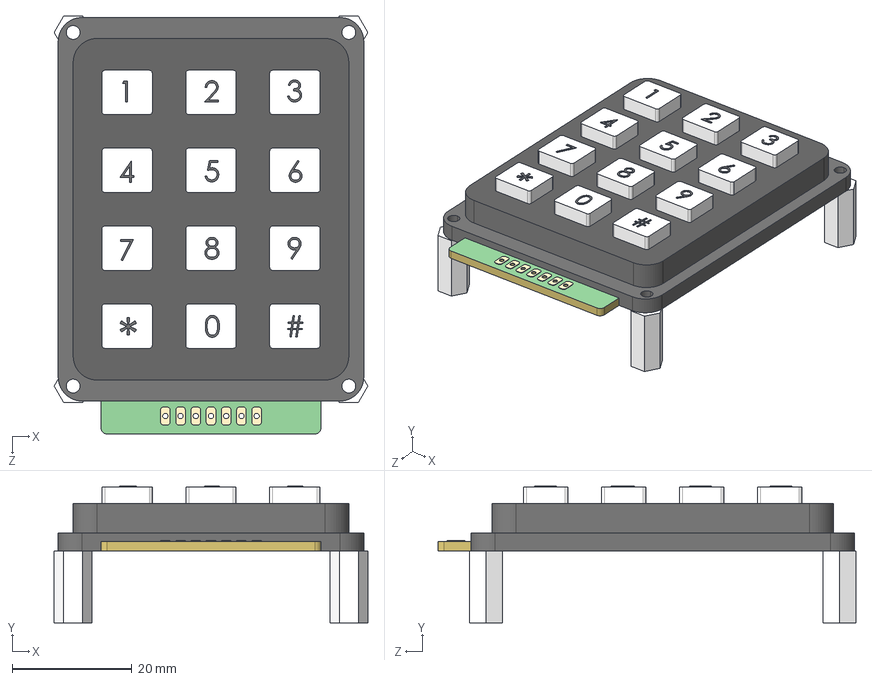
[picture p143: CAD file, 2022-03-27]
Autocad Projects/CAD Essential drawing files_ Electronic components/Keypad 3x4.STEP
52.4 x 22.8 x 69.8 mm
