theOfficial-IrvinGiL/Thesis-1-and-2-Documentations-and-Papers/Autocad Projects/CAD Essential drawing files_ Electronic components/OLED 128x64.STP

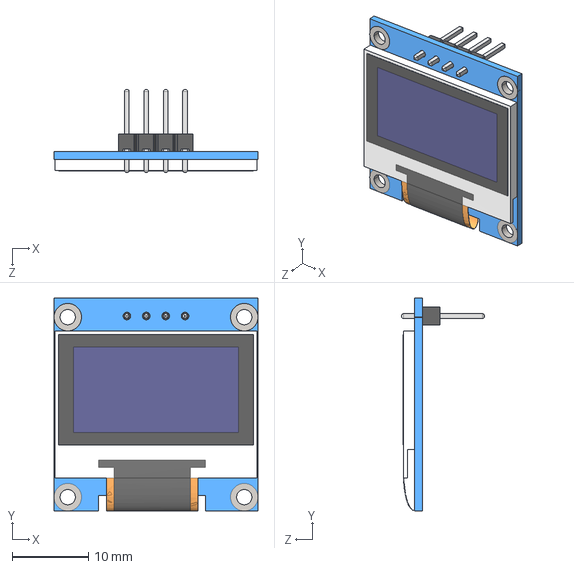
[picture p144: CAD file, 2022-03-27]
Autocad Projects/CAD Essential drawing files_ Electronic components/OLED 128x64.STP
26.7 x 27.9 x 10.8 mm
