theOfficial-IrvinGiL/Thesis-1-and-2-Documentations-and-Papers/Autocad Projects/CAD Essential drawing files_ Electronic components/Bread Board Designs 1B.step

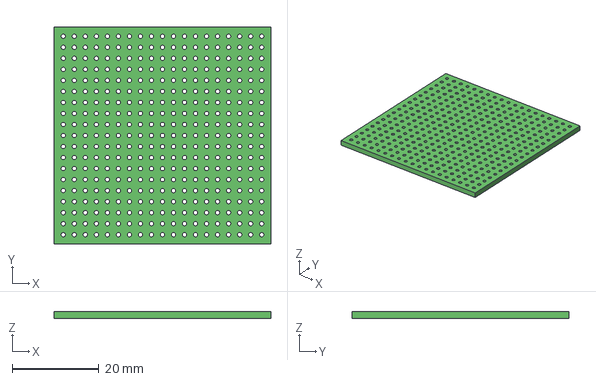
[picture p145: CAD file, 2022-03-27]
Autocad Projects/CAD Essential drawing files_ Electronic components/Bread Board Designs 1B.step
50.0 x 50.0 x 1.55 mm
