theOfficial-IrvinGiL/Thesis-1-and-2-Documentations-and-Papers/Autocad Projects/CAD Essential drawing files_ Electronic components/ArduinoMega_STEP_AP203.STEP

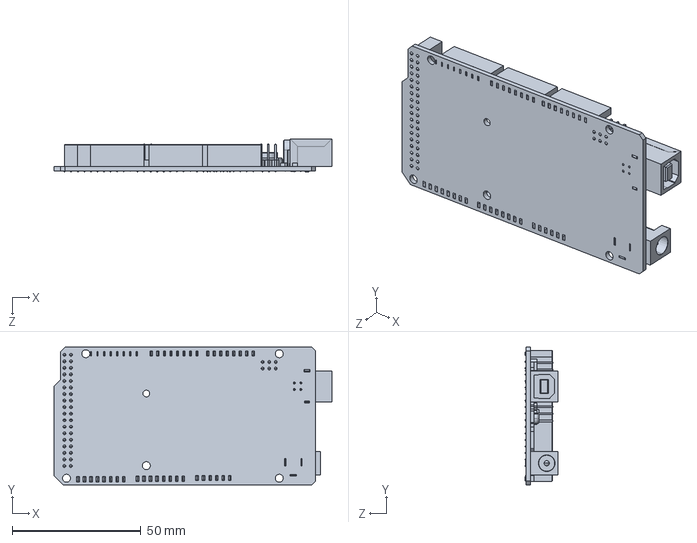
[picture p146: CAD file, 2022-03-27]
Autocad Projects/CAD Essential drawing files_ Electronic components/ArduinoMega_STEP_AP203.STEP
107.9 x 53.4 x 13.0 mm
