theOfficial-IrvinGiL/Thesis-1-and-2-Documentations-and-Papers/Autocad Projects/CAD Essential drawing files_ Electronic components/Arduino Nano V3.step

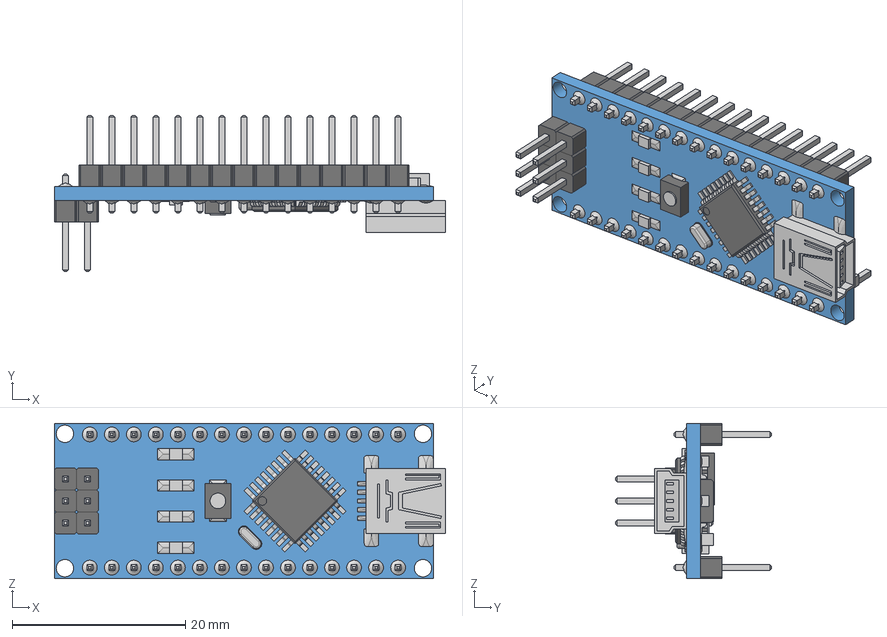
[picture p147: CAD file, 2022-03-27]
Autocad Projects/CAD Essential drawing files_ Electronic components/Arduino Nano V3.step
45.1 x 18.0 x 17.9 mm
switch
Led x 3
Led (1)
Pin x 21
chip1
USB
Crystal
Pin (1) x 15
Res x 5
cap x 2
Chip
respack x 2
diode
vreg
