theOfficial-IrvinGiL/Thesis-1-and-2-Documentations-and-Papers/Autocad Projects/CAD Essential drawing files_ Electronic components/AC plug 2.SLDPRT

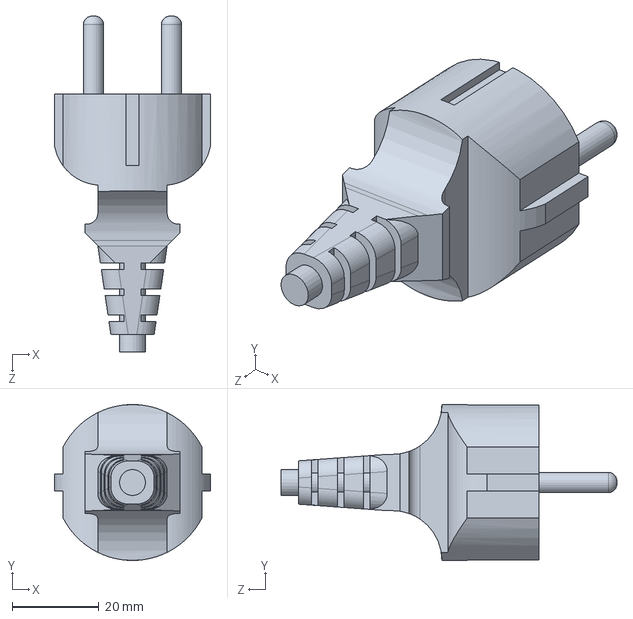
[picture p148: CAD file, 2022-03-27]
Autocad Projects/CAD Essential drawing files_ Electronic components/AC plug 2.SLDPRT
36.0 x 36.0 x 77.5 mm
