theOfficial-IrvinGiL/Thesis-1-and-2-Documentations-and-Papers/Autocad Projects/CAD Essential drawing files_ Electronic components/SGS-A v4.iges

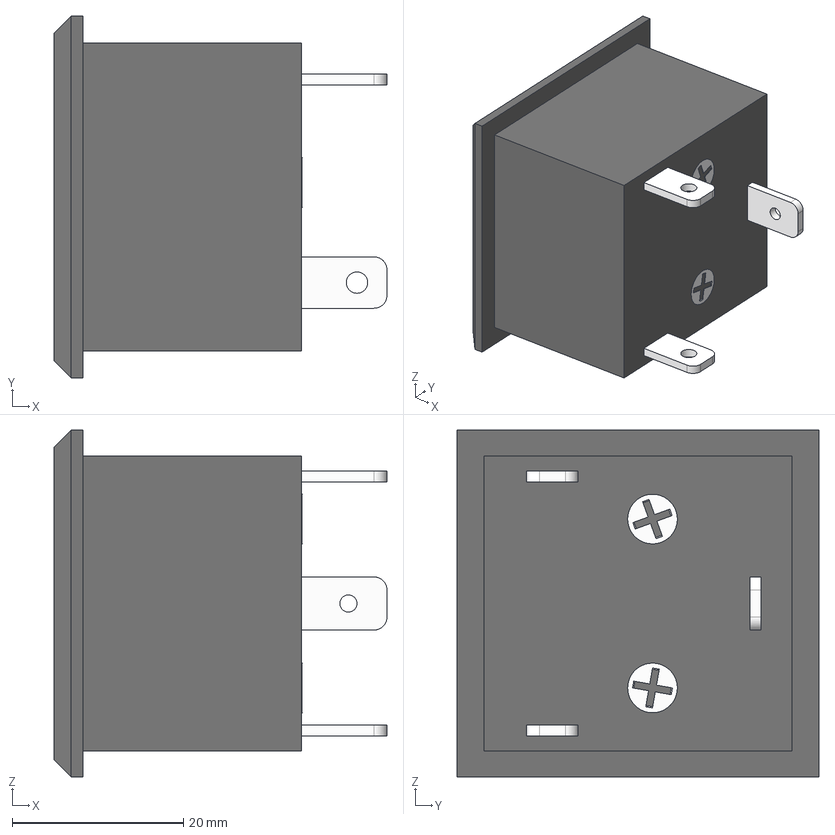
[picture p149: CAD file, 2022-03-27]
Autocad Projects/CAD Essential drawing files_ Electronic components/SGS-A v4.iges
38.9 x 42.3 x 40.5 mm
