theOfficial-IrvinGiL/Thesis-1-and-2-Documentations-and-Papers/Autocad Projects/CAD Essential drawing files_ Electronic components/Power strip.STEP

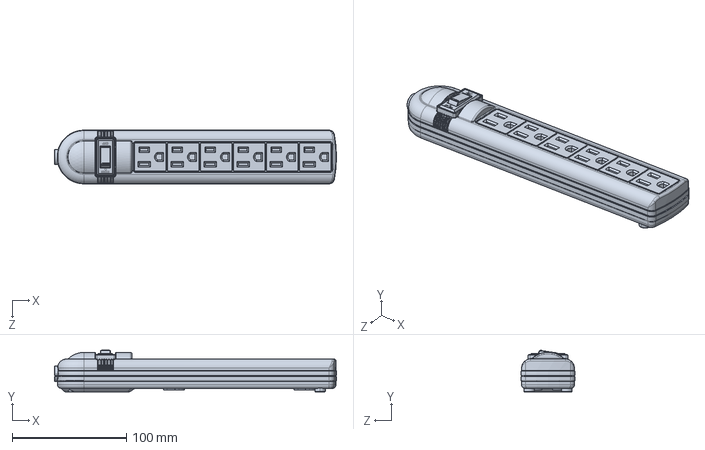
[picture p150: CAD file, 2022-03-27]
Autocad Projects/CAD Essential drawing files_ Electronic components/Power strip.STEP
246.6 x 36.7 x 47.0 mm
