theOfficial-IrvinGiL/Thesis-1-and-2-Documentations-and-Papers/Autocad Projects/CAD Essential drawing files_ Electronic components/SPDT slide switch.IGS

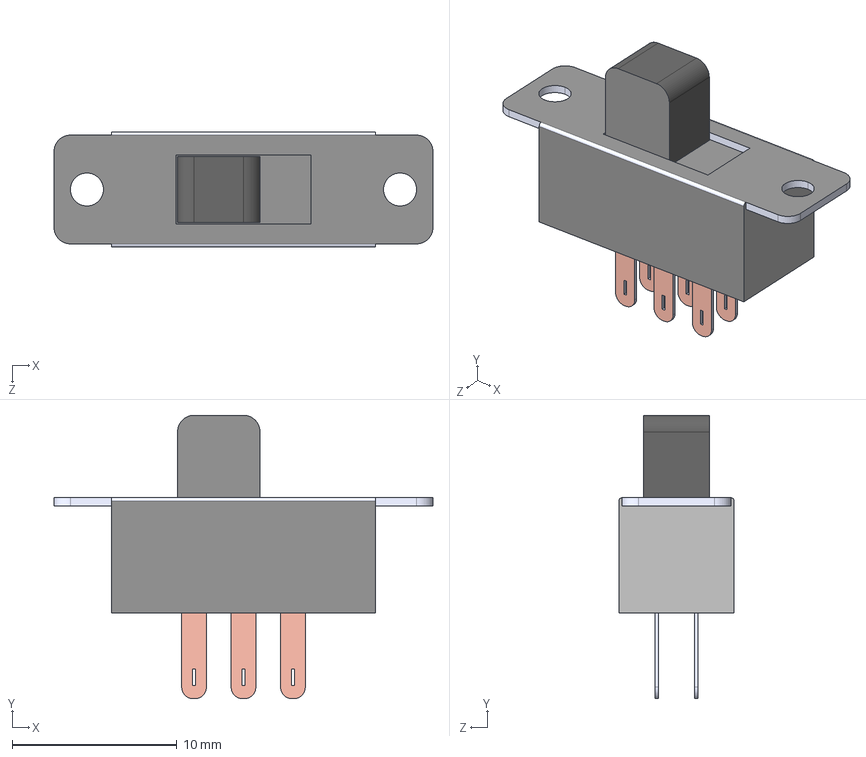
[picture p151: CAD file, 2022-03-27]
Autocad Projects/CAD Essential drawing files_ Electronic components/SPDT slide switch.IGS
23.0 x 17.2 x 7.00 mm
