theOfficial-IrvinGiL/Thesis-1-and-2-Documentations-and-Papers/Autocad Projects/CAD Essential drawing files_ Electronic components/Screw ST2.2.step

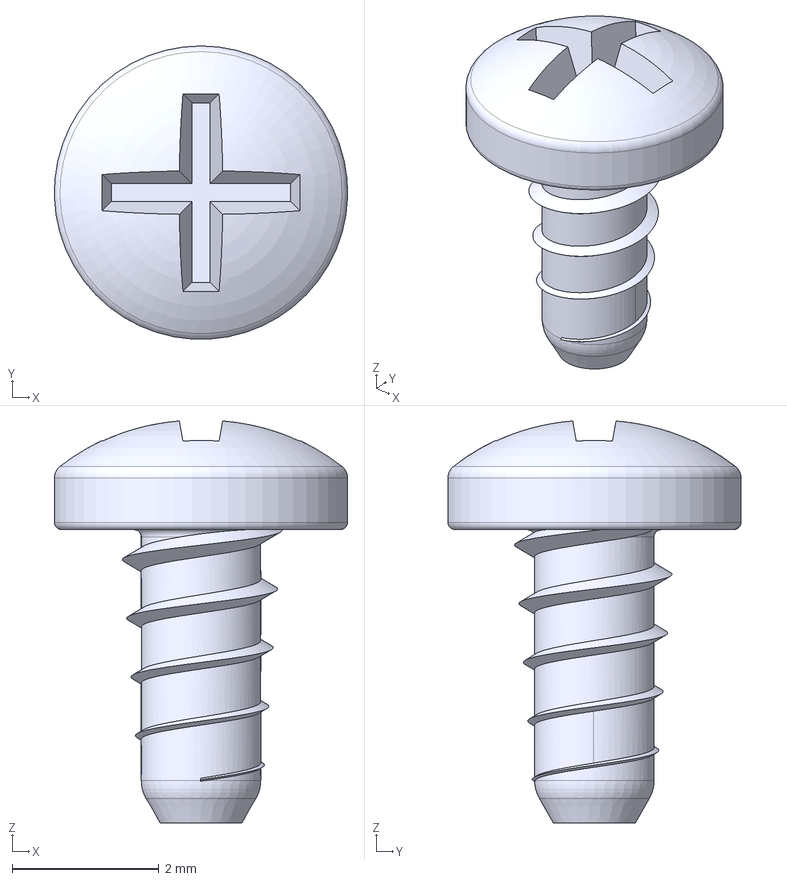
[picture p152: CAD file, 2022-03-27]
Autocad Projects/CAD Essential drawing files_ Electronic components/Screw ST2.2.step
4.00 x 4.00 x 5.48 mm
