theOfficial-IrvinGiL/Thesis-1-and-2-Documentations-and-Papers/(list of files, cad)

Other CAD files:
Autocad Projects/PCB making demonstration.dwg
Autocad Projects/CAD Essential drawing files_ Electronic components/Electronic_Components_-_Sainsmart_-_2_Channel_Relay_Board.dwg
Autocad Projects/CAD Essential drawing files_ Electronic components/3x4 Keypad.ipt
