theOfficial-IrvinGiL/Thesis-1-and-2-Documentations-and-Papers/CAD and System Schematics/Infographics and manuals/for data gathering.pptx

## Individualized Electric Energy Monitoring System

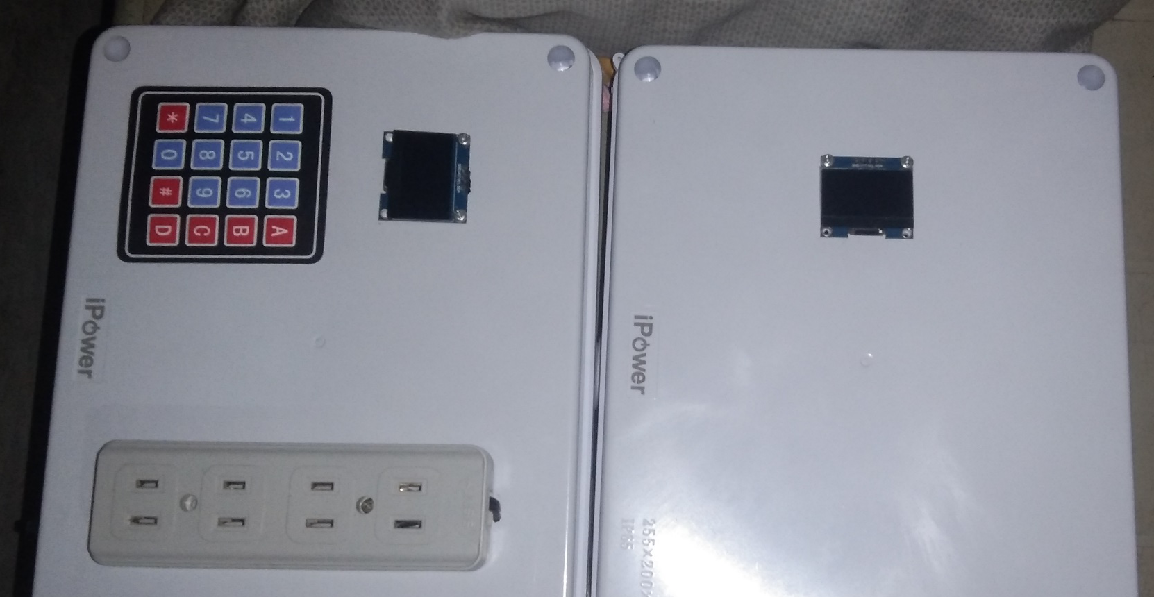
[picture p153: figure]

A

Steps:
1. Register as a user using the Android application for the system. Ask for the assistance of the administrative personnel.

2. Provide your full name and your active contact number when registering as a new user.

3. A passcode will be generated by the application upon finishing the registration process.
Use the generated passcode to access electricity on the meter unit. Remember not to share your passcode so it will not be used without your consent.

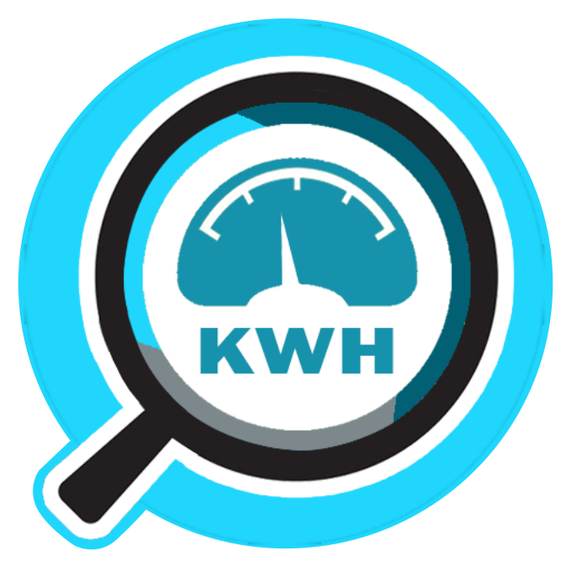
[picture p154: figure]

B

Instructions & User manual

In accessing electric energy through the meter unit:
1. Enter your unique passcode, that was given to you after being registered as a new user, on the meter unit by pressing the keypad on the device.
The inputted values are shown on the OLED display.

2. If you wish to clear your input, press the “B” key on the keypad.

3. Press the “A” key to validate your passcode and access electricity.
If you want to stop using the device, just unplug it from the meter. The meter will detect if there is any load connected and turn off if there is no device/load in the circuit.

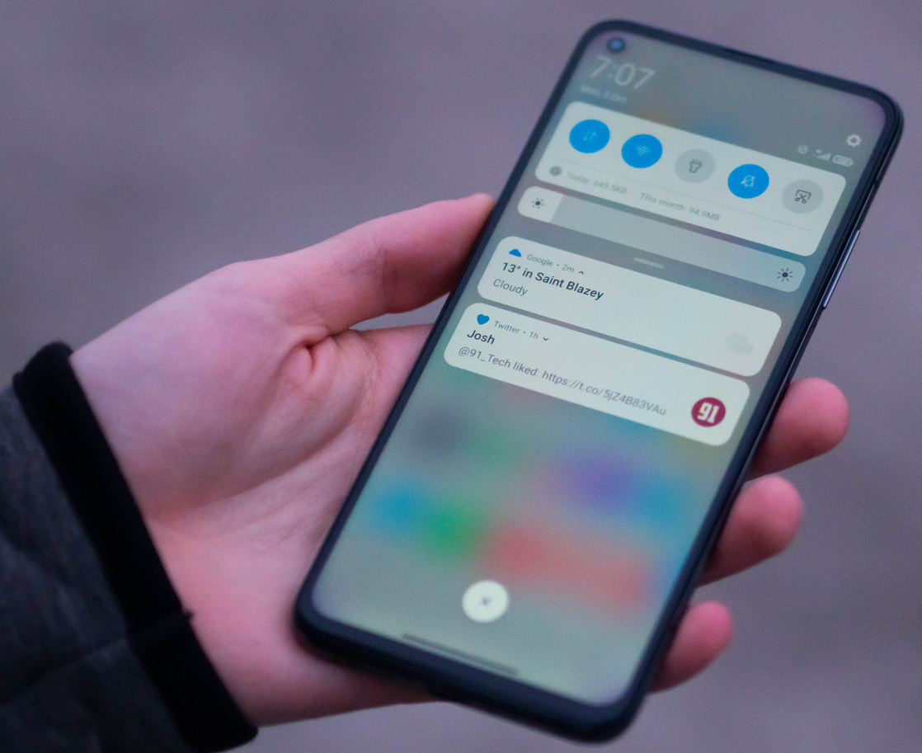
[picture p155: figure]
How to turn off Safe Mode on Android - Android Authority
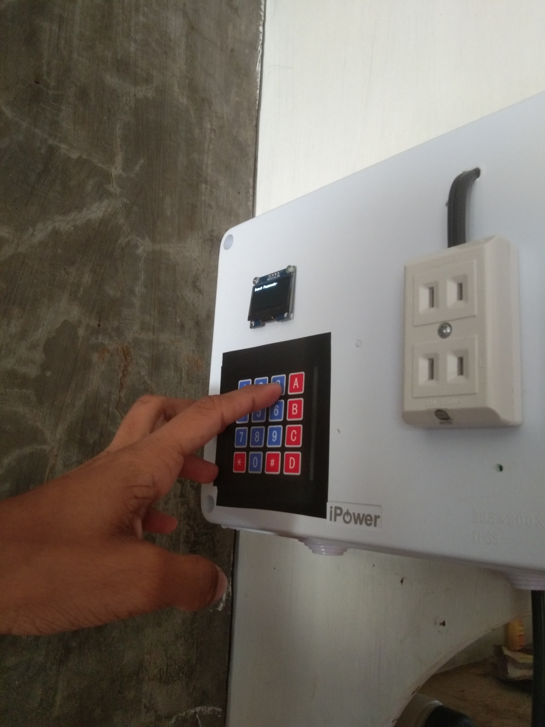
[picture p156: figure]
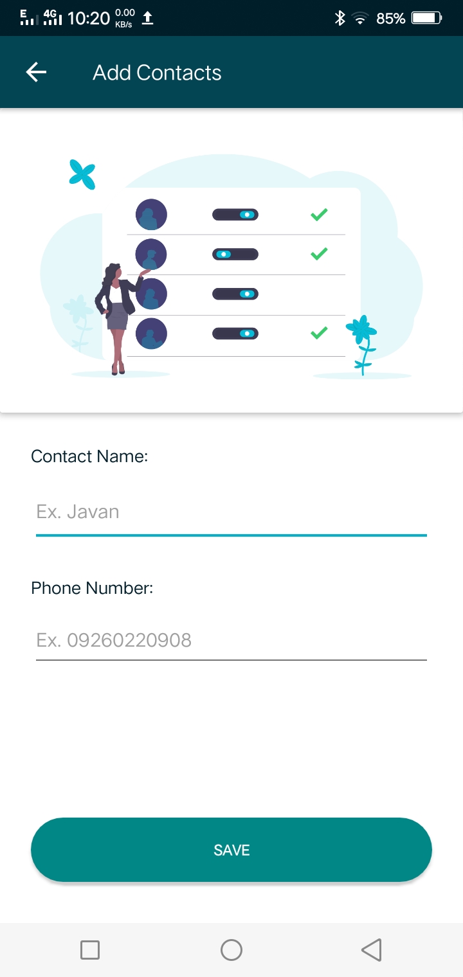
[picture p157: figure]

Electrical Appliances that are allowed to be used with the system:

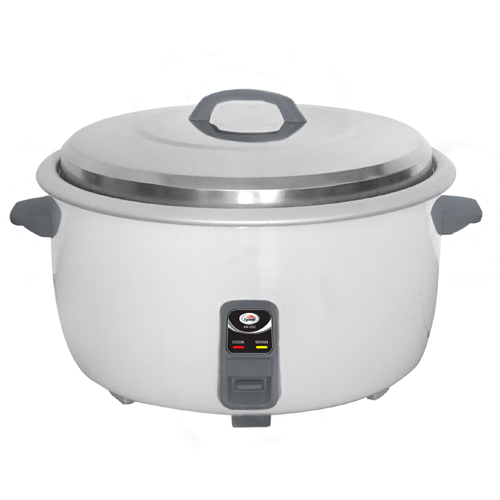
[picture p158: figure]
Rice Cooker 10L (KW-2056) – Kyowa Philippines

Rice cooker

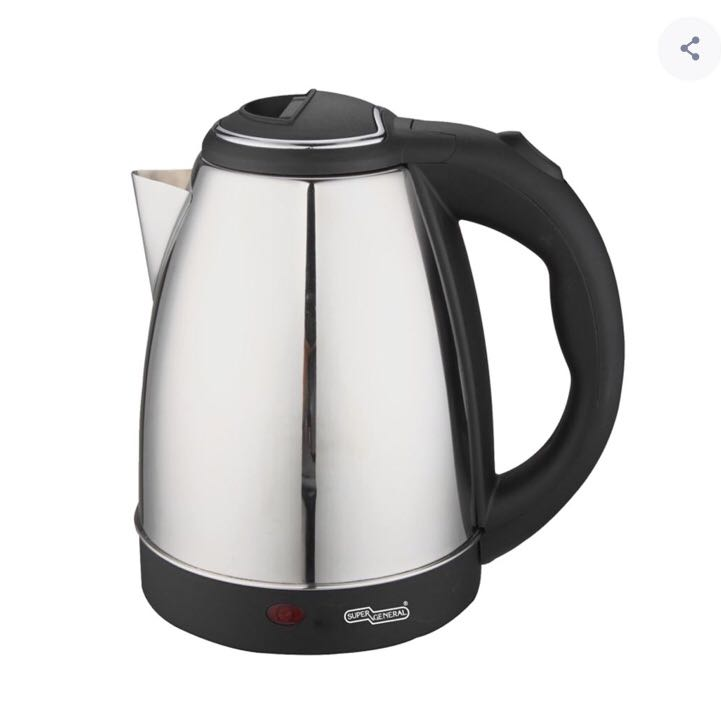
[picture p159: figure]
Super General Kettle Water Heater, TV & Home Appliances, Kitchen Appliances, Kettles & Airpots on Carousell

Water heater

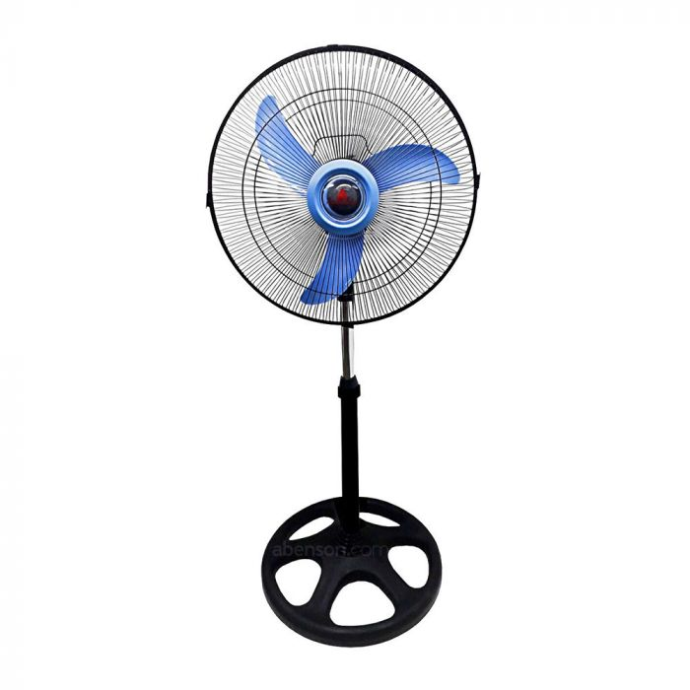
[picture p160: figure]
Hanabishi HSF16AB Electric Stand Fan | Fans and Air Coolers | Small Appliance | Abenson.com

Electric Fan

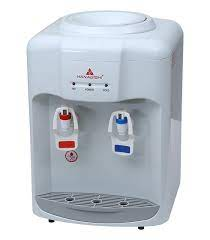
[picture p161: figure]
Hanabishi Water Dispenser HTTWD200

Electric Water Dispenser

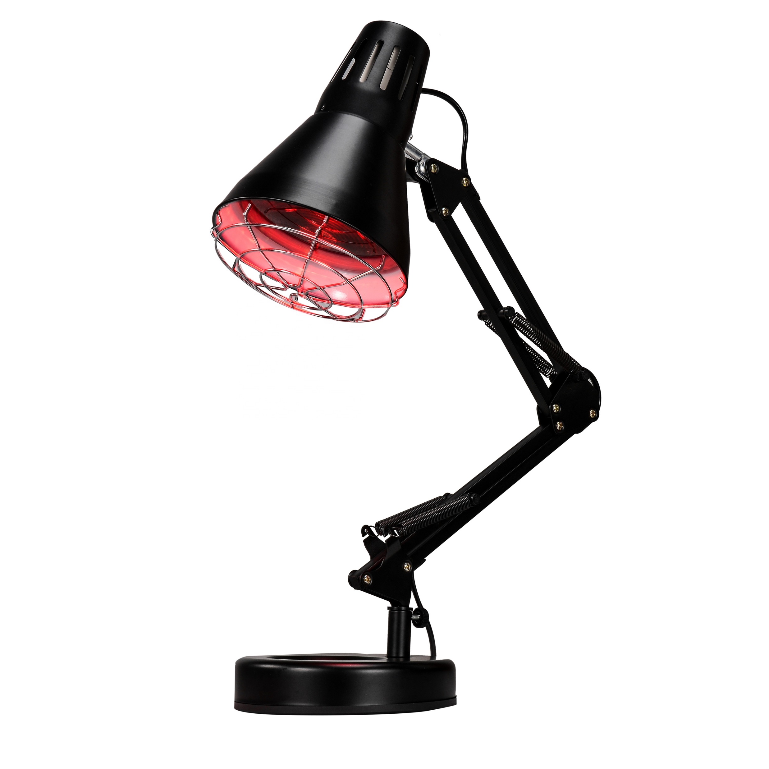
[picture p162: figure]
Appliance Home Medical Salon Desk Infrared Heat Lamp Heating Light Physical Therapy Lamp Physiotherapy Device Therapy Machine - Buy Physical Therapy Equipments Rehabilitation,Physical Therapy Equipments Pain Relief,Physical Rehabilitation Equipment ...

Desk Lamp

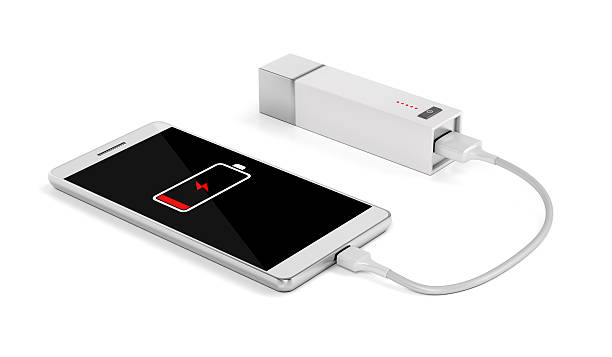
[picture p163: figure]
15,446 Mobile Phone Charger Stock Photos, Pictures & Royalty-Free Images - iStock

Cellphone Charger

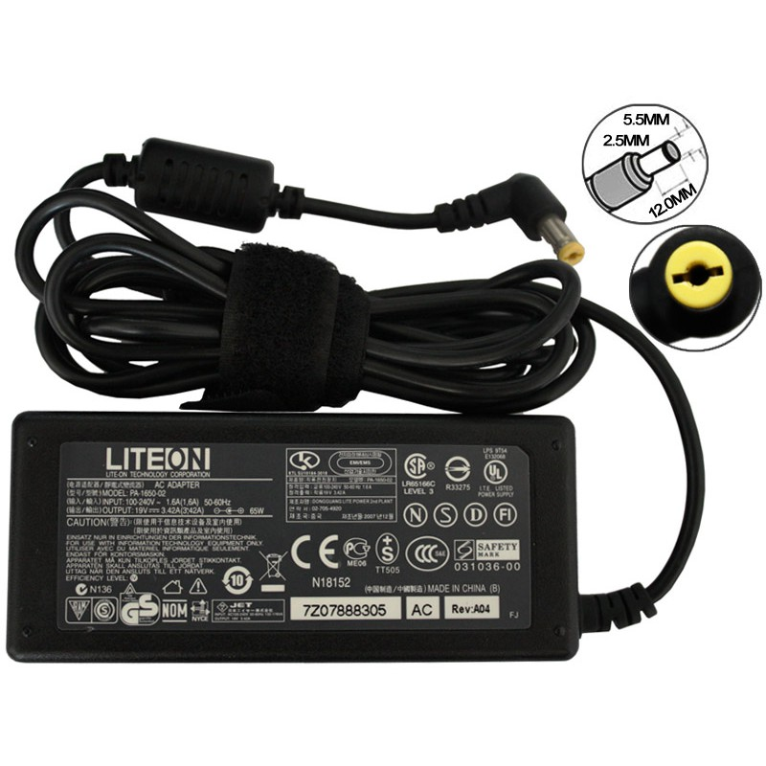
[picture p164: figure]
laptop charger adapter for neo 19v 3.42a | Shopee Philippines

Laptop Charger

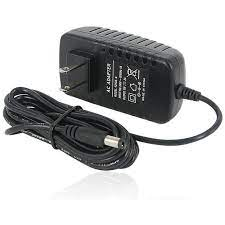
[picture p165: figure]
12 Volt 2A Power Adapter Supply AC to DC 2.1mm X 5.5mm Plug 12v 2 Amp Power Supply | Shopee Philippines

Wifi Power Adapter (12V adapter)

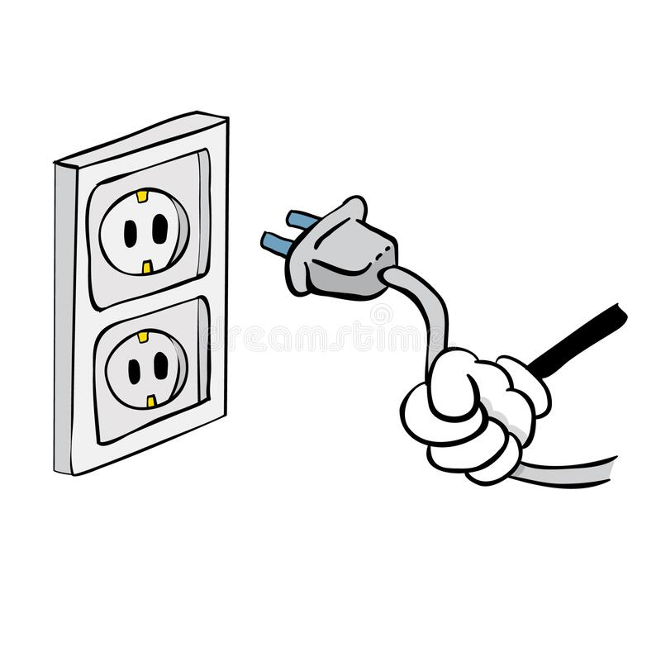
[picture p166: figure]
Hand unplugging cable stock vector. Illustration of service - 183212925

Participation and Consent Form

You are being invited to participate in a protype testing of the thesis study titled "Individualized Electric Energy Consumption Monitoring." This study is being done by students from the Department of Computer Engineering at Southern Leyte State University—Main Campus.
The purpose of this research study is to test and observe the deployment of the developed system prototype in its target environment.
The prior usage of the prototype system is shown and organized above. All the data gathered during the time of deployment is going to be used solely for the purpose of completing the study and nothing more. Respondents will be briefed on the proper usage of the system and safety measures. Any actions being taken that violate the researcher's warnings are outside the scope of the researcher’s responsibility.
If you agree to the terms and participate in the study, please fill in the form below:
I agree to the terms and conditions.
Full Name:______________________________________________
Role:__________________________________________________
(ex. Study respondent, Boarding house owner/operator)
