theOfficial-IrvinGiL/Thesis-1-and-2-Documentations-and-Papers/drafts/instruction demo.docx

1) Registering new use
  a) Set the meter unit to update mode
  b) Register the new user using the android application
  c) Turn on OTG on android settings
  d) Turn off the secondary microcontroller switch on the main unit
  e) Go to the serial port of the main unit and disconnect the serial communication to the secondary microcontroller. Do not forget to connect the serial line after updating.
  f) Plug the USB serial with the OTG adapter to the serial port of the main unit
  g) Connect the serial communication app on the smartphone
  h) Press the register button on the main unit and wait for the message on the screen
  i) Paste the new generated passcode of the new user and hit send
  j) Wait for the system to update. Turn on the secondary microcontroller switch and restart the main unit after updating.
2) Using the meter unit
  a) Enter your unique passcode that was given prior on registration
  b) Press “B” to clear your input and “A” to enter.
  c) Just unplug the appliance that you connected when you want to stop using the system.
3) Data sorting
  a) Get the SD card from the meter unit and plug it into your computer using an SD card adapter
  b) Copy the unsorted data from the txt file and paste it into an empty excel spreadsheet
  c) Enter and plot the passcodes of the users along with their names into the extra empty cells on the bottom.
  d) Create a table description on the remaining empty cells of the spreadsheet for “Passcode”, “Date”, “Time”, and “User” in the correct order.
  e) Select the cells containing the unsorted data. And under the data clipboard, use the “Text to column function to separate the unsorted data.
  f) Under the user column, use the vertical lookup function to identify the user of the consumption data. Set the reference table into constant by adding $ into each of the spreadsheet index addresses.
  g) Select the table of the sorted data and insert the pivot table.
  h) Drag and drop the contents of the pivot table into the desired positions for a detailed and more organized data presentation.
4) Billing procedure
  a) Use the developed android app of the system for this procedure.
  b) Click on the manage energy consumption button and click on the update energy consumption card.
  c) Use the official bill for the electric energy cooperative to input the total KWH used and the bill amount. Then select the reading date.
  d) Select the name of the user and input their energy consumption. Use the sorted data from the pivot table generated on the application as a reference.
  e) Click “calculate and send” and review the confirmation dialog.
  f) Send the SMS notification to the user. The SMS message will be saved as a draft if you have no cellular load so the message can be sent if there is a cellular load on the smartphone.
