theOfficial-IrvinGiL/Thesis-1-and-2-Documentations-and-Papers/drafts/Correction guides files/225903545_544748100199200_6920618952495311361_n.png

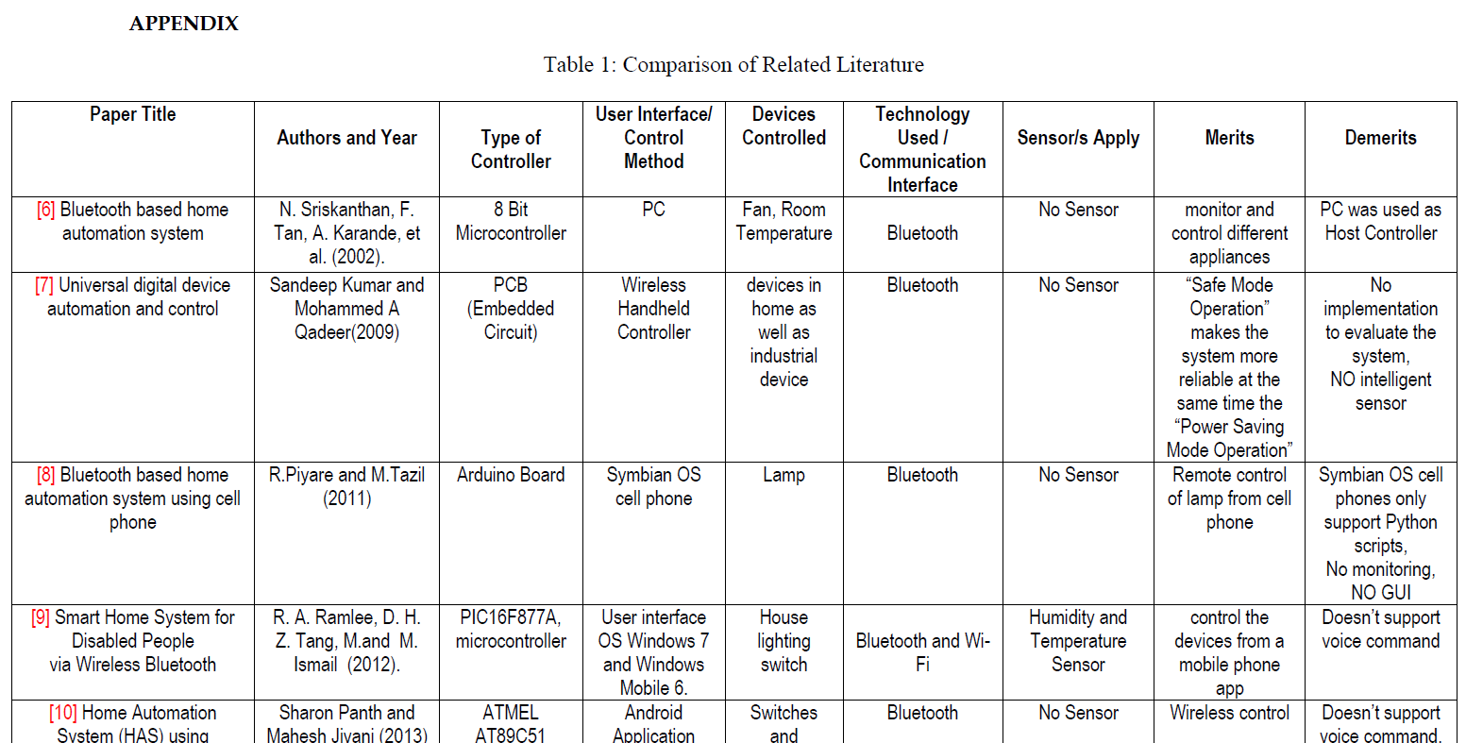
drafts/Correction guides files/225903545_544748100199200_6920618952495311361_n.png
