theOfficial-IrvinGiL/Thesis-1-and-2-Documentations-and-Papers/Testings Data/Initial-prototype-testings.xlsx

Sheet: First set of test - meter unit
Test conducted on meter unit
Name of appliance: | Device rating: | Power | Current draw: | Energy consumed: | Time span during test
Standar Electric Fan | unknown | 46 - 47 watts | 0.23 Amps | 0.01 kwh | 10 min.
Water Heater | unknown | 1004.799987792 - 1213.599975585 watts | 5.616000175 Amps | 0.032999992 kWh | 1 min.
Light Bulb | 5 watts | 5.599999904 Watts | 0.0590000051 Amps | 0.001000002 kWh | 2 min.
Phone charger | .35 A | 12.699999809 Watts | 0.098999996 Amps | 0.001000002 kWh | 5 min.

Sheet: Second set of test - meter unit
Test conducted on meter unit
Name of appliance: | Device rating: | Power | Current draw: | Energy consumed: | Time span during test
Standard Electric Fan | 230Va.c/60Hz | 9.90000 - 10.10000 W | 0.04400 - 0.04500 A | 0.0010000 kWh | 5 min.
Water Heater | 230V - 60 Hz 1500 W | 1367.4000 W | 5.95200 A | 0.0290000 kWh | 1:20:00
Light Bulb | 5 watts | 5.50000 - 5.60000 W | 0.05900 A | 0.0010000 kWh | 10 min.
Phone charger | 30 watts | 7.00000 - 10.60000 W | 0.08900 - 0.09400 A | 0.0010000 kWh | 5 min.

Sheet: Third set of test - meter unit
Test conducted on meter unit
Name of appliance: | Device rating: | Power | Current draw: | Energy consumed: | Time span during test
Standard Electric Fan | 230Va.c/60Hz | 10.90000 - 11.00000W | 0.04700 0.04900 A | 0.0010000 kWh | 5 min.
Water Heater | 230V - 60 Hz 1500 W | 1355.80000 - 1356.70000 W | 5.93400 - 5.93600 A | 0.0290000 - 0.0330000 kWh | 1:20:00
Light Bulb | 5 watts | 5.50000 - 5.60000 W | 0.05900 - 0.06000A | 0.0010000 kWh | 10 min.
Phone charger | 30 watts | 6.80000 - 8.60000 W | 0.07400 - 0.08400 A | 0.0010000 kWh | 5 min.
