theOfficial-IrvinGiL/Thesis-1-and-2-Documentations-and-Papers/Autocad Projects/Thesis CAD/Main unit (internal layout).pdf

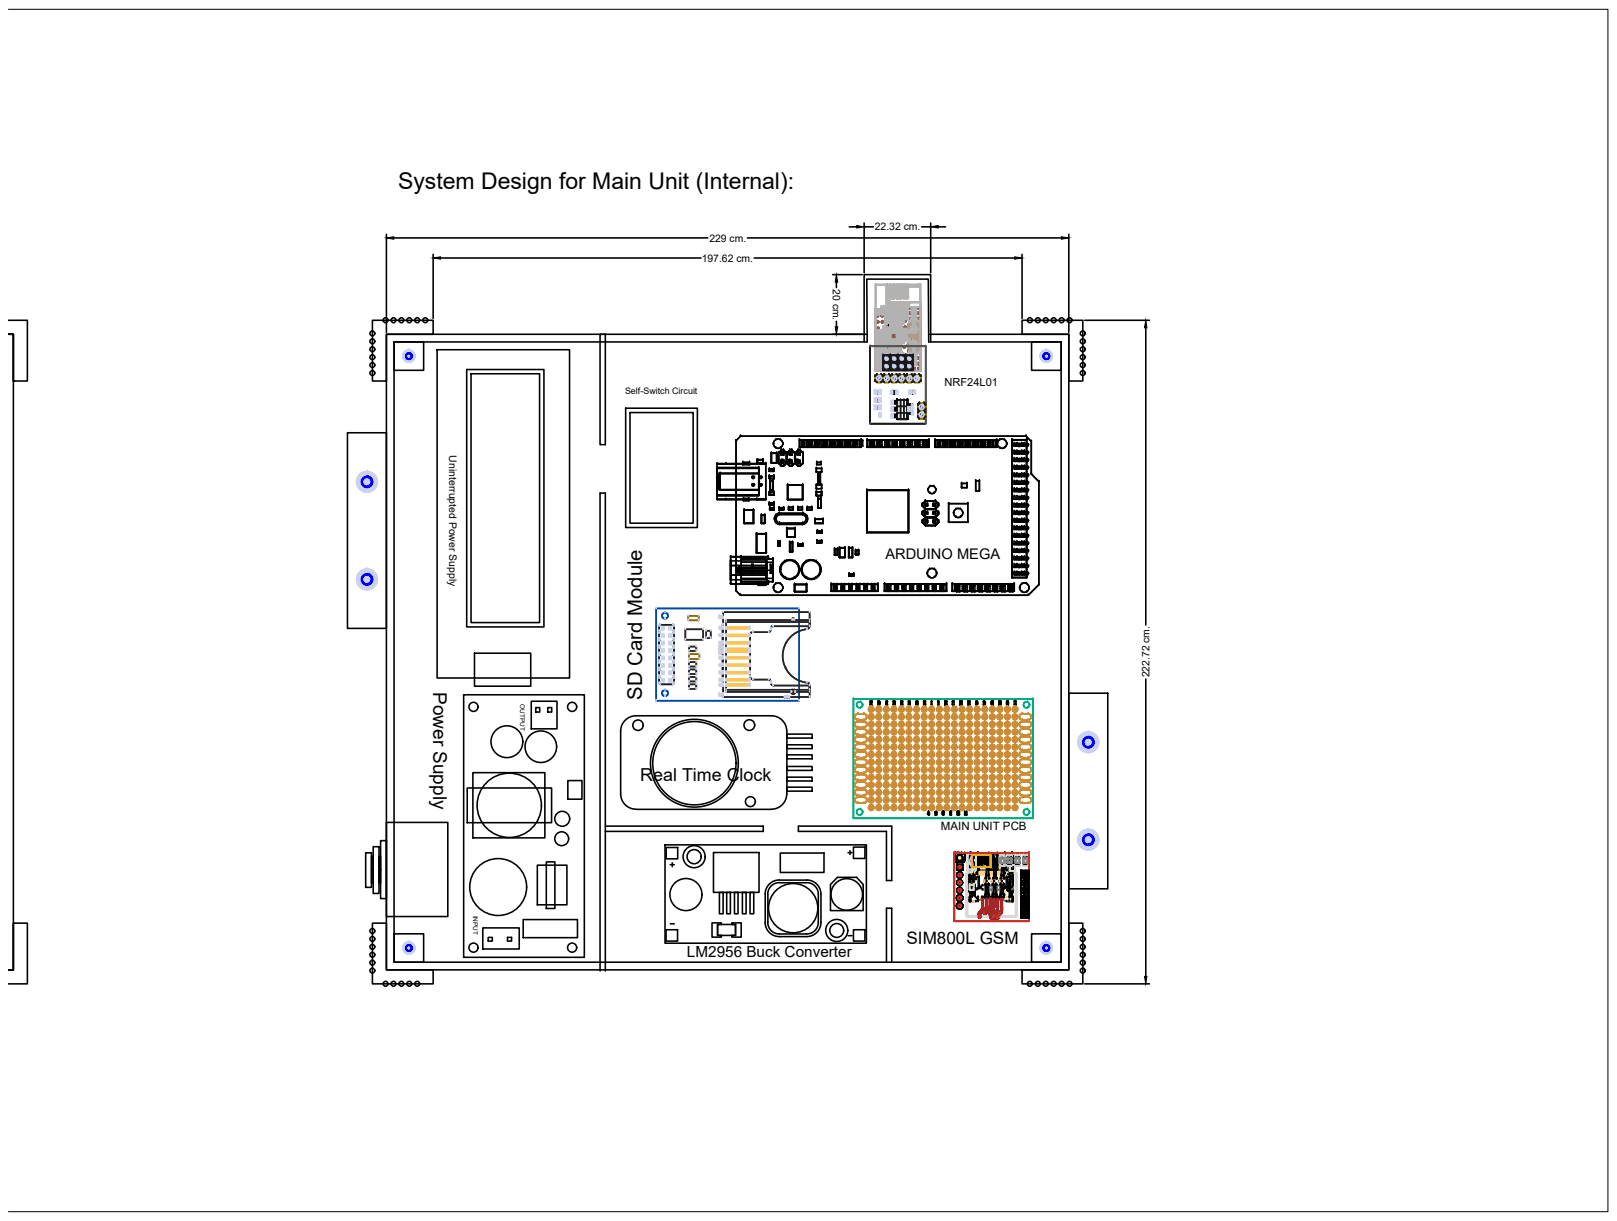
[picture p173: page 1]
System Design for Main Unit (Internal):; ARDUINO MEGA; Power Supply

Uninterrupted Power Supply Self-Switch Circuit 229 cm. 197.62 cm. 22.32 cm. 20 cm. NRF24L01

SD Card Module

222.72 cm. MAIN UNIT PCB

OUTPUT Real Time Clock SIM800L GSM LM2956 Buck Converter
