theOfficial-IrvinGiL/Thesis-1-and-2-Documentations-and-Papers/Autocad Projects/Thesis CAD/Meter Unit (Internal Layout).pdf

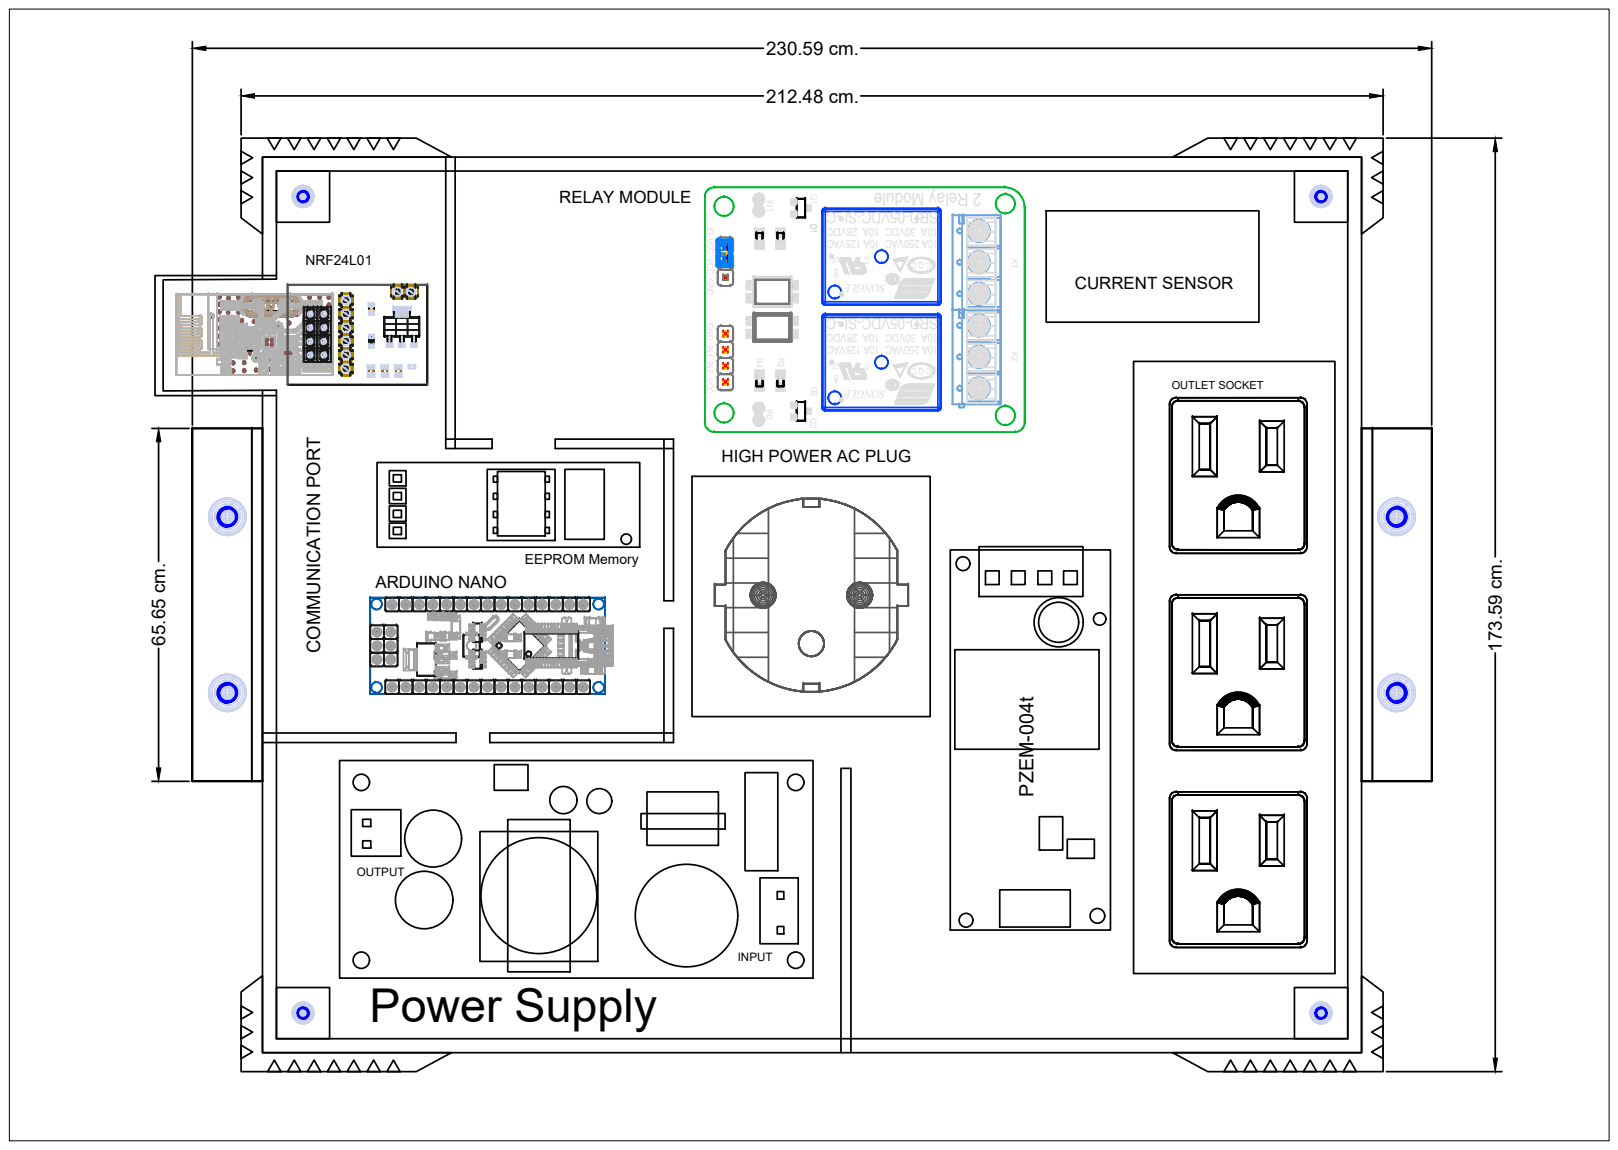
[picture p174: page 1]
ARDUINO NANO; SRD-05VDC-SL-C; 10A 30VDC 10A 28VDC; 10A 250VAC 10A 125VAC; SONGLE; C Q C C Q C SONGLE 8; 2 Relay Module; COMMUNICATION PORT NRF24L01

PZEM-004t 230.59 cm. 212.48 cm.

K2 K1 RELAY MODULE EEPROM Memory CURRENT SENSOR OUTLET SOCKET Power Supply INPUT OUTPUT

JD-VCC VCC GND GND IN1 IN2 VCC

65.65 cm. HIGH POWER AC PLUG
