theOfficial-IrvinGiL/Thesis-1-and-2-Documentations-and-Papers/CAD and System Schematics/Diagrams/architectural design.pdf

# Final Concept Design : Extended Centralized Approach

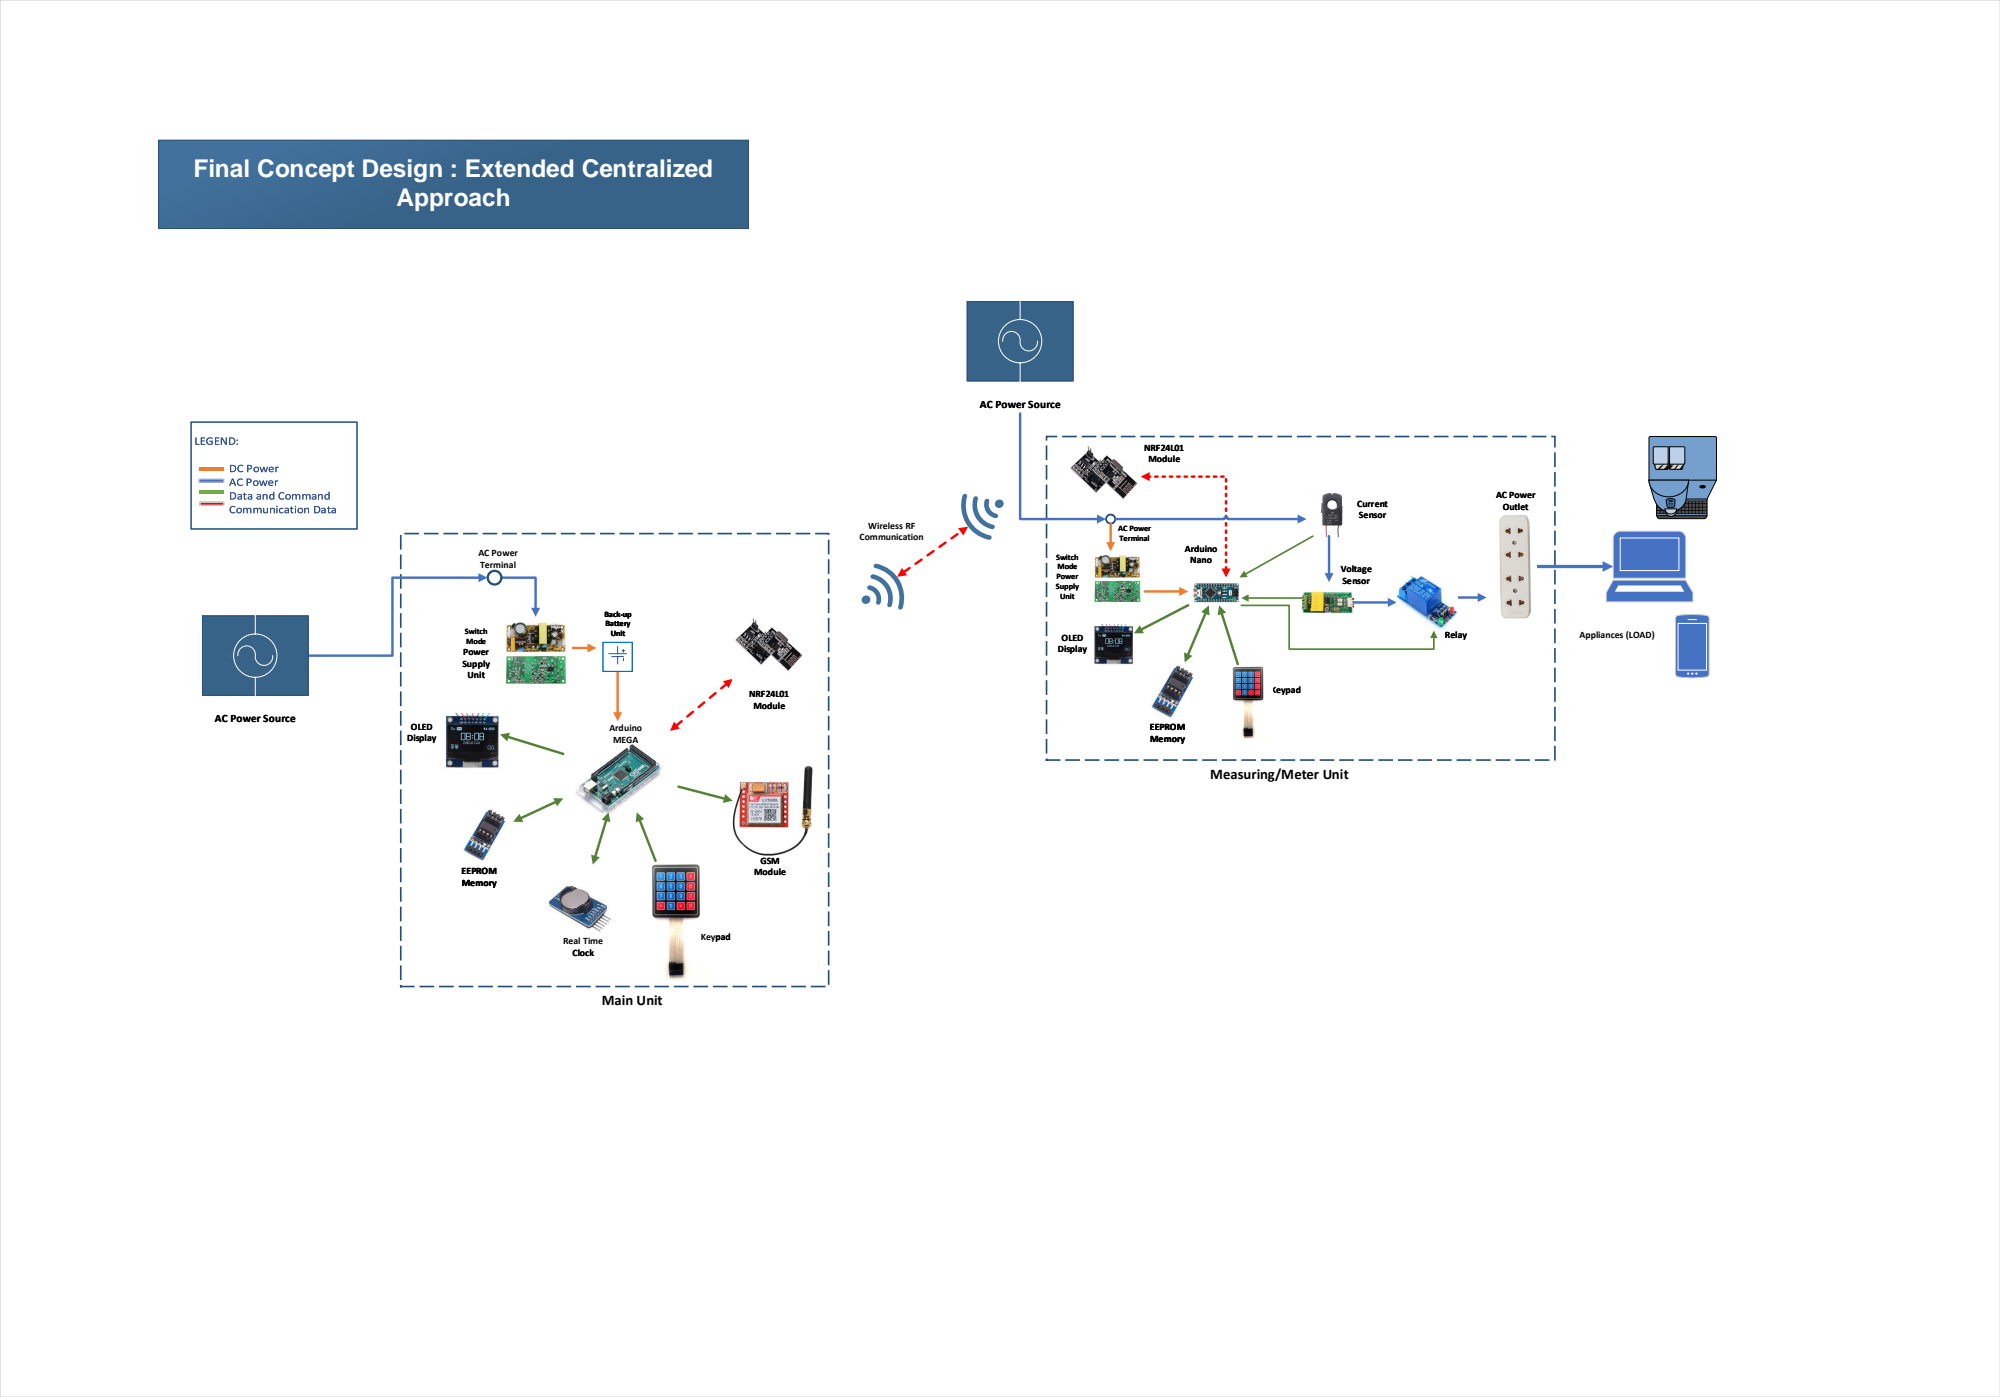
[picture p175: page 1]
AC Power Terminal; Main Unit; Arduino MEGA; GSM Module; Current Sensor; Arduino Nano; Switch Mode Power Supply Unit; Voltage Sensor; Back-up Battery Unit; OLED Display; Keypad; Appliances (LOAD); EEPROM Memory; Relay; AC Power Outlet; NRF24L01 Module; Wireless RF Communication

AC Power Source

Measuring/Meter Unit

Keypad Real Time
Clock
