theOfficial-IrvinGiL/Thesis-1-and-2-Documentations-and-Papers/CAD and System Schematics/Diagrams/xx.pdf

## YES

NO

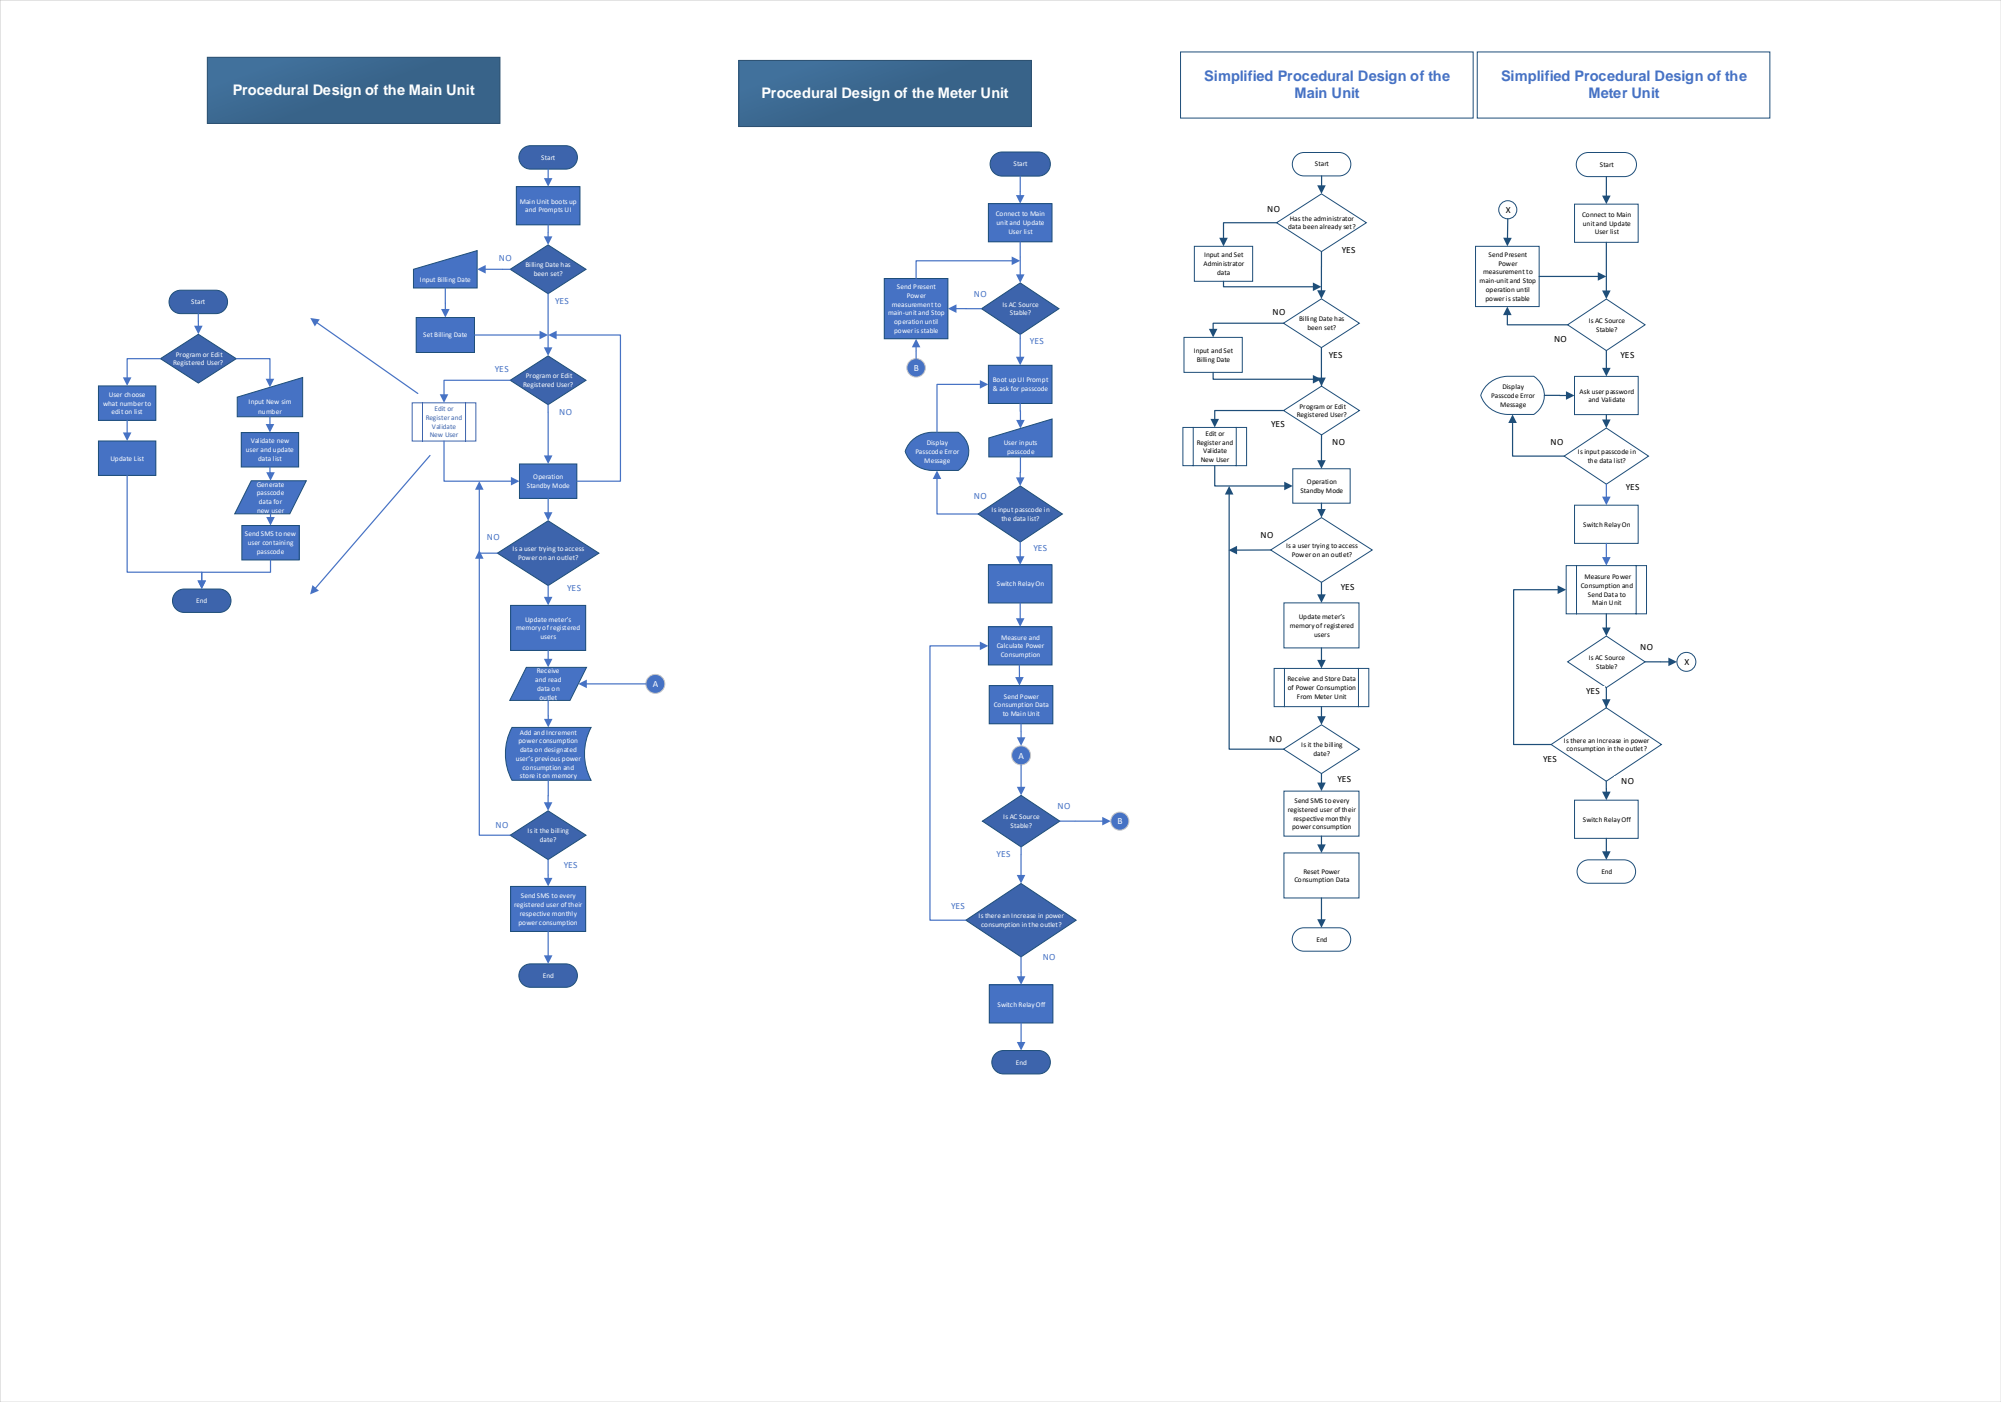
[picture p176: page 1]
Start; Operation Standby Mode; YES; Receive and read data on outlet; users; Generate passcode data for new user; number; Edit or; Register and Validate New User; End; User inputs passcode; Display Passcode Error Message; Measure and Calculate Power Consumption; Main Unit; Update List; Edit or Register and Validate New User; Meter Unit; Reset Power Consumption Data

Simplified Procedural Design of the

Procedural Design of the Main Unit

Procedural Design of the Meter Unit

Main Unit boots up
and Prompts UI

Connect to Main
unit and Update
User list

Has the administrator
data been already set?

Input and Set
Administrator
data

Send Present
Power
measurement to
main-unit and Stop
operation until
power is stable

Billing Date has
been set?

Input Billing Date

Is AC Source
Stable?

Set Billing Date

Program or Edit
Registered User?

Billing Date

Boot up UI Prompt
& ask for passcode

User choose
what number to
edit on list

Ask user password
and Validate

Input New sim

YES

Validate new
user and update
data list

Is input passcode in
the data list?

Switch Relay On

Send SMS to new
user containing
passcode

Is a user trying to access
Power on an outlet?

Measure Power
Consumption and
Send Data to
Main Unit

Update meter’s
memory of registered

Receive and Store Data
of Power Consumption
From Meter Unit

Send Power
Consumption Data
to Main Unit

Add and Increment
power consumption
data on designated
user’s previous power
consumption and
store it on memory

Is it the billing
date?

Is there an Increase in power
consumption in the outlet?

Send SMS to every
registered user of their
respective monthly

Switch Relay Off
