theOfficial-IrvinGiL/Thesis-1-and-2-Documentations-and-Papers/(list of files, drawings)

Other design files:
CAD and System Schematics/Circuit Schematic.fzz
drafts/Arduino draft files/circuit diagrams/MAIN draft 1.1.fzz
