theOfficial-IrvinGiL/Thesis-1-and-2-Documentations-and-Papers/(commit log)

2022-03-27 sample commit
2022-04-07 -commit as of April 8, 2022 -changed the system design flow chart
2022-05-01 - completed the main papers
    [Data_Log.xlsx]
2022-05-18 - approved and printed final manuscript for book binding - project success | May 2022 |
    [Data_Log.xlsx, MAIN draft 1.1.fzz]
